MicheleLamberti/mtp-f26-teamc/hw/teamc-carrier/teamc-carrier_render_iso.png

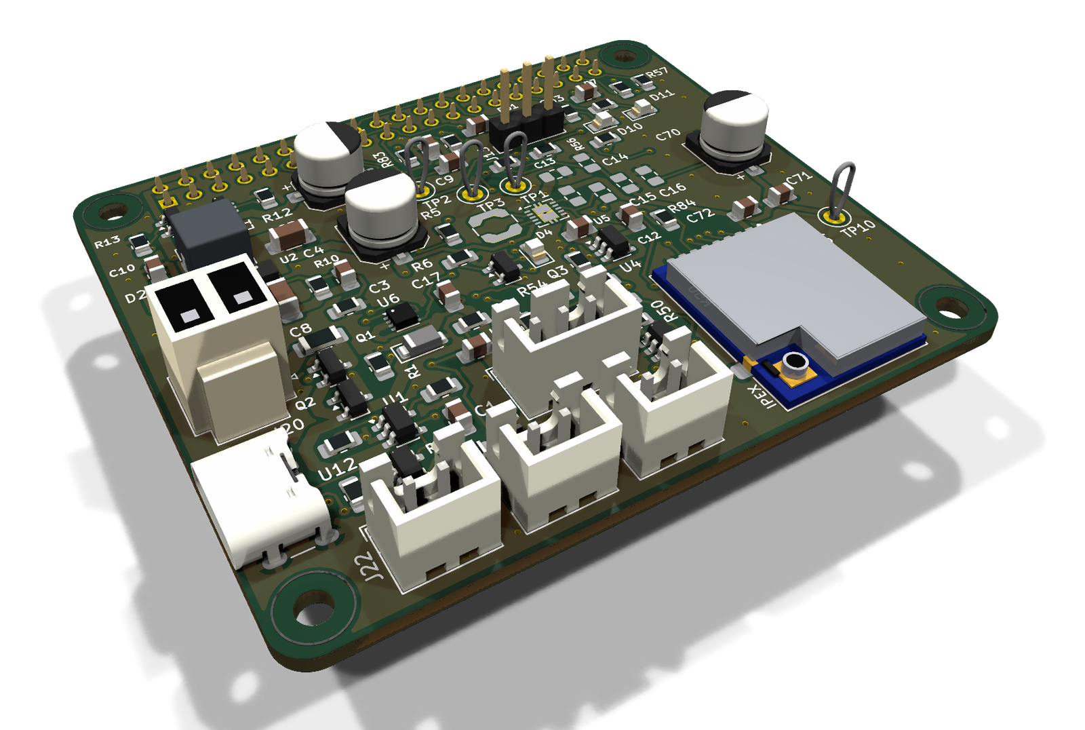
hw/teamc-carrier/teamc-carrier_render_iso.png
