MicheleLamberti/mtp-f26-teamc/hw/teamc-carrier/teamc-carrier_render_stack.png

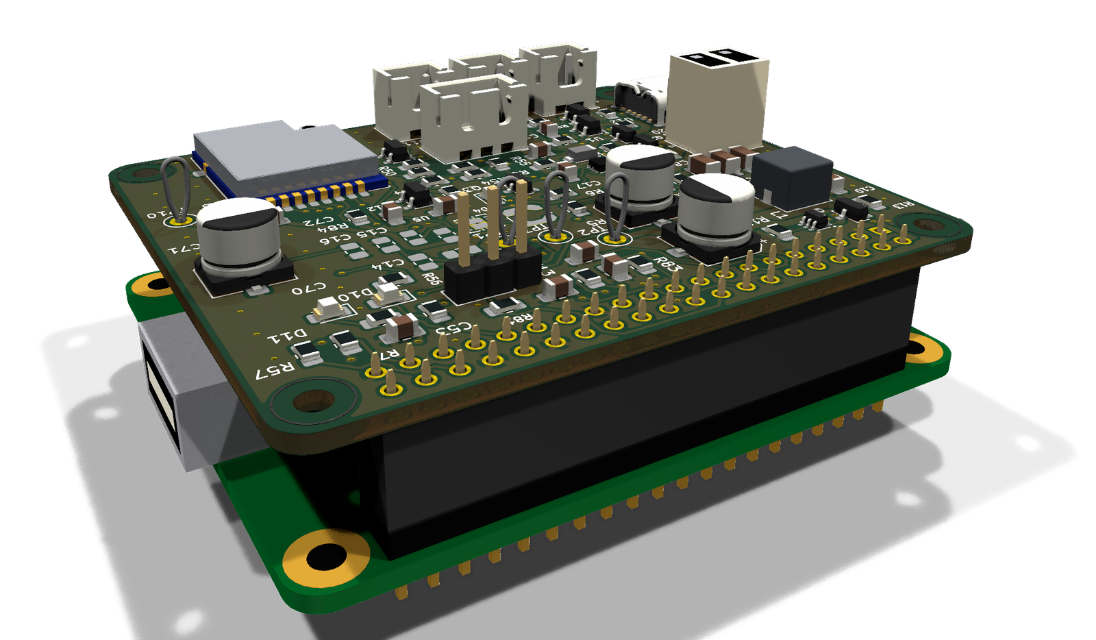
hw/teamc-carrier/teamc-carrier_render_stack.png
