MicheleLamberti/mtp-f26-teamc/docs/task_11_unicode/report/validacion.tex

% Generado por codigo/validar_task11.py. No editar a mano.
\newcommand{\TestsPassed}{172}
\newcommand{\TestsTotal}{172}
\newcommand{\SampleCount}{21}
\newcommand{\FragmentCases}{147}
\newcommand{\PythonVersion}{3.12.14}
