MicheleLamberti/mtp-f26-teamc/radio/HANDOFF_ET.md

# Radio → Electronics handoff — Ebyte E01-ML01SP4 (nRF24L01+ PA/LNA), 2.4 GHz, one omni

From: Radio Team (Santiago, Andrian, Marcos) · To: Electronics Team (Carlos, Michele, Bikash,
Guillem) · Version 0.5, 18-Oct-26 (v0.5: the micro is a Raspberry Pi 3, see `pi3_impact.html`; v0.4: D-R6, higher TX
power while hopping in SRI/MRM; v0.3 SP4 + omni;
v0.2 had two DP5 modules and patches; v0.1 the RFM69 at 868 MHz) ·
Status: **module and antenna decided 13-Oct (Santiago, with Marcos)**, see `DECISIONS.md` D-R2c / D-R5c.

Per the team's division of decisions, the RT picks the transceiver and ET adapts to it and picks
the micro. This sheet lists what the micro and board must provide.

## Part

- **Ebyte E01-ML01SP4**, one per box: genuine Nordic nRF24L01P + PA/LNA, SMD **14.5 × 18 mm** (19-Oct: the
  manual's drawing; the 14.85 in its spec table is a copy-paste error), **8 castellated pads at 1.27 mm on one short
  edge + 2 GND half-holes on the long edges**, **IPEX (U.FL) antenna socket on the module**. Not the E01C-* parts (Si24R1 clone).
- Antenna (19-Oct): **Ebyte TX2400-FPC-2509** flex (25 × 9 mm, 100 mm cable, IPEX) plugged straight into the module,
  stuck vertically on a box wall. No RF trace or RF connector on our PCB. Fallback if it fails TEST_PLAN T5b: the
  **Molex 146153-0100** (34.9 × 9 mm, same plug), so leave 35 mm on the wall.
- **Ordered 19-Oct (Santiago):** 2 × Raspberry Pi 3 A+; 4 × SP4 from Ebyte (2 with the FPC-2509, 2 with the
  TX2400-JKS-IPX20 rod + IPEX-to-SMA cable for the bench). The two rod-kit SP4s are the spares (same module; move the flex antenna over if a box module dies). Still needed:
  2 × microSD (8–16 GB, A1), a 5.1 V ≥ 2.5 A micro-USB supply for the bench, SMA pads 1–10 dB.

## Electrical interface (Ebyte E01-ML01SP4 user manual, section 3)

| Pad | Signal | Direction (micro) | Notes |
|---|---|---|---|
| 1 | VCC | supply | **2.0–3.6 V, abs. max 3.6 V.** Never the battery rail (Li-ion reaches 4.2 V). ~120 mA peak in TX, 26 mA in RX |
| 2 | CE | out | High = RX on / pulse ≥ 10 µs = send one frame |
| 3 | CSN | out | SPI chip select, active low |
| 4 | SCK | out | **SPI mode 0**, MSB first, ≤ 10 MHz (4 MHz default since 23-Oct for the rev B ribbon; plenty: 250 kbps = 31 kB/s) |
| 5 | MOSI | out | |
| 6 | MISO | in | |
| 7 | IRQ | in (optional) | Active low: TX done / RX ready. The driver polls today |
| 8–10 | GND | — | Solid ground under the module; no traces under it on the top layer (Ebyte §4.1) |

The module drives its own PA/LNA switch from the nRF24, so there is **no TXEN/RXEN** to wire.
Footprint (19-Oct, `hw/lib/teamc.pretty/E01-ML01SP4.kicad_mod`, from the manual rev 1.7 §3 drawing): pins 1–8 are
castellations on one 14.5 mm edge (0.80 mm wide, pin 1 on the right in the top view), pins 9/10 are Ø1.5 GND
half-holes on the long edges, 13.0 mm from the pad edge. Measure one module (14.5 mm) before the carrier goes to fab.
The breakout for the bench is ready: `hw/sp4-breakout/` (DRC-clean, gerbers + 1:1 copper PDF).

## Power

- A dedicated **3.3 V LDO for the radio** (e.g. AP2112K-3.3 or TLV75533, ≥ 300 mA) from the switched battery
  rail, with **100 µF + 10 µF + 100 nF** at the module. PA/LNA modules are sensitive to supply noise:
  short, wide VCC/GND, away from the 5 V boost.
- **D-R6 (baseline since 16-Oct):** SRI/MRM hop at up to 20 dBm e.i.r.p., so the same SP4 runs at RF_PWR −12
  or −6 and TX bursts move toward the datasheet's **120 mA**. Same parts; size the LDO,
  the bulk capacitor and the battery path for 120 mA peaks (they already are). No hardware change.
- **Low battery (16-Oct): the LDO is fine, plus four countermeasures.** The LDO regulates 3.3 V down to a cell
  of ~3.4 V (pick a part with **dropout ≤ 0.1 V at 150 mA**: AP2112K-3.3 and TLV75533 both qualify). Below that it
  passes the cell through, ≥ 2.95 V at the cell's 3.0 V protection cutoff, still inside the SP4's 2.0–3.6 V. A Li-ion
  cell spends ~90 % of its charge above 3.4 V at our load. An LDO after the 5 V boost (~60 % efficient overall, boost
  ripple at the PA) or a 5 V battery (2S pack or power bank) would be worse.
  1. **Battery sense (Pi 3, 18-Oct):** the Pi has no ADC, so a **MAX17048** fuel gauge on I2C1 (GPIO 2/3) reads the
     cell voltage and state of charge. The ideal diode into the Pico's VSYS is no longer needed.
  2. **Firmware thresholds** (cell voltage, radio idle): ≥ 3.5 V normal · 3.4–3.5 V status-LED warning "charge before
     the next round" · < 3.4 V at setup: loud warning (never block or stop a round) · < 3.2 V during a round: write the
     received data and progress to the SD card (fdatasync) after every burst, so a brown-out loses nothing. Re-measure
     the thresholds at T0 under the Pi's load: the cell sags more at 0.5–1 A.
  3. **T0** measures the SP4 output with its VCC at 3.6, 3.3 and 3.0 V (`TEST_PLAN.md`).
  4. **Alternative if T0 shows > 2 dB less output at 3.0 V:** a buck-boost (TPS63001 / TPS63020) holds 3.3 V down to
     ~2.5 V at 90–95 %, but needs a ferrite + 10 µF filter at the module and careful layout (switching ripple).
- **The Pi 3's own supply (18-Oct):** a **5.1 V boost rated ≥ 2.5 A** from the cell, always on, into the header 5 V
  pins (2, 4), with a TVS and reverse-polarity protection (that path bypasses the Pi's input protection) and ≥ 100 µF.
  The Pi draws ~0.3–0.6 A at 5 V, so up to ~2 A from the cell near 3.0 V. Below 4.63 V the Pi flags undervoltage.
  Keep the radio LDO on the cell, **never on the Pi's 3V3 pin**, and keep the boost away from the SP4.

## What the micro needs (radio side only)

- One SPI master plus CSN, CE and IRQ: **6 GPIOs** (5 without IRQ).
- A microsecond clock and a busy-wait delay: everything the driver's HAL needs (`fw/nrf24.h`).
- Proposed **Raspberry Pi 3** pins (BCM numbers, header pin): SPI0 SCK GPIO 11 (23), MOSI GPIO 10 (19), MISO GPIO 9
  (21), CSN = SPI0 CE0 GPIO 8 (24, driven by the kernel), CE GPIO 22 (15), IRQ GPIO 24 (18). Wire IRQ on the Pi: its
  edge timestamps make the hop sync accurate under Linux. Full map in `hw/KICAD_SESSION_PROMPT.md`.
- **No WiFi/BT chip on the board** (protocol ban). The Pi 3 carries one (CYW43455 / BCM43438): working assumption
  (18-Oct) is that it is disabled for good (`dtoverlay=disable-wifi`, `disable-bt`) or desoldered; Atenea Q22 asks.

## Breakout from day one

Modules shown at Quick Mode are final, and the SP4 is SMD. So the first bench test already needs the SP4
on a small breakout (lab-made, 1.27 mm pads → 2.54 mm header) or on the carrier PCB. There is no
breadboard-friendly variant of the same part.

## Firmware

`radio/fw/` is a portable C99 driver (no Arduino or vendor dependencies) with host tests
(`make -C radio/fw test`, 244 checks against a mock nRF24). The board only has to implement
`nrf24_hal_t`: select, transfer, ce, delay_us, micros. On the Pi 3 (Linux): spidev with one ioctl per command,
libgpiod for CE/IRQ, `delay_us` as a busy-wait on `CLOCK_MONOTONIC`, `core_freq=250` so the SPI clock is fixed. Register profiles come from
`radio/phy_config.py`. The driver refuses any power setting above RF_PWR −18 dBm (10 mW e.i.r.p. limit),
except for the hopping profile `TEAM_FHSS` (D-R6, the SRI/MRM baseline), which may use −12 (or −6 once T0 shows the PA gain allows it) but must pass a listen-before-talk
check (`nrf24_cca`) before every burst. It needs the 100 ms power-on wait and nothing else from the board.

## Placement and antenna

- Module near the wall that carries the antenna, so the 100 mm cable reaches without strain.
- **Drop test:** secure the U.FL plug on the SP4 (a dot of glue or Kapton tape over it) and tie the cable down
  near the module; a 100 mm cable with a loose box wall can pull the plug off on impact.
- Antenna vertical, **as high in the box as possible** (antenna height is our biggest link-budget lever),
  ≥ 1–2 cm from the battery, the PCB copper, the USB cable and the 5 V boost. With the Pi 3, keep the SP4 at the
  board edge away from the processor (clock harmonics: 6 × 400 MHz = 2400 MHz); T0 checks the noise per hop channel.

## Needed back from ET

1. OK on the SP4, the radio LDO and the pin map.
2. Who makes the SP4 breakout for the first bench test, and when.
3. Power budget check: battery + regulators deliver the TX peak and the Pi's 5 V load without brown-out.
5. Which Pi 3 model (A+ suggested) and how many boards we already have; a desoldering trial on one spare.
4. The box inside height and where the antenna can sit highest.
