MicheleLamberti/mtp-f26-teamc/hw/sp4-breakout/sp4-breakout_render_iso.png

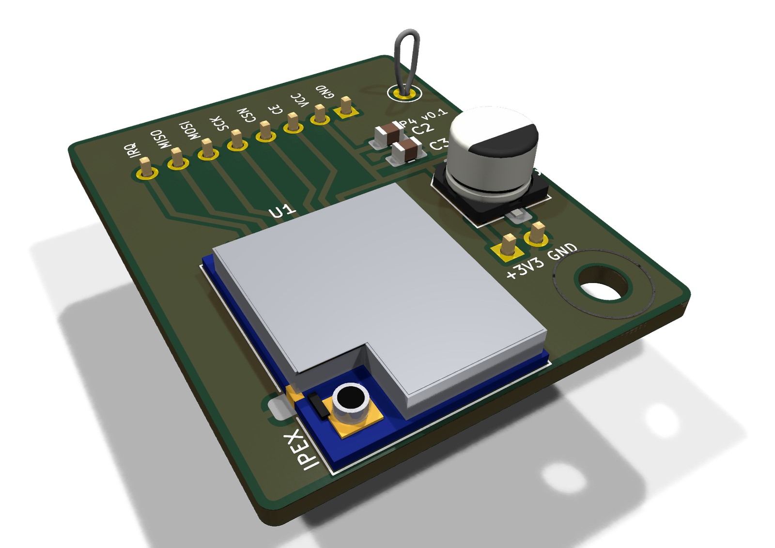
hw/sp4-breakout/sp4-breakout_render_iso.png
