MicheleLamberti/mtp-f26-teamc/hw/teamc-carrier-lab/teamc-carrier-lab_render_iso.png

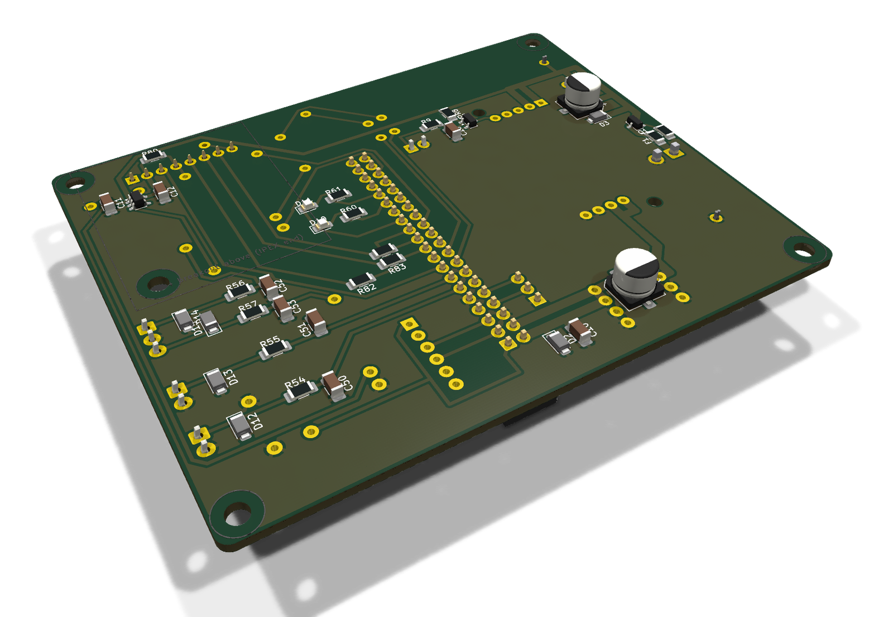
hw/teamc-carrier-lab/teamc-carrier-lab_render_iso.png
