MicheleLamberti/mtp-f26-teamc/hw/teamc-carrier-lab/teamc-carrier-lab_render_top.png

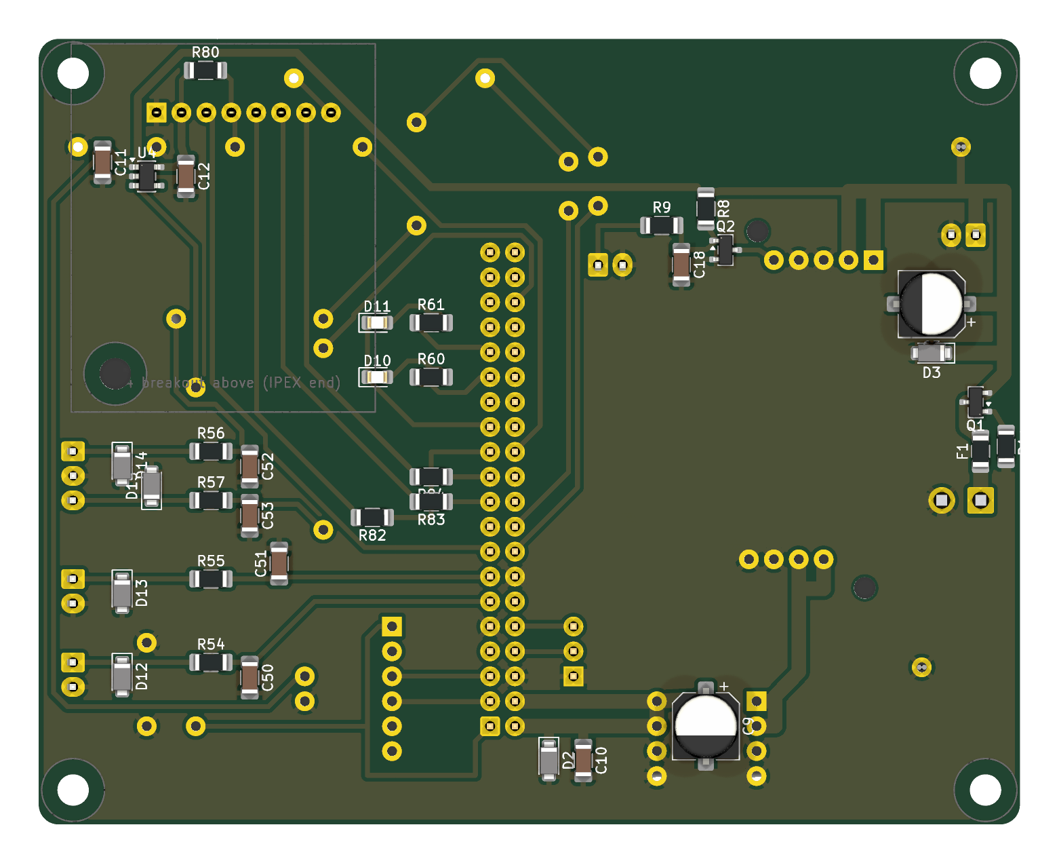
hw/teamc-carrier-lab/teamc-carrier-lab_render_top.png
