MicheleLamberti/mtp-f26-teamc/hw/teamc-carrier-simple/breakout_placement.png

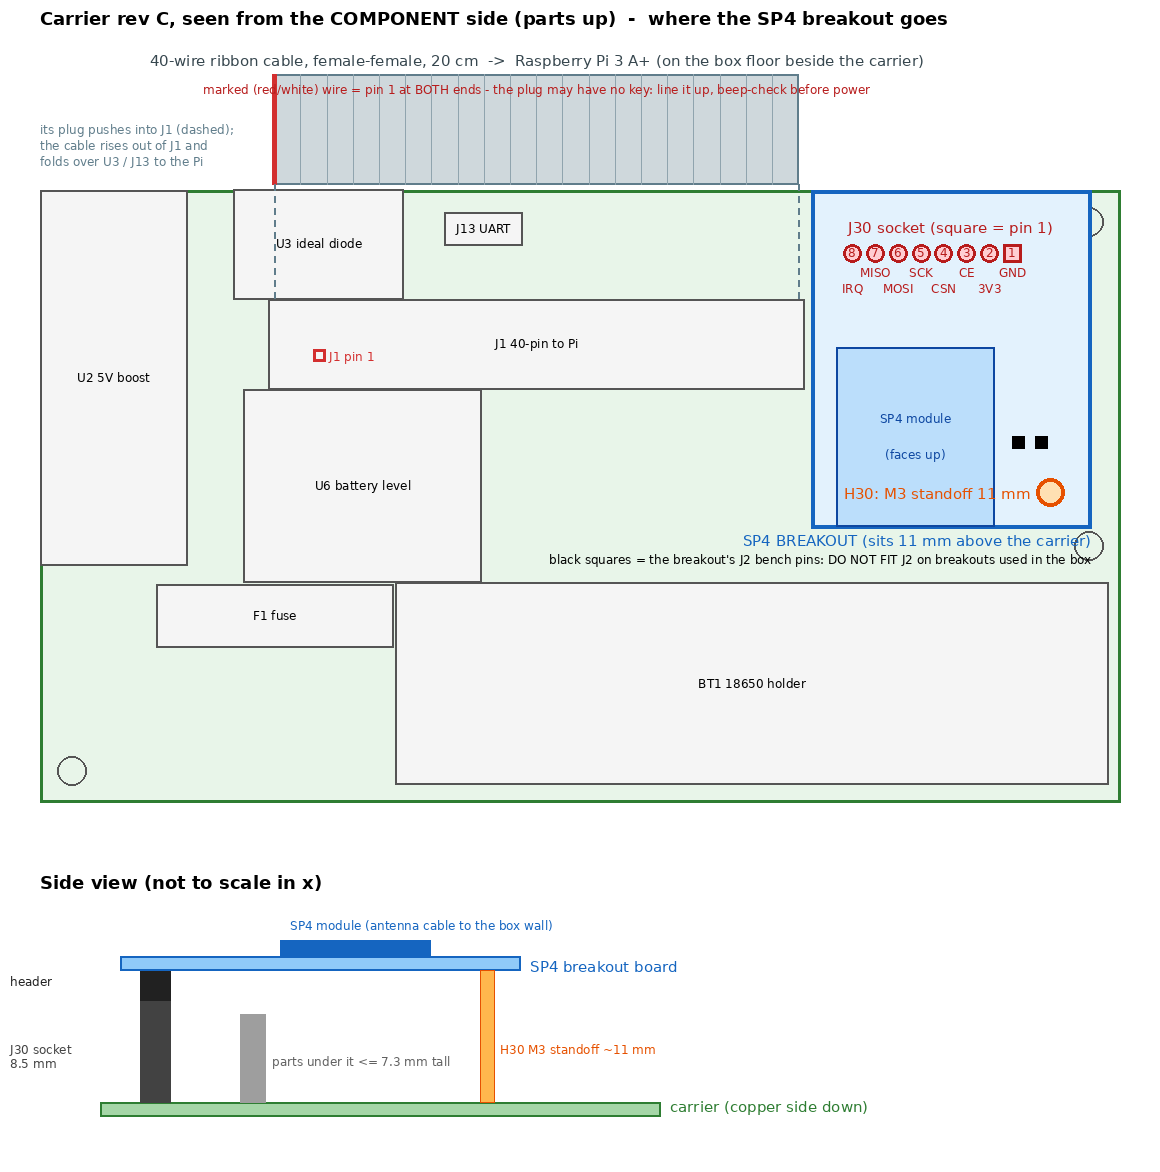
hw/teamc-carrier-simple/breakout_placement.png
