MicheleLamberti/mtp-f26-teamc/hw/teamc-carrier-simple/concept_block_diagram.png

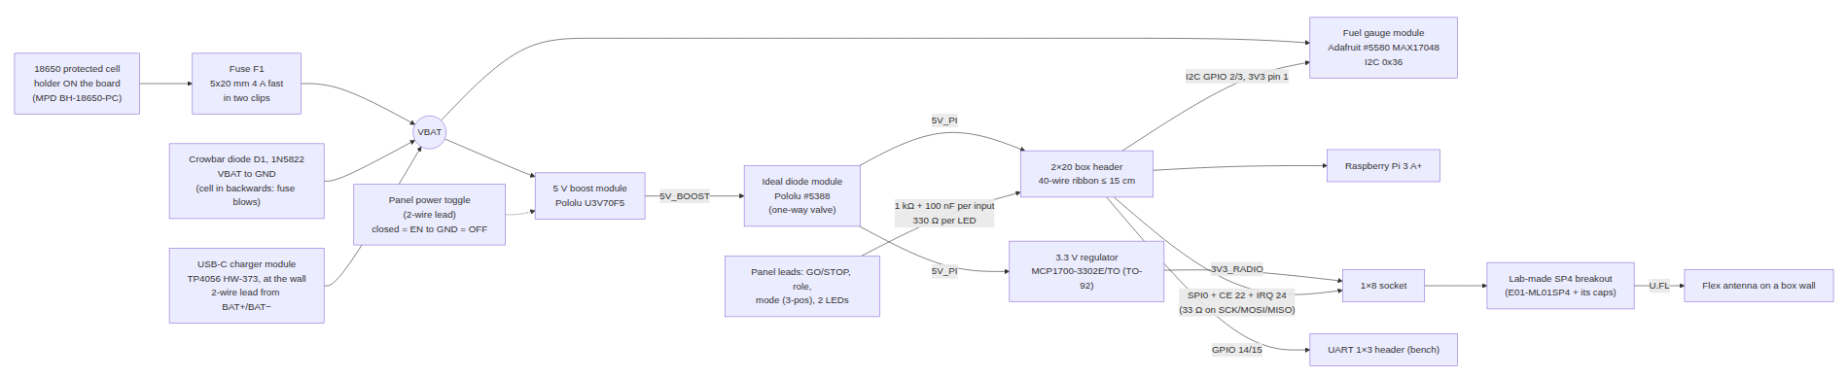
hw/teamc-carrier-simple/concept_block_diagram.png
