MicheleLamberti/mtp-f26-teamc/hw/teamc-carrier-simple/concept_floorplan.png

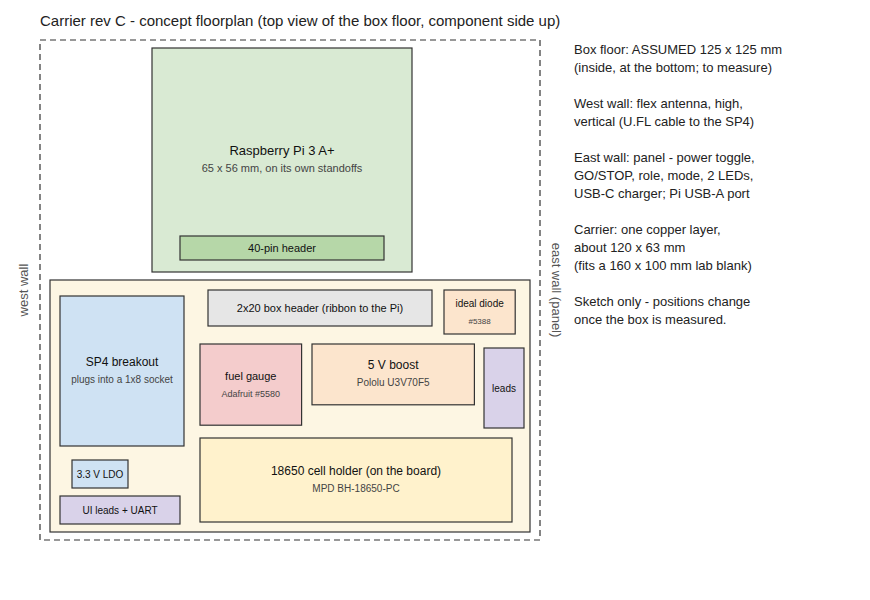
hw/teamc-carrier-simple/concept_floorplan.png
