MicheleLamberti/mtp-f26-teamc/hw/teamc-carrier-simple/teamc-carrier-simple_render_bottom.png

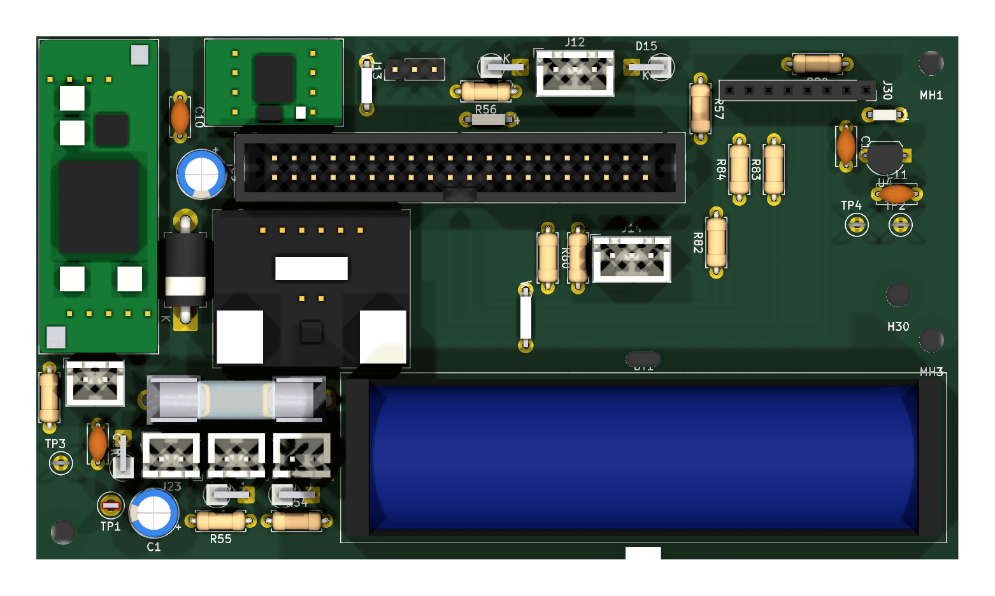
hw/teamc-carrier-simple/teamc-carrier-simple_render_bottom.png
