MicheleLamberti/mtp-f26-teamc/hw/teamc-carrier-simple/teamc-carrier-simple_render_iso.png

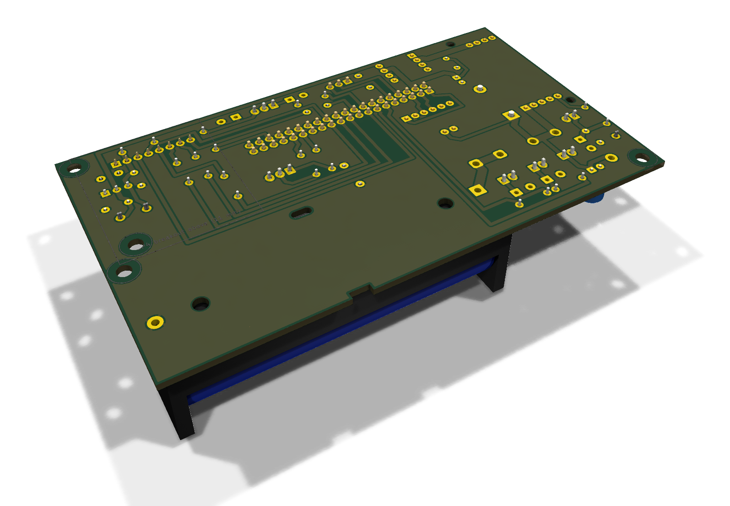
hw/teamc-carrier-simple/teamc-carrier-simple_render_iso.png
