MicheleLamberti/mtp-f26-teamc/hw/teamc-carrier-simple/teamc-carrier-simple_render_top.png

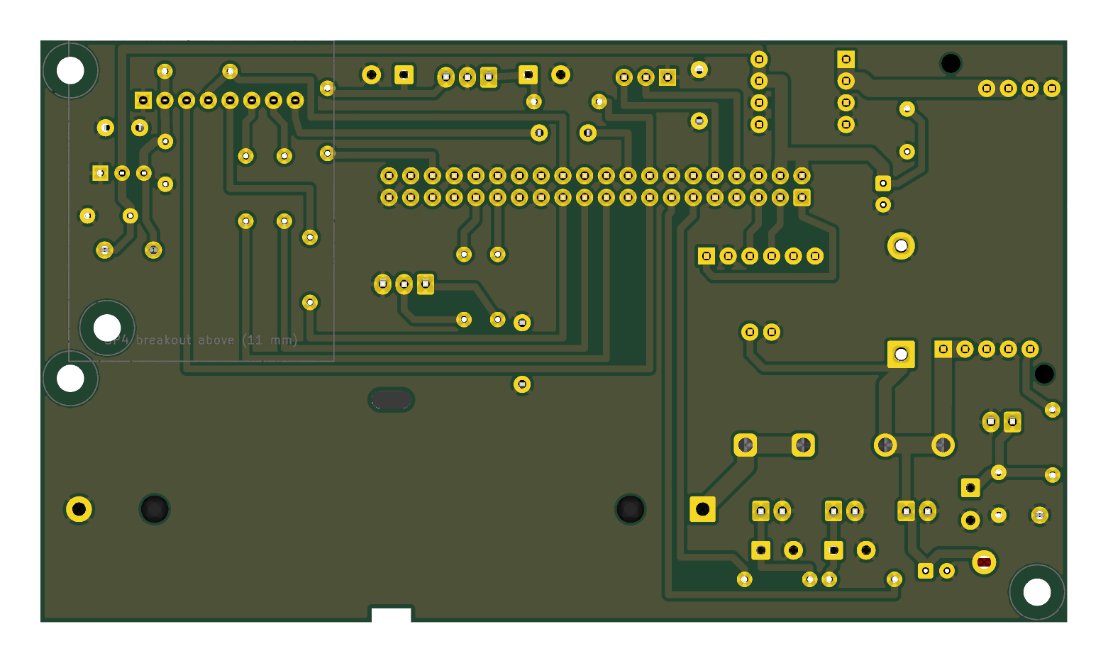
hw/teamc-carrier-simple/teamc-carrier-simple_render_top.png
