MicheleLamberti/mtp-f26-teamc/hw/teamc-carrier/teamc-carrier_render_bottom.png

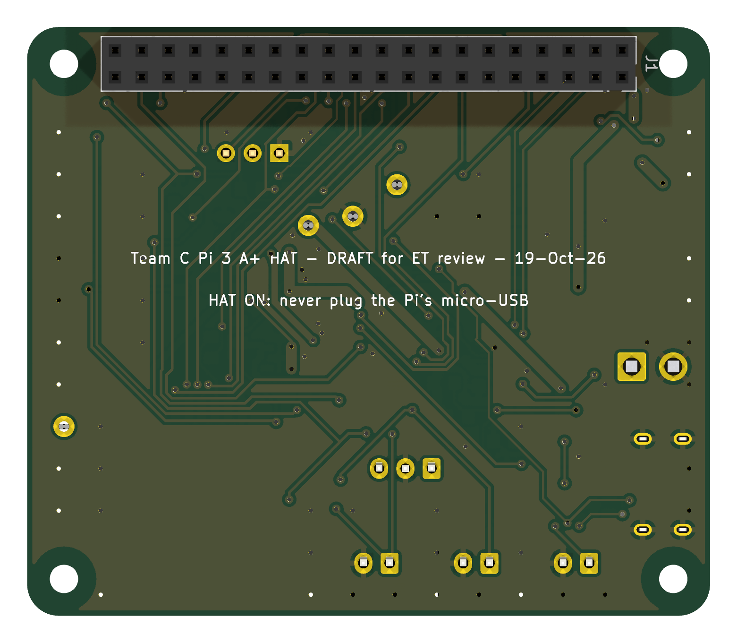
hw/teamc-carrier/teamc-carrier_render_bottom.png
