MicheleLamberti/mtp-f26-teamc/hw/teamc-carrier/teamc-carrier_render_top.png

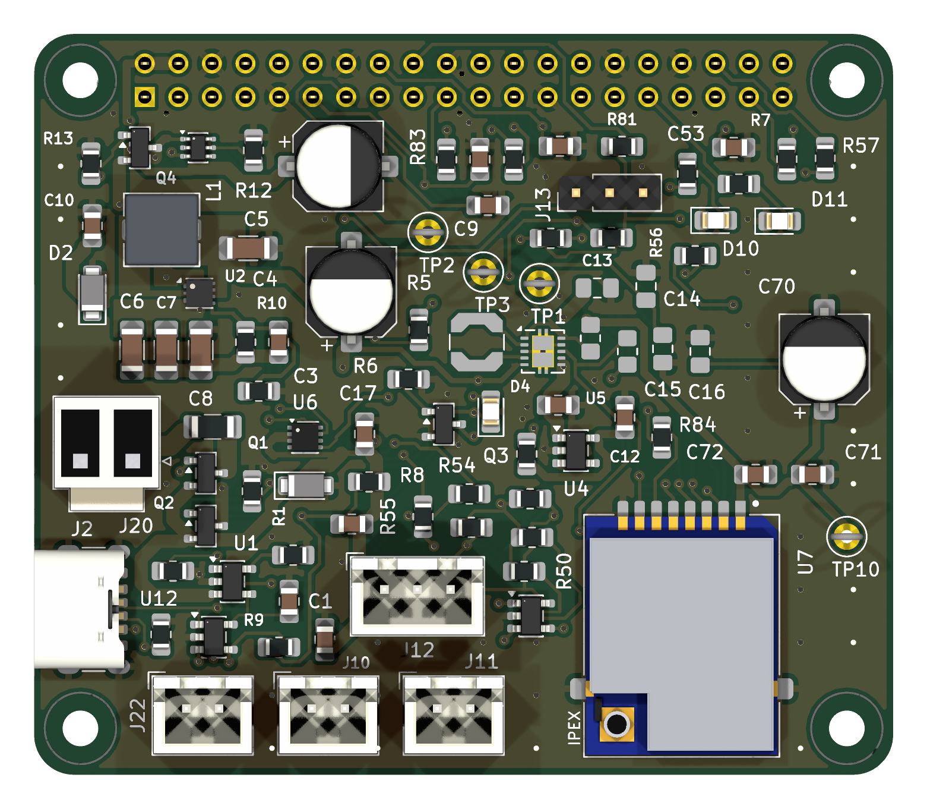
hw/teamc-carrier/teamc-carrier_render_top.png
