MicheleLamberti/mtp-f26-teamc/hw/teamc-carrier-simple/order/order_check.md

# Carrier rev C order check, 3 boards, 24-Oct-26

Prices EUR excl. VAT, read on DigiKey.es product pages today.

| Ref | MPN | Shop | PN | Qty (3 boards) | Unit | Line | Stock (24-Oct-26) | Status | Note |
|---|---|---|---|---|---|---|---|---|---|
| U2 | 2891 (Pololu U3V70F5) | DigiKey | 2183-2891-ND | 3 | 22.7800 | 68.34 | 152 | OK |  |
| U3 | 5388 (Pololu ideal diode) | DigiKey | 2183-5388-ND | 3 | 5.7000 | 17.10 | 500 (marketplace) | OK |  |
| U4 | MCP1700-3302E/TO | DigiKey | MCP1700-3302E/TO-ND | 4 | 0.4400 | 1.76 | 11,755 | OK | 1 spare; first break at 25 |
| BT1 | BH-18650-PC | DigiKey | BH-18650-PC-ND | 3 | 2.9400 | 8.82 | 9,726 | OK | Inside length not verified (datasheet URL 404) |
| D1 | 1N5822 (ST, DO-201AD) | DigiKey | 497-11370-1-ND | 4 | 0.5400 | 2.16 | 14,375 | OK (obsolete) | ST marks it end-of-life; stock fine. Drop-in alt: Taiwan Semi 1N5822 (detail /7366597) |
| D12-D16 | P4KE10A (DO-204AL/DO-41) | DigiKey | 18-P4KE10ACT-ND | 15 | 0.3710 | 5.56 | 1,543 | OK | price at qty-10 break |
| F1 | 3517 (Keystone fuse clip) | DigiKey | 36-3517-ND | 6 | 0.4200 | 2.52 | 50,892 | OK | 5 mm dia clip, 15 A, accepts 5x20 |
| F1 | 0217004.HXP (4 A 5x20 glass) | DigiKey | F2394-ND | 6 | 0.4400 | 2.64 | 4,721 | OK | 1 fitted + 1 spare per box; qty-5 break |
| C1 C9 | EEU-FR1C101 -> KEMET ESS107M016AE2EA | DigiKey | 399-18280-1-ND | 10 | 0.1140 | 1.14 | 14,855 | CHANGED | EEU-FR1C101 is 5.0 mm dia / 2.00 mm leads (wrong footprint). Exact-footprint EEU-FC1C101 (6.3/2.5, P11198-ND) is 0 stock (37 wk). KEMET: 6.3 mm, 2.50 mm, 8.5 mm tall, 105C; need 6, buy 10 at qty-10 break |
| C10 C18 | K104K10X7RF5UH5 | DigiKey | BC2665CT-ND | 10 | 0.1550 | 1.55 | 186,026 | OK | 5.00 mm leads confirmed |
| C11 C12 | FG28X7R1E105KRT06 | DigiKey | 445-173583-1-ND | 10 | 0.1830 | 1.83 | 85,335 | OK | 5.00 mm leads confirmed |
| R9 R54-R57 | MFR-25FBF52-1K | DigiKey | 1.00KXBK-ND | 20 | 0.0370 | 0.74 | 46,691 | OK | 15 needed |
| R60 R61 | MFR-25FBF52-330R | DigiKey | MFR-25FBF52-330R-ND | 10 | 0.0390 | 0.39 | 10,048 (search page) | OK | PN/stock from search listing, not detail page; 6 needed; price at qty 10 per search page |
| R80 | MFR-25FBF52-10K | DigiKey | 10.0KXBK-ND | 10 | 0.0370 | 0.37 | 48,789 | OK | 3 needed |
| R82-R84 | MFR-25FBF52-33R | DigiKey | 13-MFR-25FBF52-33R-ND | 10 | 0.0370 | 0.37 | 12,331 | OK | 9 needed |
| TP1 | 5010 (Keystone red) | DigiKey | 36-5010-ND | 3 | 0.3000 | 0.90 | 257,390 | OK |  |
| J1 | 61204021621 | DigiKey | 732-5401-ND | 3 | 1.0100 | 3.03 | 1,700 | OK |  |
| J30 | PPTC081LFBN-RC | DigiKey | S7006-ND | 3 | 0.5100 | 1.53 | 84,501 | OK | insulation height 8.51 mm |
| J13 + modules | PRPC040SAAN-RC | DigiKey | S1011EC-40-ND | 3 | 1.0800 | 3.24 | 45,098 | OK |  |
| J10 J11 J22 J23 | B2B-XH-A | DigiKey | 455-B2B-XH-A-ND | 12 | 0.0760 | 0.91 | 235,434 | OK | (LF)(SN) is the RoHS suffix of same part; qty-10 break |
| J12 J14 | B3B-XH-A | DigiKey | 455-2248-ND | 6 | 0.1100 | 0.66 | 65,453 | OK |  |
| XHP-2 | XHP-2 | DigiKey | 455-2266-ND | 12 | 0.0520 | 0.62 | 219,487 | OK | qty-10 break |
| XHP-3 | XHP-3 | DigiKey | 455-2219-ND | 6 | 0.0900 | 0.54 | 137,940 | OK |  |
| crimps | SXH-001T-P0.6 | DigiKey | 455-1135-100-ND | 100 | 0.0414 | 4.14 | 6,700 | CHANGED | loose-piece/cut tape not offered; smallest strip is 100 pcs (48 needed). 22-28 AWG |
| pushbutton | PS1024ABLK | DigiKey | EG2011-ND | 3 | 1.4600 | 4.38 | 5,531 | OK |  |
| toggles PWR+ROLE | 100SP1T1B1M1QEH | DigiKey | EG2350-ND | 6 | 2.7000 | 16.20 | 8,552 | OK | 6 = 2 per box (role toggle may stay unfitted) |
| toggle MODE | 100SP3T1B1M1QEH | DigiKey | EG2375-ND | 3 | 4.7500 | 14.25 | 2,223 | OK |  |
| LED green | WP7113GD | DigiKey | 754-1263-ND | 10 | 0.1350 | 1.35 | 91,488 | OK | 3 needed, buy 10 (qty-10 break) |
| LED red | WP7113ID -> WP7113SURDK | DigiKey | 754-WP7113SURDK-ND | 10 | 0.1680 | 1.68 | 11,546 | CHANGED | WP7113ID (754-1264-ND) is 0 stock until 10-Dec-26. SURDK = red diffused T-1 3/4, 630 nm; check R60/R61 value (330R) still OK for brightness |
| LED clips | RTC51 (Kingbright) | DigiKey | 754-RTC51-ND | 6 | 0.4500 | 2.70 | 1,047 | CHANGED | moved from TME (TME min order 10, extra shipment) to DigiKey |
| MH1-3 | 25510 (Keystone M3x10 nylon F/F) | DigiKey | 36-25510-ND | 12 | 0.5900 | 7.08 | 19,042 | CHANGED | now sourced; 4/box (3 holes + 1 spare) |
| H30 | MTS-11 (Essentra M3x11 nylon F/F) | DigiKey | RPC4425-ND | 3 | 0.6800 | 2.04 | 12,230 | CHANGED | now sourced |
| screws M3x6 | 50M030050P006 (Essentra nylon) | DigiKey | RPC7002-ND | 40 | 0.0768 | 3.07 | 61,147 | CHANGED | now sourced; 30 needed + 10 spare; qty-25 break |
| screws M2.5 Pi | 50M025045P006 (Essentra nylon M2.5x6) | DigiKey | 145-50M025045P006-ND | 20 | 0.0940 | 1.88 | 5,784 | CHANGED | 16 needed for 2 Pis + 4 spare; qty-10 break. M2.5 standoffs NOT found on DigiKey |
| U6 | Adafruit 5580 (MAX17048) | Kiwi | ADA-5580 | 3 | 5.6900 | 17.07 | 41 | OK | EUR 6.88 incl VAT |
| ribbon | 40-way F/F GPIO ribbon 20 cm | Kiwi | 1160 (40 pins Rainbow GPIO cable 20cm) | 3 | 2.7900 | 8.37 | 50 | NOT VERIFIED | page does not say F/F or keyed; 20 cm not 15 |
| cell | Keeppower P1835J 3500 mAh protected | nkon.nl | keeppower-18650-3500-li-ion | 3 | 8.2200 | 24.66 | in stock | NOT VERIFIED | EUR 9.95 incl NL VAT; 69.1 mm; 10 A; Spain shipping unconfirmed |
| TP4056 | TP4056 USB-C + DW01A module | Amazon.es | (pick live listing) | 4 | 1.6500 | 6.60 | not read | NOT VERIFIED | estimate: 5-pack ~EUR 8 incl VAT; Amazon.es blocked (503) |

## Totals

| Shop | excl. VAT | incl. 21 % |
|---|---|---|
| DigiKey | 185.50 | 224.46 |
| Kiwi | 25.44 | 30.78 |
| nkon.nl | 24.66 | 29.84 |
| Amazon.es | 6.60 | 7.99 |
| **Grand total** | **242.20** | **293.07** |

DigiKey free delivery to Spain: orders of EUR 50 or more; below that EUR 18 (text on DigiKey.es pages, not the official policy page; confirm at checkout). The DigiKey cart is far above the threshold. The Pololu items (2183- prefix) are DigiKey marketplace items and may ship separately.
No shipping was added for Kiwi, nkon or Amazon.es (not read). Totals above include estimated Amazon.es TP4056 and exclude shipping elsewhere.

## Changes versus the BoM
1. C1 C9: EEU-FR1C101 is 5.0 mm diameter, 2.00 mm lead spacing (DigiKey page), not the 6.3 / 2.50 mm footprint. EEU-FC1C101 (P11198-ND, correct footprint) has 0 stock, 200 expected 18-Dec. Replaced by KEMET ESS107M016AE2EA, 399-18280-1-ND (6.3 mm, 2.50 mm, 8.5 mm tall, 14,855 in stock). Check height against the box and the ripple/ESR needs of the 5 V/3.3 V rail (110 mA at 120 Hz, ESR not given).
2. WP7113ID (red LED): 0 stock until 10-Dec. Replaced by WP7113SURDK.
3. SXH-001T-P0.6: only strips of 100 or more (or reels), so 100 are bought.
4. RTC-51 clips moved from TME to DigiKey (754-RTC51-ND), nylon M3 standoffs and screws, M2.5 screws now sourced on DigiKey.
5. 1N5822 (ST) is marked obsolete but has 14,375 in stock.

## Still blocks ordering
- Protected 18650 fit: MPD BH-18650-PC datasheet (URL 404) not read, so the 69.1 mm Keeppower P1835J fit is unverified. MPD says the holder is designed for cells with protection boards. Check the datasheet or buy one cell first.
- nkon.nl Spain shipping cost and acceptance not confirmed.
- TP4056 USB-C module: Amazon.es blocked (503), so no ASIN/price. Electrokit (85 SEK, out of stock until 30-Oct, Spain not confirmed) and Grobotronics (out of stock) are the only EU pages found. In-stock alternative: Adafruit 4410 (DigiKey 1528-4410-ND, EUR 5.22, 966 pcs) but it is a different board (no DW01A, 0.5 A default); needs ET sign-off.
- 40-way F/F ribbon: Kiwi 1160 not confirmed F/F or keyed, 20 cm vs 15 cm. Kiwi 3016/3017 variants are out of stock or different.
- M2.5 standoffs (4 per Pi): not found on DigiKey; need a source (Amazon.es kit or similar).
- 22 AWG solid hook-up wire and 3.6 mm cable ties: lab stock per BoM; TME FIX-S-3.6X200/BK exists (100 pcs, about EUR 0.02 each) but not worth a TME order.
- 330R resistor PN and stock came from the search listing only (detail page URL for that MPN was not found).

## Update 24-Oct-26 (later) — charger, Pi standoffs, switches
- **Charger:** no TP4056 USB-C module with protection was orderable (TinyTronics 002151 out of stock 2-4 weeks,
  Grobotronics out of stock, Amazon.es AZDelivery 3-pack apparently out of stock, AZ-Delivery shop stock not readable).
  Santiago chose the **Adafruit #4410** (DigiKey 1528-4410-ND, EUR 5.22, 966 in stock) — added to the cart, 3 pcs.
- **M2.5 standoffs:** Kiwi KW-2754 380-piece nylon set (EUR 9.99 excl., 43 in stock) for all Pis; the DigiKey M2.5
  screws (145-50M025045P006-ND) are removed from the cart (the kit has them). Würth 970110155 (732-12996-ND, EUR 1.63)
  was in stock too but costs ~EUR 6.5 per box.
- **Switches to TME** (budget lever): EG2011-ND, EG2350-ND, EG2375-ND removed from the cart; TME PS1024ABLK 1.31,
  100SP1T1B1M1QEH 2.44 (5+), 100SP3T1B1M1QEH 3.26 (USD shown, counted as EUR).
- New totals for 3 boards (excl. VAT): DigiKey ≈ 164.45, Kiwi ≈ 35.43, TME ≈ 28.35, nkon ≈ 24.66 → **≈ 252.89 excl.
  / ≈ 306.0 incl. 21 % VAT** (shipping outside DigiKey not included). BoM per box: **EUR 148.29**.
