MicheleLamberti/mtp-f26-teamc/hw/BOM_revC.csv

ref | qty | value / item | footprint | MPN | manufacturer | supplier | supplier link | stock as read | 3D model source | unit EUR excl. VAT | total EUR | purchased
BT1 | 1 | 18650 protected | Battery:BatteryHolder_MPD_BH-18650-PC | BH-18650-PC (holder; the protected cell is in the BoM off-board) | MPD | DigiKey.es BH-18650-PC-ND | https://www.digikey.es/en/products/detail/mpd-memory-protection-devices/BH-18650-PC/3029216 | 9,726 (23-Oct) | stock kicad-packages3D (fetch_3d.py) | 2.94 | 2.94 | yes
C1 C9 | 2 | 100u 16V | teamc:CP_Radial_D6.3mm_P2.50mm_Pad1.8mm | ESS107M016AE2EA | KEMET | DigiKey.es 399-18280-1-ND (KEMET 6.3 mm, 2.50 mm leads, 8.5 mm tall; qty-10 price) | https://www.digikey.es/en/products/result?keywords=ESS107M016AE2EA | 14,855 (24-Oct) | stock kicad-packages3D model of the footprint it copies (fetch_3d.py) | 0.11 | 0.23 | yes
C10 C18 | 2 | 100n X7R | teamc:C_Disc_D5.0mm_W2.5mm_P5.00mm_Pad1.8mm | K104K10X7RF5UH5 | Vishay | DigiKey.es (Vishay, 5 mm leads; price at qty 10: 6 needed for 3 boxes, buy 10) | https://www.digikey.es/en/products/result?keywords=K104K10X7RF5UH5 | 186,026 (24-Oct) | stock kicad-packages3D model of the footprint it copies (fetch_3d.py) | 0.15 | 0.31 | yes
C11 C12 | 2 | 1u X7R | teamc:C_Disc_D5.0mm_W2.5mm_P5.00mm_Pad1.8mm | FG28X7R1E105KRT06 | TDK | DigiKey.es 445-173583-1-ND (TDK, 5 mm leads; price at qty 10: 6 needed, buy 10) | https://www.digikey.es/en/products/result?keywords=FG28X7R1E105KRT06 | 85,335 (24-Oct) | stock kicad-packages3D model of the footprint it copies (fetch_3d.py) | 0.18 | 0.37 | yes
D1 | 1 | 1N5822 | Diode_THT:D_DO-201AD_P12.70mm_Horizontal | 1N5822 | STMicroelectronics | DigiKey.es (STMicroelectronics) | https://www.digikey.es/en/products/result?keywords=1N5822 | price listed, stock not shown (TME: 221 on 23-Oct) | stock kicad-packages3D (fetch_3d.py) | 0.54 | 0.54 | yes
D12 D13 D14 D15 D16 | 5 | P4KE10A TVS | Diode_THT:D_DO-41_SOD81_P3.81mm_Vertical_CathodeUp | P4KE10A | Littelfuse | DigiKey.es (Littelfuse; price at qty 10, 15 needed for 3 boxes; TME P4KE10A-LF: 0 in stock) | https://www.digikey.es/en/products/detail/littelfuse-inc/P4KE10A/715501 | 1,543 (24-Oct) | stock kicad-packages3D (fetch_3d.py) | 0.37 | 1.85 | yes
F1 | 1 | 4 A fast 5x20 | Fuse:Fuseholder_Clip-5x20mm_Keystone_3517_Inline_P23.11x6.76mm_D1.70mm_Horizontal | 2 x Keystone 3517 clips + 5x20 mm 4 A fast fuse (Littelfuse 0217004.HXP) | Keystone / Littelfuse | DigiKey.es: 2 x Keystone 3517 (EUR 0.42) + Littelfuse 0217004.HXP glass F4A (EUR 0.53; ceramic 0216004.MXP EUR 1.85, 4,517 pcs) | https://www.digikey.es/en/products/result?keywords=0217004.HXP | fuse price listed; clips TME 2,170 (23-Oct) | stock kicad-packages3D (fetch_3d.py) | 1.37 | 1.37 | yes
H30 | 1 | M3 | MountingHole:MountingHole_3.2mm_M3 | M3 x 11 mm nylon standoff F/F + 2 x M3 x 6 nylon screws |  | counted in the off-board mechanics line |  | - | stock kicad-packages3D (fetch_3d.py) | 0.00 | 0.00 | yes
J1 | 1 | RPi GPIO ribbon | teamc:IDC-Header_2x20_P2.54mm_Vertical_Pad2.0mm | 61204021621 (Würth 2x20 shrouded box header, straight THT; any equivalent) | Würth Elektronik | DigiKey.es 732-5401-ND (Würth) | https://www.digikey.es/en/products/result?keywords=61204021621 | 1,700 (24-Oct) | stock kicad-packages3D model of the footprint it copies (fetch_3d.py) | 1.01 | 1.01 | yes
J10 | 1 | GO/STOP button | teamc:JST_XH_B2B-XH-A_1x02_P2.50mm_Vertical_Pad2.0x2.4mm | B2B-XH-A(LF)(SN) | JST | DigiKey.es (JST) | https://www.digikey.es/en/products/result?keywords=B2B-XH-A | price listed (TME B3B: 18,622) | stock kicad-packages3D model of the footprint it copies (fetch_3d.py) | 0.09 | 0.09 | yes
J11 | 1 | role toggle | teamc:JST_XH_B2B-XH-A_1x02_P2.50mm_Vertical_Pad2.0x2.4mm | B2B-XH-A(LF)(SN) | JST | DigiKey.es (JST) | https://www.digikey.es/en/products/result?keywords=B2B-XH-A | price listed (TME B3B: 18,622) | stock kicad-packages3D model of the footprint it copies (fetch_3d.py) | 0.09 | 0.09 | yes
J12 | 1 | mode toggle | teamc:JST_XH_B3B-XH-A_1x03_P2.50mm_Vertical_Pad2.0x2.4mm | B3B-XH-A(LF)(SN) | JST | DigiKey.es (JST) | https://www.digikey.es/en/products/result?keywords=B3B-XH-A | price listed; TME 18,622 (23-Oct) | stock kicad-packages3D model of the footprint it copies (fetch_3d.py) | 0.11 | 0.11 | yes
J13 | 1 | UART console | teamc:PinHeader_1x03_P2.54mm_Vertical_Pad2.0mm | 1x03 male pin header (cut from the 1x40 strip in the BoM) |  | cut from the 1x40 strip (off-board line) |  | - | stock kicad-packages3D model of the footprint it copies (fetch_3d.py) | 0.10 | 0.10 | yes
J14 | 1 | LED lead | teamc:JST_XH_B3B-XH-A_1x03_P2.50mm_Vertical_Pad2.0x2.4mm | B3B-XH-A(LF)(SN) | JST | DigiKey.es (JST) | https://www.digikey.es/en/products/result?keywords=B3B-XH-A | price listed; TME 18,622 (23-Oct) | stock kicad-packages3D model of the footprint it copies (fetch_3d.py) | 0.11 | 0.11 | yes
J22 | 1 | PWR toggle | teamc:JST_XH_B2B-XH-A_1x02_P2.50mm_Vertical_Pad2.0x2.4mm | B2B-XH-A(LF)(SN) | JST | DigiKey.es (JST) | https://www.digikey.es/en/products/result?keywords=B2B-XH-A | price listed (TME B3B: 18,622) | stock kicad-packages3D model of the footprint it copies (fetch_3d.py) | 0.09 | 0.09 | yes
J23 | 1 | charger BAT+/BAT- | teamc:JST_XH_B2B-XH-A_1x02_P2.50mm_Vertical_Pad2.0x2.4mm | B2B-XH-A(LF)(SN) | JST | DigiKey.es (JST) | https://www.digikey.es/en/products/result?keywords=B2B-XH-A | price listed (TME B3B: 18,622) | stock kicad-packages3D model of the footprint it copies (fetch_3d.py) | 0.09 | 0.09 | yes
J30 | 1 | SP4 breakout | teamc:PinSocket_1x08_P2.54mm_Vertical_Pad2.0mm | PPTC081LFBN-RC (Sullins 1x08 female socket, straight THT) | Sullins | DigiKey.es S7006-ND (Sullins) | https://www.digikey.es/en/products/result?keywords=PPTC081LFBN-RC | 84,501 (24-Oct) | stock kicad-packages3D model of the footprint it copies (fetch_3d.py) | 0.51 | 0.51 | yes
MH1 MH2 MH3 | 3 | M3 | MountingHole:MountingHole_3.2mm_M3 | M3 x 10 mm nylon standoff + M3 x 6 nylon screws (to the box floor) |  | counted in the off-board mechanics line |  | - | stock kicad-packages3D (fetch_3d.py) | 0.00 | 0.00 | yes
R9 R54 R55 R56 R57 | 5 | 1k | teamc:R_Axial_DIN0207_L6.3mm_D2.5mm_P7.62mm_Horizontal_Pad1.8mm | MFR-25FBF52-1K | Yageo | DigiKey.es (Yageo) | https://www.digikey.es/en/products/detail/yageo/MFR-25FBF52-1K/13011 | 46,691 (24-Oct) | stock kicad-packages3D model of the footprint it copies (fetch_3d.py) | 0.04 | 0.20 | yes
R60 R61 | 2 | 330 | teamc:R_Axial_DIN0207_L6.3mm_D2.5mm_P7.62mm_Horizontal_Pad1.8mm | MFR-25FBF52-330R | Yageo | DigiKey.es (Yageo) | https://www.digikey.es/en/products/result?keywords=MFR-25FBF52-330R | est. (same series as 1K) | stock kicad-packages3D model of the footprint it copies (fetch_3d.py) | 0.04 | 0.08 | yes
R80 | 1 | 10k | teamc:R_Axial_DIN0207_L6.3mm_D2.5mm_P7.62mm_Horizontal_Pad1.8mm | MFR-25FBF52-10K | Yageo | DigiKey.es (Yageo) | https://www.digikey.es/en/products/result?keywords=MFR-25FBF52-10K | est. (same series as 1K) | stock kicad-packages3D model of the footprint it copies (fetch_3d.py) | 0.04 | 0.04 | yes
R82 R83 R84 | 3 | 33 | teamc:R_Axial_DIN0207_L6.3mm_D2.5mm_P7.62mm_Horizontal_Pad1.8mm | MFR-25FBF52-33R | Yageo | DigiKey.es (Yageo; qty-10 price, buy 10 per value) | https://www.digikey.es/en/products/result?keywords=MFR-25FBF52-33R | price listed | stock kicad-packages3D model of the footprint it copies (fetch_3d.py) | 0.04 | 0.12 | yes
TP1 | 1 | VBAT | TestPoint:TestPoint_Keystone_5010-5014_Multipurpose | 5010 (red) | Keystone | DigiKey.es (Keystone) | https://www.digikey.es/en/products/result?keywords=keystone%205010 | price listed | stock kicad-packages3D (fetch_3d.py) | 0.30 | 0.30 | yes
TP2 | 1 | 5V_PI | TestPoint:TestPoint_Loop_D2.50mm_Drill1.0mm | wire loop (bare tinned wire, ~3 mm high) |  | lab stock (bare tinned copper wire 0.8 mm, ~1.5 cm per loop) |  | - | stock kicad-packages3D (fetch_3d.py) | 0.02 | 0.02 | yes
TP3 | 1 | GND | TestPoint:TestPoint_Loop_D2.50mm_Drill1.0mm | wire loop (bare tinned wire, ~3 mm high) |  | lab stock (bare tinned copper wire 0.8 mm, ~1.5 cm per loop) |  | - | stock kicad-packages3D (fetch_3d.py) | 0.02 | 0.02 | yes
TP4 | 1 | 3V3_RADIO | TestPoint:TestPoint_Loop_D2.50mm_Drill1.0mm | wire loop (bare tinned wire, ~3 mm high) |  | lab stock (bare tinned copper wire 0.8 mm, ~1.5 cm per loop) |  | - | stock kicad-packages3D (fetch_3d.py) | 0.02 | 0.02 | yes
U2 | 1 | Pololu U3V70F5 5V boost | teamc:RevC_Pololu_U3V70F5_Headers | 2891 (U3V70F5) | Pololu | DigiKey.es 2183-2891-ND | https://www.digikey.es/en/products/result?keywords=pololu%202891 | 152 (24-Oct) | hw/lib/teamc.3dshapes/RevC_Pololu_U3V70F5.wrl (gen_3d_revc.py, from Pololu's drawing); Pololu STEP www.pololu.com/file/0J1561 | 22.78 | 22.78 | yes
U3 | 1 | Pololu ideal diode 20A | teamc:RevC_Pololu_IdealDiode_5388_Headers | 5388 (rvp01b) | Pololu | DigiKey.es 2183-5388-ND | https://www.digikey.es/en/products/result?keywords=pololu%205388 | 500 (24-Oct) | hw/lib/teamc.3dshapes/RevC_Pololu_IdealDiode_5388.wrl (gen_3d_revc.py); Pololu STEP www.pololu.com/file/0J2101 | 5.70 | 5.70 | yes
U4 | 1 | MCP1700-3302E/TO | teamc:TO-92_Inline_Wide_Pad1.8mm | MCP1700-3302E/TO | Microchip | DigiKey.es MCP1700-3302E/TO-ND | https://www.digikey.es/en/products/result?keywords=MCP1700-3302E%2FTO | 11,755 (24-Oct) | stock kicad-packages3D model of the footprint it copies (fetch_3d.py) | 0.44 | 0.44 | yes
U6 | 1 | Adafruit MAX17048 fuel gauge | teamc:RevC_Adafruit_MAX17048_5580_Headers | 5580 (Rev B) | Adafruit | Kiwi Electronics ADA-5580 | https://www.kiwi-electronics.com/en/adafruit-max17048-lipoly-liion-fuel-gauge-battery-monitor-11061 | 41 (23-Oct) | hw/lib/teamc.3dshapes/RevC_Adafruit_MAX17048_5580.wrl (gen_3d_revc.py, from Adafruit's board file) | 5.69 | 5.69 | yes
W1 | 1 | wire link 4.0 mm | teamc:RevC_WireLink_L4.0mm | 22 AWG solid tinned copper hook-up wire, PVC insulated (ends stripped) |  | lab stock (insulated solid hook-up wire, ~2 cm per link) |  | - | hw/lib/teamc.3dshapes/RevC_WireLink_unit.wrl, scaled to the link (gen_3d_revc.py) | 0.03 | 0.03 | yes
W2 | 1 | wire link 7.2 mm | teamc:RevC_WireLink_L7.2mm | 22 AWG solid tinned copper hook-up wire, PVC insulated (ends stripped) |  | lab stock (insulated solid hook-up wire, ~2 cm per link) |  | - | hw/lib/teamc.3dshapes/RevC_WireLink_unit.wrl, scaled to the link (gen_3d_revc.py) | 0.03 | 0.03 | yes
W3 | 1 | wire link 6.0 mm | teamc:RevC_WireLink_L6.0mm | 22 AWG solid tinned copper hook-up wire, PVC insulated (ends stripped) |  | lab stock (insulated solid hook-up wire, ~2 cm per link) |  | - | hw/lib/teamc.3dshapes/RevC_WireLink_unit.wrl, scaled to the link (gen_3d_revc.py) | 0.03 | 0.03 | yes
W4 | 1 | wire link 5.7 mm | teamc:RevC_WireLink_L5.7mm | 22 AWG solid tinned copper hook-up wire, PVC insulated (ends stripped) |  | lab stock (insulated solid hook-up wire, ~2 cm per link) |  | - | hw/lib/teamc.3dshapes/RevC_WireLink_unit.wrl, scaled to the link (gen_3d_revc.py) | 0.03 | 0.03 | yes
(off-board) | 1 | Raspberry Pi 3 Model A+ (WiFi/BT disabled or removed, Atenea Q22) |  |  |  | bought 19-Oct; market price Kiwi EUR 27.53 incl. VAT = 22.75 excl. | https://www.kiwi-electronics.com/en/raspberry-pi-3-model-aplus-3913 | out of stock at Kiwi (24-Oct) |  | 22.75 | 22.75 | yes
(off-board) | 1 | microSD SanDisk Ultra 32 GB A1 (half a twin pack) |  |  |  | bought 19-Oct (est.) |  | - |  | 6.00 | 6.00 | yes
(off-board) | 1 | Ebyte E01-ML01SP4 + TX2400-FPC-2509 flex antenna (bundle) |  |  |  | ebyteiot.com, bought 19-Oct |  | - |  | 3.60 | 3.60 | yes
(off-board) | 1 | SP4 breakout: lab PCB (rules EUR 15) + 100 uF, 10 uF, 100 nF, 1x08 + 1x02 headers (hw/sp4-breakout) |  |  |  | UPC lab + generic |  | - |  | 16.00 | 16.00 | no
(off-board) | 1 | Protected 18650 Li-ion cell >= 3000 mAh, button top, ~69 mm (e.g. Keeppower P1835J, Nitecore NL1835) |  |  |  | nkon.nl Keeppower P1835J 3500 mAh (EUR 8.22 excl.; alt. tinytronics.nl EUR 9.50) | https://www.nkon.nl/en/keeppower-18650-3500-li-ion.html | in stock (24-Oct); fit in BH-18650-PC not verified |  | 8.22 | 8.22 | yes
(off-board) | 1 | Spare 5x20 mm 4 A fast glass fuse Littelfuse 0217004.HXP (keep it in the box) |  |  |  | DigiKey.es F2394-ND | https://www.digikey.es/en/products/result?keywords=0217004.HXP | 4,721 (24-Oct) |  | 0.44 | 0.44 | yes
(off-board) | 1 | USB-C charger Adafruit Micro-Lipo #4410 at the box wall (500 mA jumper closed; TP4056 boards out of stock 24-Oct) |  |  |  | DigiKey.es 1528-4410-ND (also Kiwi) | https://www.digikey.es/en/products/result?keywords=1528-4410-ND | 966 (24-Oct) |  | 5.22 | 5.22 | yes
(off-board) | 1 | 40-way female-female GPIO ribbon, 15-20 cm (fallback: 2 x 3M 89140-0101 IDC sockets + 40-wire flat cable) |  |  |  | Kiwi Electronics 1160 (40-pin rainbow GPIO cable 20 cm) | https://www.kiwi-electronics.com/en/40-pins-rainbow-gpio-cable-20cm-1160 | 50 (24-Oct); F/F + keyed not stated |  | 2.79 | 2.79 | yes
(off-board) | 1 | 2.54 mm male header strip 1x40, Sullins PRPC040SAAN-RC (module pins + UART header) |  |  |  | DigiKey.es | https://www.digikey.es/en/products/result?keywords=PRPC040SAAN-RC | price listed |  | 1.08 | 1.08 | yes
(off-board) | 1 | Panel pushbutton E-Switch PS1024ABLK (GO/STOP) |  |  |  | TME (USD price counted as EUR) | https://www.tme.eu/en/details/ps1024ablk/push-button-switches/e-switch/ | 1,379 (24-Oct) |  | 1.31 | 1.31 | yes
(off-board) | 1 | Panel toggle E-Switch 100SP1T1B1M1QEH (power: closed = OFF) |  |  |  | TME (qty-5 price, USD as EUR) | https://www.tme.eu/en/details/100sp1t1b1m1qeh/toggle-switches/e-switch/ | 654 (24-Oct) |  | 2.44 | 2.44 | yes
(off-board) | 1 | Panel toggle E-Switch 100SP1T1B1M1QEH (role TX/RX; may stay unfitted, Atenea Q8) |  |  |  | TME (qty-5 price, USD as EUR) | https://www.tme.eu/en/details/100sp1t1b1m1qeh/toggle-switches/e-switch/ | 654 (24-Oct) |  | 2.44 | 2.44 | yes
(off-board) | 1 | Panel toggle E-Switch 100SP3T1B1M1QEH ON-OFF-ON (mode SRI/MRM/NM) |  |  |  | TME (USD price counted as EUR) | https://www.tme.eu/en/details/100sp3t1b1m1qeh/toggle-switches/e-switch/ | 906 (24-Oct) |  | 3.26 | 3.26 | yes
(off-board) | 1 | 5 mm LED green diffused Kingbright WP7113GD (activity) |  |  |  | DigiKey.es 754-1263-ND | https://www.digikey.es/en/products/result?keywords=WP7113GD | 91,488 (24-Oct) |  | 0.20 | 0.20 | yes
(off-board) | 1 | 5 mm LED red diffused Kingbright WP7113SURDK (status; WP7113ID out of stock until Dec) |  |  |  | DigiKey.es 754-WP7113SURDK-ND | https://www.digikey.es/en/products/result?keywords=WP7113SURDK | 11,546 (24-Oct) |  | 0.17 | 0.17 | yes
(off-board) | 2 | 5 mm LED panel clips (2) |  |  |  | DigiKey.es 754-RTC51-ND (Kingbright RTC51) | https://www.digikey.es/en/products/result?keywords=RTC51 | 1,047 (24-Oct) |  | 0.45 | 0.90 | yes
(off-board) | 4 | JST XHP-2 housings (button, role, power, charger) |  |  |  | DigiKey.es | https://www.digikey.es/en/products/result?keywords=XHP-2 | price listed |  | 0.09 | 0.36 | yes
(off-board) | 2 | JST XHP-3 housings (mode, LEDs) |  |  |  | DigiKey.es | https://www.digikey.es/en/products/result?keywords=XHP-3 | price listed |  | 0.09 | 0.18 | yes
(off-board) | 16 | JST SXH-001T-P0.6 crimps (14 + spares) |  |  |  | DigiKey.es | https://www.digikey.es/en/products/result?keywords=SXH-001T-P0.6 | price listed |  | 0.04 | 0.64 | yes
(off-board) | 1 | Hook-up wire 24 AWG for the panel leads, ~1 m |  |  |  | lab stock (market price est.) |  | - |  | 0.50 | 0.50 | no
(off-board) | 1 | M3 x 10 mm nylon standoffs F/F x4 (carrier to the floor) + M3 x 11 mm x1 (breakout) + M3 x 6 nylon screws x10 |  |  |  | DigiKey.es Keystone 25510 (M3x10) + Essentra MTS-11 (M3x11) + 50M030050P006 (M3x6 screws) | https://www.digikey.es/en/products/result?keywords=25510 | 19,042 / 12,230 / 61,147 (24-Oct) |  | 4.40 | 4.40 | yes
(off-board) | 1 | M2.5 nylon standoffs x4 + screws x8 (the Pi on the box floor), from one 380-piece kit for all boxes (share of EUR 9.99) |  |  |  | Kiwi KW-2754 M2.5 black nylon screw + standoff set (380 pcs) | https://www.kiwi-electronics.com/en/m2-5-screw-and-stand-off-set-black-nylon-380-pieces-10252 | 43 (24-Oct) |  | 0.50 | 0.50 | yes
(off-board) | 1 | Cable tie 3.6 mm through the board slots over the cell (drop test) |  |  |  | lab stock (est.) |  | - |  | 0.05 | 0.05 | no
(off-board) | 1 | IKEA 365+ food container 15 x 15 x 7 cm (plastic, 750 ml) with lid |  |  |  | IKEA (est.) |  | - |  | 3.00 | 3.00 | yes
(off-board) | 1 | Hot glue, Kapton tape (U.FL plug, microSD, XH housings), foam |  |  |  | lab stock (est.) |  | - |  | 1.00 | 1.00 | no
(off-board) | 1 | Solder, flux |  |  |  | lab stock (est.) |  | - |  | 0.50 | 0.50 | no
(off-board) | 1 | PCB: carrier rev C milled at the UPC lab (rules: counts EUR 15) |  |  |  | UPC lab |  | - |  | 15.00 | 15.00 | no
TOTAL per box (all items at market price excl. VAT, lab PCB EUR 15) |  |  |  |  |  |  |  |  |  |  | 148.29
of which purchased by the team |  |  |  |  |  |  |  |  |  |  | 115.24
of which owned / lab stock / lab PCB (non-purchased) |  |  |  |  |  |  |  |  |  |  | 33.05
Cap per box (rules): EUR 150. DRAFT rev C; stock and prices read 24-Oct-26 or as noted - re-check before ordering. Shopping list for 2 boxes + 1 spare: hw/REVC_SHOPPING.md (checkpoint 4).
