MicheleLamberti/mtp-f26-teamc/radio/MTP-F26_TeamC_Radio_LinkBudget.xlsx

Sheet: README
MTP-F26 Team C - Radio Team workbook
Owner: Radio Team (Santiago, Andrian, Marcos). Version 0.1, 2026-10-03.
Sheets
Link Budget - AN5142 rows (course-corrected), one column per scenario S1-S28. This is the ANNEX 'Link Budget Analysis' artefact.
Baseline (16-Oct): S24-S26 = SRI/MRM on the E01-ML01SP4 + one omni as adaptive FHSS + LBT at <= 20 dBm e.i.r.p. (UN-85 a, D-R6; S26 = RF_PWR -12 until T0). S23 = NM at 10 mW on one channel. S21-S22 = the 10 mW fixed-channel fallback (and Quick Mode). S27-S28 = option B: the same 20 dBm on one fixed channel without hopping (EN 300 328 PSD exceeded: only with the course's explicit OK).
Height Sweep - same budgets recomputed for antenna heights 0.5-1.5 m.
Throughput - lines delivered in 120 s per radio/data rate; occupied bandwidth check for the 250 kHz 868 sub-band.
Candidates - radio module shortlist with datasheet figures, gotchas and compliance notes.
Regulatory - CNAF 2017 bands usable for a 2-minute continuous round.
Legend
Blue text = input you may change. Black = formula. Green = link to another sheet.
Yellow fill = key assumption that must be replaced by a measurement (antenna gain in box, container loss, multipath, heights).
Green fill = results.
Model
P_R = EIRP + L_FS + L_GB + L0 + LMP + LObs + G_R + LConR. L_GB = 10log10(1 + a² - 2a|cos(2πΔd/λ)|): the course correction removes AN5142's 1/2 factor.
Beyond the breakpoint (x < π/2) loss grows 40 dB/decade and is almost frequency-independent: antenna HEIGHT, TX power and RX sensitivity decide the link.
In the interference zone the |cos| envelope produces artificial nulls; real links fade between -∞ and +6 dB there. Measure.
How to use
1. Change blue cells in 'Link Budget' (e.g. antenna gain after measuring), read the margin rows.
2. The same model is in radio/linkbudget.py for quick what-ifs; radio/build_workbook.py regenerates this file.
3. Replace every yellow assumption with a measured value (tests T2 bench PER, T4/T5 range, T13 spectrum).

Sheet: Link Budget
MTP-F26 Team C - Radio link budget (course-corrected Maxim AN5142 method)
Blue = input, black = formula, yellow = key assumption to confirm by measurement. Losses are entered as NEGATIVE dB (AN5142 convention). Flat-earth uses the course correction (no 1/2 factor) and the course sheet's |cos| worst-case envelope.
Block | Variable | Units | Equation / source | S1 | S2 | S3 | S4 | S5 | S6 | S7 | S8 | S9 | S10 | S11 | S12 | S13 | S14 | S15 | S16 | S17 | S18 | S19 | S20 | S21 | S22 | S23 | S24 | S25 | S26 | S27 | S28
Scenario
Round |  |  | Rules PDF: SRI 70 m, MRM ~260 m, NM hop (distance unknown) | SRI 70 m | SRI 70 m | SRI 70 m | SRI 70 m | SRI 70 m | SRI 70 m | MRM 260 m | MRM 260 m | MRM 260 m | MRM 260 m | NM hop 100 m | NM hop 100 m | MRM 260 m | NM hop 100 m | Bench 70 m | SRI 70 m | SRI 70 m | MRM 260 m | NM hop 100 m | MRM 260 m | SRI 70 m | MRM 260 m | NM hop 100 m | SRI 70 m | MRM 260 m | MRM 260 m | SRI 70 m | MRM 260 m
Radio / configuration |  |  |  | RFM69HCW 868 | 38.4 kbps | RFM69HCW 868 | 100 kbps | Si4463 868 | 100 kbps | CC1101 868 | 38.4 kbps | nRF24 2.4G | 1 Mbps | nRF24 2.4G | 2 Mbps | RFM69HCW 868 | 38.4 kbps | Si4463 868 | 100 kbps | nRF24 2.4G | 250 kbps | nRF24 2.4G | 250 kbps, 8 dBi patches | RFM69HCW 868 | 38.4 kbps, -10 dB obstr. | nRF24 2.4G | 250 kbps, -10 dB obstr. | RFM69HCW 868 | 100 kbps (baseline) | RFM69HCW 868 | 100 kbps, -10 dB obstr. (baseline) | RFM69HCW 869.85 | 100 kbps, +9 dBm (BENCH_5MW) | E01-ML01DP5 2.4G | 250 kbps, patches (not chosen) | E01-ML01DP5 2.4G | 1 Mbps, patches | E01-ML01DP5 2.4G | 250 kbps, patches (not chosen) | E01-ML01DP5 2.4G | 250 kbps, -10 dB obstr. (patches, not chosen) | E01-ML01DP5 2.4G | 250 kbps, 100 mW FHSS (DP5, superseded by S25) | E01-ML01SP4 2.4G | 250 kbps, omni, 10 mW fixed (QM/fallback) | E01-ML01SP4 2.4G | 250 kbps, omni, 10 mW fixed (fallback) | E01-ML01SP4 2.4G | 250 kbps, -10 dB obstr., omni, 10 mW (baseline) | E01-ML01SP4 2.4G | 250 kbps, omni, FHSS 20 dBm (baseline) | E01-ML01SP4 2.4G | 250 kbps, omni, FHSS 20 dBm (baseline) | E01-ML01SP4 2.4G | 250 kbps, omni, FHSS at RF_PWR -12 (until T0) | E01-ML01SP4 2.4G | 250 kbps, omni, 20 dBm fixed ch (option B) | E01-ML01SP4 2.4G | 250 kbps, omni, 20 dBm fixed ch (option B)
Air data rate | R | kbps | Rate the sensitivity refers to | 38.4 | 100.0 | 100.0 | 38.4 | 1000.0 | 2000.0 | 38.4 | 100.0 | 250.0 | 250.0 | 38.4 | 250.0 | 100.0 | 100.0 | 100.0 | 250.0 | 1000.0 | 250.0 | 250.0 | 250.0 | 250.0 | 250.0 | 250.0 | 250.0 | 250.0 | 250.0 | 250.0 | 250.0
Regulatory limit type |  |  | 868: e.r.p. (UN-39); 2.4 GHz: e.i.r.p. (UN-85 b; FHSS UN-85 a) | ERP | ERP | ERP | ERP | EIRP | EIRP | ERP | ERP | EIRP | EIRP | ERP | EIRP | ERP | ERP | ERP | EIRP | EIRP | EIRP | EIRP | EIRP | EIRP | EIRP | EIRP | EIRP | EIRP | EIRP | EIRP | EIRP
Regulatory power limit | Plim | dBm | 500 mW e.r.p. = 27 dBm; 10 mW e.i.r.p. = 10 dBm; FHSS 100 mW = 20 dBm | 27.0 | 27.0 | 27.0 | 27.0 | 10.0 | 10.0 | 27.0 | 27.0 | 10.0 | 10.0 | 27.0 | 10.0 | 27.0 | 27.0 | 7.0 | 10.0 | 10.0 | 10.0 | 10.0 | 20.0 | 10.0 | 10.0 | 10.0 | 20.0 | 20.0 | 20.0 | 10.0 | 10.0
System variables
Frequency | f0 | MHz | 869.525 = centre of 869.40-869.65 MHz | 869.525 | 869.525 | 869.525 | 869.525 | 2440.000 | 2440.000 | 869.525 | 869.525 | 2440.000 | 2440.000 | 869.525 | 2440.000 | 869.525 | 869.525 | 869.850 | 2440.000 | 2440.000 | 2440.000 | 2440.000 | 2441.000 | 2440.000 | 2440.000 | 2440.000 | 2441.000 | 2441.000 | 2441.000 | 2474.000 | 2474.000
Speed of light | c | m/s | constant | 299792458 | 299792458 | 299792458 | 299792458 | 299792458 | 299792458 | 299792458 | 299792458 | 299792458 | 299792458 | 299792458 | 299792458 | 299792458 | 299792458 | 299792458 | 299792458 | 299792458 | 299792458 | 299792458 | 299792458 | 299792458 | 299792458 | 299792458 | 299792458 | 299792458 | 299792458 | 299792458 | 299792458
Wavelength | λ | m | λ = c / f0
Transmitter
PA power | PPA | dBm | Module setting (see Candidates sheet for limits) | 17.0 | 17.0 | 20.0 | 12.0 | 0.0 | 0.0 | 17.0 | 20.0 | 0.0 | 0.0 | 17.0 | 0.0 | 17.0 | 17.0 | 9.0 | 7.0 | 7.0 | 7.0 | 7.0 | 17.0 | 7.0 | 7.0 | 7.0 | 17.5 | 17.5 | 12.0 | 17.5 | 17.5
TX match loss | LMatchT | dB | ASSUMPTION | -0.5 | -0.5 | -0.5 | -0.5 | 0.0 | 0.0 | -0.5 | -0.5 | 0.0 | 0.0 | -0.5 | 0.0 | -0.5 | -0.5 | -0.5 | 0.0 | 0.0 | 0.0 | 0.0 | 0.0 | 0.0 | 0.0 | 0.0 | 0.0 | 0.0 | 0.0 | 0.0 | 0.0
TX connector/cable loss | LConT | dB | 0 if antenna soldered on PCB | 0.0 | 0.0 | 0.0 | 0.0 | 0.0 | 0.0 | 0.0 | 0.0 | 0.0 | 0.0 | 0.0 | 0.0 | 0.0 | 0.0 | 0.0 | -1.5 | -1.5 | -1.5 | -1.5 | -1.5 | -0.5 | -0.5 | -0.5 | -0.5 | -0.5 | -0.5 | -0.5 | -0.5
TX power at antenna | PT | dBm | PT = PPA + LMatchT + LConT
TX antenna gain (in box) | GT | dBi | ASSUMPTION: incl. efficiency/detuning inside container | 0.0 | 0.0 | 0.0 | 0.0 | 2.0 | 2.0 | 0.0 | 0.0 | 2.0 | 8.0 | 0.0 | 2.0 | 0.0 | 0.0 | 0.0 | 4.5 | 4.5 | 4.5 | 4.5 | 4.5 | 2.0 | 2.0 | 2.0 | 2.0 | 2.0 | 2.0 | 2.0 | 2.0
EIRP | EIRP | dBm | EIRP = PT + GT
ERP | ERP | dBm | ERP = EIRP - 2.15
Regulatory check |  |  | Compare ERP or EIRP with limit
Path
Distance | d | m |  | 70 | 70 | 70 | 70 | 70 | 70 | 260 | 260 | 260 | 260 | 100 | 100 | 260 | 100 | 70 | 70 | 70 | 260 | 100 | 260 | 70 | 260 | 100 | 70 | 260 | 260 | 70 | 260
TX antenna height | hTX | m | 70 cm support [RULE 'about 70 cm'] + position in box | 0.75 | 0.75 | 0.75 | 0.75 | 0.75 | 0.75 | 0.75 | 0.75 | 0.75 | 0.75 | 0.75 | 0.75 | 0.75 | 0.75 | 0.75 | 0.75 | 0.75 | 0.75 | 0.75 | 0.75 | 0.75 | 0.75 | 0.75 | 0.75 | 0.75 | 0.75 | 0.75 | 0.75
RX antenna height | hRX | m |  | 0.75 | 0.75 | 0.75 | 0.75 | 0.75 | 0.75 | 0.75 | 0.75 | 0.75 | 0.75 | 0.75 | 0.75 | 0.75 | 0.75 | 0.75 | 0.75 | 0.75 | 0.75 | 0.75 | 0.75 | 0.75 | 0.75 | 0.75 | 0.75 | 0.75 | 0.75 | 0.75 | 0.75
Ground bounce amplitude | a | - | 1 = worst case (course sheet default) | 1.00 | 1.00 | 1.00 | 1.00 | 1.00 | 1.00 | 1.00 | 1.00 | 1.00 | 1.00 | 1.00 | 1.00 | 1.00 | 1.00 | 1.00 | 1.00 | 1.00 | 1.00 | 1.00 | 1.00 | 1.00 | 1.00 | 1.00 | 1.00 | 1.00 | 1.00 | 1.00 | 1.00
Reflection path Δ | Δd | m | Δd = √(d²+(hTX+hRX)²) - √(d²+(hTX-hRX)²)
Ground-bounce phase | x | rad | x = 2π·Δd/λ
Propagation regime |  |  | x < π/2: smooth d^-4 region; else interference zone (|cos| creates artificial nulls)
Free space loss | LFS | dB | LFS = 20·log10(λ / 4πd)
Ground bounce loss | LGB | dB | LGB = 10·log10(1 + a² - 2a·|cos x|) [course-corrected, no 1/2]
Flat earth loss | LFE | dB | LFE = LFS + LGB
Medium / container loss | L0 | dB | ASSUMPTION: IKEA 365+ PP lid/walls; measure open vs closed (T5) | -1.0 | -1.0 | -1.0 | -1.0 | -1.0 | -1.0 | -1.0 | -1.0 | -1.0 | -1.0 | -1.0 | -1.0 | -1.0 | -1.0 | -1.0 | -1.0 | -1.0 | -1.0 | -1.0 | -1.0 | -1.0 | -1.0 | -1.0 | -1.0 | -1.0 | -1.0 | -1.0 | -1.0
Multipath loss | LMP | dB | ASSUMPTION: 0 on open campus paths; AN5142 suggests ≥20 dB in cluttered areas | 0.0 | 0.0 | 0.0 | 0.0 | 0.0 | 0.0 | 0.0 | 0.0 | 0.0 | 0.0 | 0.0 | 0.0 | 0.0 | 0.0 | 0.0 | 0.0 | 0.0 | 0.0 | 0.0 | 0.0 | 0.0 | 0.0 | 0.0 | 0.0 | 0.0 | 0.0 | 0.0 | 0.0
Obstruction loss | LObs | dB | NM: building corner ASSUMED -10 dB | 0.0 | 0.0 | 0.0 | 0.0 | 0.0 | 0.0 | 0.0 | 0.0 | 0.0 | 0.0 | -10.0 | -10.0 | 0.0 | -10.0 | 0.0 | 0.0 | 0.0 | 0.0 | -10.0 | 0.0 | 0.0 | 0.0 | -10.0 | 0.0 | 0.0 | 0.0 | 0.0 | 0.0
Power at RX antenna, free space | PChanFS | dBm | PChanFS = EIRP + LFS + L0
Power at RX antenna, flat earth | PChanFE | dBm | PChanFE = EIRP + LFE + L0 + LMP + LObs
Receiver
RX antenna gain (in box) | GR | dBi | ASSUMPTION | 0.0 | 0.0 | 0.0 | 0.0 | 2.0 | 2.0 | 0.0 | 0.0 | 2.0 | 8.0 | 0.0 | 2.0 | 0.0 | 0.0 | 0.0 | 4.5 | 4.5 | 4.5 | 4.5 | 4.5 | 2.0 | 2.0 | 2.0 | 2.0 | 2.0 | 2.0 | 2.0 | 2.0
RX connector/cable loss | LConR | dB |  | 0.0 | 0.0 | 0.0 | 0.0 | 0.0 | 0.0 | 0.0 | 0.0 | 0.0 | 0.0 | 0.0 | 0.0 | 0.0 | 0.0 | 0.0 | -1.5 | -1.5 | -1.5 | -1.5 | -1.5 | -0.5 | -0.5 | -0.5 | -0.5 | -0.5 | -0.5 | -0.5 | -0.5
RX power, free space | PRFS | dBm | PRFS = PChanFS + GR + LConR
RX power, flat earth | PRFE | dBm | PRFE = PChanFE + GR + LConR
RX sensitivity | Sens | dBm | Datasheet (see source row) | -105.0 | -100.0 | -104.0 | -104.0 | -85.0 | -82.0 | -105.0 | -104.0 | -94.0 | -94.0 | -105.0 | -94.0 | -100.0 | -100.0 | -100.0 | -94.0 | -85.0 | -94.0 | -94.0 | -94.0 | -96.0 | -96.0 | -96.0 | -96.0 | -96.0 | -96.0 | -96.0 | -96.0
Sensitivity source |  |  |  | RFM69HCW datasheet: -105 dBm @38.4 kbps, FDA 40 kHz | ESTIMATE: datasheet stops at 38.4 kbps (-105 dBm); ~-5 dB for 2x bandwidth. Measure on the bench. | Si4463 datasheet: -104 dBm typ @100 kbps GFSK (BER 0.1 %) | CC1101 datasheet: -104 dBm @38.4 kBaud GFSK, 100 kHz filter (PER 1 %) | nRF24L01+ datasheet: -85 dBm @1000 kbps (BER 0.1 %) | nRF24L01+ datasheet: -82 dBm @2000 kbps (BER 0.1 %) | RFM69HCW datasheet: -105 dBm @38.4 kbps, FDA 40 kHz | Si4463 datasheet: -104 dBm typ @100 kbps GFSK (BER 0.1 %) | nRF24L01+ datasheet: -94 dBm @250 kbps (BER 0.1 %) | nRF24L01+ datasheet: -94 dBm @250 kbps (BER 0.1 %) | RFM69HCW datasheet: -105 dBm @38.4 kbps, FDA 40 kHz | nRF24L01+ datasheet: -94 dBm @250 kbps (BER 0.1 %) | ESTIMATE: datasheet stops at 38.4 kbps (-105 dBm); ~-5 dB for 2x bandwidth. Measure on the bench. | ESTIMATE: datasheet stops at 38.4 kbps (-105 dBm); ~-5 dB for 2x bandwidth. Measure on the bench. | ESTIMATE: datasheet stops at 38.4 kbps (-105 dBm); ~-5 dB for 2x bandwidth. Measure on the bench. | nRF24L01+ chip datasheet: -94 dBm @250 kbps; module LNA ignored (Ebyte quotes ~-96 @250k for the sister E01-ML01SP4). Measure in T2. | nRF24L01+ chip datasheet: -85 dBm @1000 kbps; module LNA ignored (Ebyte quotes ~-96 @250k for the sister E01-ML01SP4). Measure in T2. | nRF24L01+ chip datasheet: -94 dBm @250 kbps; module LNA ignored (Ebyte quotes ~-96 @250k for the sister E01-ML01SP4). Measure in T2. | nRF24L01+ chip datasheet: -94 dBm @250 kbps; module LNA ignored (Ebyte quotes ~-96 @250k for the sister E01-ML01SP4). Measure in T2. | nRF24L01+ chip datasheet: -94 dBm @250 kbps; module LNA ignored (Ebyte quotes ~-96 @250k for the sister E01-ML01SP4). Measure in T2. | E01-ML01SP4 datasheet: -96 dBm typ @250 kbps (module with LNA). Measure in T2. | E01-ML01SP4 datasheet: -96 dBm typ @250 kbps (module with LNA). Measure in T2. | E01-ML01SP4 datasheet: -96 dBm typ @250 kbps (module with LNA). Measure in T2. | E01-ML01SP4 datasheet: -96 dBm typ @250 kbps (module with LNA). Measure in T2. | E01-ML01SP4 datasheet: -96 dBm typ @250 kbps (module with LNA). Measure in T2. | E01-ML01SP4 datasheet: -96 dBm typ @250 kbps (module with LNA). Measure in T2. | E01-ML01SP4 datasheet: -96 dBm typ @250 kbps (module with LNA). Measure in T2. | E01-ML01SP4 datasheet: -96 dBm typ @250 kbps (module with LNA). Measure in T2.
Results
Link margin, free space | MFS | dB | MFS = PRFS - Sens
LINK MARGIN, FLAT EARTH | MFE | dB | MFE = PRFE - Sens (design value)
Margin with what-if multipath |  | dB | -20
Receiver noise sanity check (AN5142 sensitivity block)
RX noise figure | NF | dB | ASSUMPTION | 7.0 | 7.0 | 7.0 | 7.0 | 10.0 | 10.0 | 7.0 | 7.0 | 10.0 | 10.0 | 7.0 | 10.0 | 7.0 | 7.0 | 7.0 | 10.0 | 10.0 | 10.0 | 10.0 | 10.0 | 10.0 | 10.0 | 10.0 | 10.0 | 10.0 | 10.0 | 10.0 | 10.0
Operating temperature | T0 | K |  | 290 | 290 | 290 | 290 | 290 | 290 | 290 | 290 | 290 | 290 | 290 | 290 | 290 | 290 | 290 | 290 | 290 | 290 | 290 | 290 | 290 | 290 | 290 | 290 | 290 | 290 | 290 | 290
Effective noise temperature | Te | K | Te = T0·(10^(NF/10) - 1)
Receive bandwidth | BWRX | kHz | ASSUMPTION: channel filter for the chosen rate | 125 | 200 | 200 | 100 | 1000 | 2000 | 125 | 200 | 500 | 500 | 125 | 500 | 200 | 200 | 200 | 500 | 1000 | 500 | 500 | 500 | 500 | 500 | 500 | 500 | 500 | 500 | 500 | 500
Antenna temperature | TAnt | K |  | 300 | 300 | 300 | 300 | 300 | 300 | 300 | 300 | 300 | 300 | 300 | 300 | 300 | 300 | 300 | 300 | 300 | 300 | 300 | 300 | 300 | 300 | 300 | 300 | 300 | 300 | 300 | 300
Boltzmann constant (mantissa) | k | 1e-23 J/K | k = 1.38e-23 J/K (as course sheet); exponent applied in Pn | 1.38 | 1.38 | 1.38 | 1.38 | 1.38 | 1.38 | 1.38 | 1.38 | 1.38 | 1.38 | 1.38 | 1.38 | 1.38 | 1.38 | 1.38 | 1.38 | 1.38 | 1.38 | 1.38 | 1.38 | 1.38 | 1.38 | 1.38 | 1.38 | 1.38 | 1.38 | 1.38 | 1.38
Noise power at RX | Pn | dBm | Pn = 10·log10(k·(TAnt+Te)·BW) + 30
SNR at sensitivity |  | dB | SNR at sensitivity = Sens - Pn (should be ~8-15 dB for FSK)
SNR at PRFE | SNR | dB | SNR = PRFE - Pn
Scenario notes
S1: SRI 70 m | RFM69HCW 868 | 38.4 kbps |  |  | RFM69HCW +17 dBm (+20 dBm only at <=1 % duty cycle per datasheet)
S2: SRI 70 m | RFM69HCW 868 | 100 kbps |  |  | sensitivity at 100 kbps is an ESTIMATE (datasheet gives 38.4 kbps max)
S3: SRI 70 m | Si4463 868 | 100 kbps |  |  | Si4463 typ -104 dBm @100 kbps GFSK (BER 0.1 %)
S4: SRI 70 m | CC1101 868 | 38.4 kbps |  |  | CC1101 +12 dBm max at 868
S5: SRI 70 m | nRF24 2.4G | 1 Mbps |  |  | nRF24L01+ 0 dBm, 2 dBi whips
S6: SRI 70 m | nRF24 2.4G | 2 Mbps |  |  | nRF24L01+ 0 dBm, 2 dBi whips
S7: MRM 260 m | RFM69HCW 868 | 38.4 kbps |  |  | RFM69HCW +17 dBm (+20 dBm only at <=1 % duty cycle per datasheet)
S8: MRM 260 m | Si4463 868 | 100 kbps |  |  | Si4463 typ -104 dBm @100 kbps GFSK (BER 0.1 %)
S9: MRM 260 m | nRF24 2.4G | 250 kbps |  |  | nRF24L01+ 0 dBm, 2 dBi whips
S10: MRM 260 m | nRF24 2.4G | 250 kbps, 8 dBi patches |  |  | nRF24L01+ 0 dBm, 2 dBi whips
S11: NM hop 100 m | RFM69HCW 868 | 38.4 kbps, -10 dB obstr. |  |  | RFM69HCW +17 dBm (+20 dBm only at <=1 % duty cycle per datasheet)
S12: NM hop 100 m | nRF24 2.4G | 250 kbps, -10 dB obstr. |  |  | nRF24L01+ 0 dBm, 2 dBi whips
S13: MRM 260 m | RFM69HCW 868 | 100 kbps (baseline) |  |  | sensitivity at 100 kbps is an ESTIMATE (datasheet gives 38.4 kbps max)
S14: NM hop 100 m | RFM69HCW 868 | 100 kbps, -10 dB obstr. (baseline) |  |  | sensitivity at 100 kbps is an ESTIMATE (datasheet gives 38.4 kbps max)
S15: Bench 70 m | RFM69HCW 869.85 | 100 kbps, +9 dBm (BENCH_5MW) |  |  | 869.70-870.00 MHz: 5 mW e.r.p., no duty-cycle limit; for repeated tests
S16: SRI 70 m | E01-ML01DP5 2.4G | 250 kbps, patches (not chosen) |  |  | E01-ML01DP5 @RF_PWR -18 (~+7 dBm, est.), 1 dB pigtail + 0.5 dB pad, 4.5 dBi FR4 patch
S17: SRI 70 m | E01-ML01DP5 2.4G | 1 Mbps, patches |  |  | E01-ML01DP5 @RF_PWR -18 (~+7 dBm, est.), 1 dB pigtail + 0.5 dB pad, 4.5 dBi FR4 patch
S18: MRM 260 m | E01-ML01DP5 2.4G | 250 kbps, patches (not chosen) |  |  | E01-ML01DP5 @RF_PWR -18 (~+7 dBm, est.), 1 dB pigtail + 0.5 dB pad, 4.5 dBi FR4 patch
S19: NM hop 100 m | E01-ML01DP5 2.4G | 250 kbps, -10 dB obstr. (patches, not chosen) |  |  | E01-ML01DP5 @RF_PWR -18 (~+7 dBm, est.), 1 dB pigtail + 0.5 dB pad, 4.5 dBi FR4 patch
S20: MRM 260 m | E01-ML01DP5 2.4G | 250 kbps, 100 mW FHSS (DP5, superseded by S25) |  |  | UN-85 a) FHSS: 100 mW e.i.r.p.; needs >=15 hop channels + EN 300 328 adaptivity
S21: SRI 70 m | E01-ML01SP4 2.4G | 250 kbps, omni, 10 mW fixed (QM/fallback) |  |  | E01-ML01SP4 @RF_PWR -18 (~+7 dBm, est.), Molex 146153 flex omni 2 dBi in box, 0.5 dB cable
S22: MRM 260 m | E01-ML01SP4 2.4G | 250 kbps, omni, 10 mW fixed (fallback) |  |  | E01-ML01SP4 @RF_PWR -18 (~+7 dBm, est.), Molex 146153 flex omni 2 dBi in box, 0.5 dB cable
S23: NM hop 100 m | E01-ML01SP4 2.4G | 250 kbps, -10 dB obstr., omni, 10 mW (baseline) |  |  | E01-ML01SP4 @RF_PWR -18 (~+7 dBm, est.), Molex 146153 flex omni 2 dBi in box, 0.5 dB cable
S24: SRI 70 m | E01-ML01SP4 2.4G | 250 kbps, omni, FHSS 20 dBm (baseline) |  |  | D-R6 baseline: adaptive FHSS + LBT, UN-85 a) 20 dBm e.i.r.p.; SP4 at RF_PWR -6/-12 (T0 picks), +17.5 dBm max at the IPEX, omni 3 dBi peak -> <= 20.0 dBm e.i.r.p.
S25: MRM 260 m | E01-ML01SP4 2.4G | 250 kbps, omni, FHSS 20 dBm (baseline) |  |  | D-R6 baseline: adaptive FHSS + LBT, UN-85 a) 20 dBm e.i.r.p.; SP4 at RF_PWR -6/-12 (T0 picks), +17.5 dBm max at the IPEX, omni 3 dBi peak -> <= 20.0 dBm e.i.r.p.
S26: MRM 260 m | E01-ML01SP4 2.4G | 250 kbps, omni, FHSS at RF_PWR -12 (until T0) |  |  | D-R6, worst RF_PWR step: -6 would overshoot 20 dBm e.i.r.p., so -12 (~+12 dBm at the IPEX) -> ~14.5 dBm e.i.r.p.
S27: SRI 70 m | E01-ML01SP4 2.4G | 250 kbps, omni, 20 dBm fixed ch (option B) |  |  | Option B (D-R6b): one fixed channel at <= 20 dBm e.i.r.p. with frame-based LBT; PSD exceeds EN 300 328's 10 dBm/MHz, so only with the course's explicit OK
S28: MRM 260 m | E01-ML01SP4 2.4G | 250 kbps, omni, 20 dBm fixed ch (option B) |  |  | Option B (D-R6b): one fixed channel at <= 20 dBm e.i.r.p. with frame-based LBT; PSD exceeds EN 300 328's 10 dBm/MHz, so only with the course's explicit OK

Sheet: Height Sweep
Flat-earth margin (dB) vs common antenna height (both ends) - beyond the breakpoint, margin grows 20·log10(h1·h2)
Each cell recomputes the Link Budget column with hTX = hRX = height in row 4. Values in the 'interference zone' (see Link Budget regime row) can show artificial |cos| nulls.
Scenario \ height (m) | 0.50 | 0.75 | 1.00 | 1.25 | 1.50

Sheet: Throughput
How many lines arrive in one round? (selective-repeat ARQ, block ACK)
File size | 1000000 | B | RULE: about 1 MB
Lines in file | 10000 | lines | RULE: about 10 000 equal-length lines
Round duration | 120 | s | RULE: 2 minutes (SRI, MRM)
Compression ratio (planning) | 2 | x | ASSUMPTION: measure on sample text; 1.0 = none
Usable bandwidth at 869.40-869.65 MHz | 250 | kHz | RULE (CNAF UN-39): whole 250 kHz may be one high-speed channel
Bytes per line
Goodput needed for the whole file, no compression |  | kbps
Goodput needed for the whole file, with planning compression |  | kbps
Configuration | Air rate (kbps) | Payload (B) | Frame overhead (B) | Frames per ACK | ACK frame (B) | Turnaround (ms) | System efficiency | Mod. index h | Frame time (ms) | Cycle time (ms) | Goodput (kbps) | Lines, no compression | Lines, planning compression | Occupied BW est. (kHz) | Fits 250 kHz sub-band? | Frame gap (ms)
868 FSK radio @38.4 kbps | 38.4 | 60 | 13 | 16 | 20 | 1 | 0.85 | 1 |  |  |  |  |  |  |  | 0
868 FSK radio @100 kbps | 100 | 60 | 13 | 16 | 20 | 1 | 0.85 | 1 |  |  |  |  |  |  |  | 0
868 GFSK radio @150 kbps, h=0.5 | 150 | 60 | 13 | 16 | 20 | 1 | 0.85 | 0.5 |  |  |  |  |  |  |  | 0
868 MRM shared: 5 ch x 50 kHz @19.2 kbps | 19.2 | 60 | 13 | 16 | 20 | 1 | 0.85 | 1 |  |  |  |  |  |  |  | 0
nRF24 2.4 GHz @250 kbps | 250 | 28 | 13.125 | 16 | 16.125 | 1 | 0.85 |  |  |  |  |  |  | ~1000-2000 (2.4 GHz, n/a) | n/a | 0.3
nRF24 2.4 GHz @1 Mbps | 1000 | 28 | 13.125 | 16 | 16.125 | 1 | 0.85 |  |  |  |  |  |  | ~1000-2000 (2.4 GHz, n/a) | n/a | 0.3
nRF24 2.4 GHz @2 Mbps | 2000 | 28 | 13.125 | 16 | 16.125 | 1 | 0.85 |  |  |  |  |  |  | ~1000-2000 (2.4 GHz, n/a) | n/a | 0.3
Notes: overhead = preamble + sync + length + 4 B header + CRC-16 (sub-GHz) or nRF24 Enhanced ShockBurst fields (1 B preamble, 5 B address, 9-bit PCF, 2 B CRC). Turnaround = radio TX/RX switch + MCU handling [ASSUMPTION]. System efficiency covers SPI/FIFO service and USB writes [ASSUMPTION]. Occupied bandwidth uses Carson's rule 2Δf + Rb with Δf = h·Rb/2 (an estimate; verify on the spectrum analyser, test T13). The MRM-shared row shows what 868 MHz gives if all teams split 869.4-869.65 MHz.
SRI/MRM baseline (D-R6): adaptive FHSS + LBT at <= 20 dBm e.i.r.p. - nRF24 @250 kbps (row 18)
Hop slot (dwell) | 30 | ms | One 16-frame SR-ARQ window (~22 ms) + guard; COT must stay < 60 ms (EN 300 328 4.3.1.7.2)
Hop + CCA overhead per slot | 0.3 | ms | PLL settle 130 us + RPD needs >= 170 us in RX (the CCA, >= 18 us required)
Slots skipped busy (LBT) | 0.1 | share | ASSUMPTION: campus WiFi + other teams; measure in T14/T17
Goodput with hopping |  | kbps
Lines, no compression
Non-adaptive FHSS at 20 dBm instead (MU <= 10 % -> 10 % duty) |  | kbps | EN 300 328 4.3.1.6: MU = P/100 mW x DC <= 10 %. Too slow for a 2-min round: hence adaptive (LBT).

Sheet: Candidates
Radio module shortlist - datasheet values (verified 2026-10-03) and compliance notes
Module / chip | Band(s) | Max TX power | TX current @max | RX current | Sensitivity (datasheet) | Max data rate | Limits / gotchas | Rule compliance (standard-protocol ban) | Fits our use | Unit price | Source
HopeRF RFM69HCW (Semtech SX1231H), 868 MHz variant | 433 / 868 / 915 MHz variants | +20 dBm (PA_BOOST); +17 dBm without high-power mode | 130 mA @+20; 95 mA @+17 | 16 mA | -118 dBm @1.2 kbps; -114 @4.8 kbps; -105 @38.4 kbps (FDA 40 kHz). No figure above 38.4 kbps. | 300 kbps FSK | +20 dBm limited to 1 % duty cycle (datasheet §3.3.7) -> use +17 dBm for 2-min rounds. 66 B FIFO. No SAW filter. | Proprietary FSK packet radio - LOW risk; confirm on Atenea | SRI/NM/MRM at 868; huge libraries (RadioHead, LowPowerLab) | TO VERIFY (ET to quote Mouser/DigiKey/LCSC) | HopeRF RFM69HCW datasheet v1.1, Tables 2/4/6 and §3.3.7 - https://cdn-shop.adafruit.com/product-files/3076/RFM69HCW-V1.1.pdf
Si4463 modules (e.g. HopeRF RFM26W, NiceRF/Ebyte boards) | 142-1050 MHz | +20 dBm | 85 mA @+20 dBm, 868 MHz | ~10-14 mA (datasheet) | 868/915: -109 dBm @40 kbps; -104 @100 kbps; -97 @500 kbps (GFSK, BER 0.1 %); -88 @1 Mbps 4GFSK | 500 kbps (G)FSK; 1 Mbps 4GFSK | Best sensitivity + power of the group; no duty-cycle note found. Config via WDS-generated register sets (steeper learning curve). | Proprietary radio, but the datasheet advertises IEEE 802.15.4g PHY support -> LOW-MEDIUM risk; ask Atenea | Strongest 868 option for MRM margin | TO VERIFY | Silicon Labs Si4463/61/60-C datasheet Rev 1.0, Table 3 (RX 915/868 MHz) - https://datasheet.octopart.com/SI4463-C2A-GM-Silicon-Labs-datasheet-78834891.pdf
TI CC1101 modules (e.g. Ebyte E07-M1101D) | 300-348 / 387-464 / 779-928 MHz | +12 dBm @868 | 34 mA @+12 dBm | ~15-17 mA | 868: -112 dBm @1.2 kBaud; -104 @38.4; -95 @250 (540 kHz filter); -90 @500 kBaud MSK | 500 kBaud (600 kbps 4-FSK) | Lowest power of the 868 options. 250 kBaud setting needs 540 kHz filter -> does NOT fit the 250 kHz sub-band; practical ceiling ~100 kbps there. | Proprietary - LOW risk | Fine for SRI; thinner MRM margin | TO VERIFY | TI CC1101 datasheet SWRS061I, Tables 4/7 (868/915 MHz) - https://www.ti.com/lit/ds/symlink/cc1101.pdf
Nordic nRF24L01+ (and PA/LNA variants) | 2.400-2.525 GHz | 0 dBm (PA/LNA modules: more, but must be backed off to <=10 dBm e.i.r.p.) | 11.3 mA @0 dBm | ~12-14 mA | -82 dBm @2 Mbps; -85 @1 Mbps; -94 @250 kbps (BER 0.1 %) | 2 Mbps | 32 B max payload; auto-ACK/retransmit in hardware (Enhanced ShockBurst). Many clones on the market - buy from a distributor. | Enhanced ShockBurst is Nordic-proprietary - LOW-MEDIUM risk; confirm on Atenea | Speed for SRI; weak margin at 260 m | TO VERIFY | Nordic nRF24L01+ Product Specification v1.0, Tables 7 and 17 - https://www.sparkfun.com/datasheets/Components/SMD/nRF24L01Pluss_Preliminary_Product_Specification_v1_0.pdf
Not chosen 13-Oct-26 (was the 9-Oct pick): Ebyte E01-ML01DP5 (genuine nRF24L01P + PA/LNA, SMA-K, DIP 2.54 mm) | 2.400-2.525 GHz (use <=2483.5) | +20 dBm; ~+7 dBm at RF_PWR -18 (ESTIMATE, PA ~25 dB gain, no bypass) | ~120 mA (sister SP4) | ~26 mA (sister SP4) | chip -94 dBm @250k / -85 @1M; Ebyte ~-96 @250k for the SP4 (LNA 12 dB, NF 2.5 dB) | 2 Mbps | Lowest setting ~+7 dBm: with a 4.5 dBi patch needs ~0.5-3 dB pad for 10 dBm e.i.r.p.; measure (T0). PA/LNA switched inside the module: MCU needs SPI + CE + CSN + IRQ only. 32 B payload. | Proprietary (Enhanced ShockBurst) - LOW-MEDIUM risk; confirm on Atenea | 2.4 GHz baseline, all modes | ~US$3.9 (Tindie, EBYTE store) - VERIFY lead time to Spain | https://www.cdebyte.com/products/E01-ML01DP5 ; https://voltiq.ru/datasheets/ebyte/E01-ML01SP4.pdf
DECIDED 13-Oct-26: Ebyte E01-ML01SP4 (genuine nRF24L01P + PA/LNA, SMD 14.85 x 18 mm, IPEX) | 2.4 GHz | +20 dBm max; ~+2..+7 dBm at RF_PWR -18 (ESTIMATE, T0) | 120 mA | 26 mA | -96 dBm typ @250k (datasheet) | 2 Mbps | 10 pads, 1.27 mm pitch: VCC, CE, CSN, SCK, MOSI, MISO, IRQ, 3x GND. 2.0-3.6 V. IPEX: the Molex flex omni plugs in directly. Needs a breakout from the first bench test (QM module = final). | Proprietary (Enhanced ShockBurst) - LOW-MEDIUM risk; confirm on Atenea | 2.4 GHz baseline with one omni | VERIFY | https://voltiq.ru/datasheets/ebyte/E01-ML01SP4.pdf
EXCLUDE: Ebyte E01C-* and no-name 'nRF24L01+PA+LNA' boards | 2.4 GHz |  |  |  |  |  | Ebyte's own E01C manual states the chip is a Si24R1 clone (worse receiver, selectivity unknown) |  | Do not buy (bench only) |  | https://atta.szlcsc.com/upload/public/pdf/source/20220121/F2AB78B6B3F0E91D6E5268DDE53AA4EA.pdf
TI CC2500 | 2.400-2.4835 GHz | +1 dBm | 21.5 mA @+1 dBm | ~13-17 mA | -104 dBm @2.4 kBaud; -99 @10 kBaud; -89 @250 kBaud; -83 @500 kBaud | 500 kBaud | Similar class to nRF24 with more modulation control. | Proprietary - LOW risk | Alternative 2.4 GHz option | TO VERIFY | TI CC2500 datasheet, RF receive section - https://www.ti.com/lit/ds/symlink/cc2500.pdf
EXCLUDE: LoRa chips (SX127x/RFM95, SX126x, SX1280, LLCC68) | 433/868/2.4 GHz |  |  |  |  |  |  | LoRa is named as banned on the Session 1 spec slide; even FSK-only use of a LoRa chip is a compliance risk | Do not buy |  | Session #1 slide 'Transceiver Specs (I)'
EXCLUDE: radio SoCs (CC1310/CC1312, nRF52, ESP32, STM32WL...) |  |  |  |  |  |  |  | Contain a microprocessor (second micro module) and/or BLE/ZigBee/LoRa stacks | Do not buy |  | Rules PDF: 'one but only one module including a microprocessor'; standard-protocol ban
EXCLUDE: 915 MHz (US) module variants | 902-928 MHz |  |  |  |  |  |  | 915-921 MHz is mobile/GSM-R spectrum in Spain (CNAF UN-40), not SRD | Buy 868 variants only |  | CNAF 2017 (Orden ETU/1033/2017), notas UN - https://www.boe.es/buscar/doc.php?id=BOE-A-2017-12318

Sheet: Regulatory
Usable unlicensed bands for a 2-minute continuous round (CNAF 2017 notas UN, as the rules require)
Text checked on 2026-10-03 against the BOE publication of CNAF 2017 and the current CNAF 2021; the limits below are identical in both. Duty cycle is assessed over a 1-hour window (ERC/REC 70-03).
Band | CNAF note | Max power | Access condition | 2-min continuous TX OK? | Width | Comment
433.050-434.790 MHz | UN-30 | 1 mW e.r.p. (-13 dBm/10 kHz) | none | Yes, but 1 mW | 1.74 MHz | Too weak.
433.050-434.040 MHz | UN-30 | 10 mW e.r.p. | duty cycle <= 10 % | Yes (120 s < 360 s/h) | 0.99 MHz | λ/4 = 17 cm: does not fit the 15x15x7 cm box without heavy shortening.
868.000-868.600 MHz | UN-39 | 25 mW e.r.p. | LBT+AFA (EN 300 220) or duty cycle <= 1 % | No (1 % = 36 s/h) | 600 kHz
868.700-869.200 MHz | UN-39 | 25 mW e.r.p. | LBT+AFA or duty cycle <= 0.1 % | No | 500 kHz
869.400-869.650 MHz | UN-39 | 500 mW e.r.p. | LBT+AFA or duty cycle <= 10 % | YES (120 s < 360 s/h) | 250 kHz | THE 868 option. 25 kHz channelisation, but the whole band may be one high-speed data channel. One 120 s SRI + one 120 s MRM = 240 s/h for the TX device: compliant.
869.700-870.000 MHz | UN-39 | 5 mW e.r.p. (no DC) / 25 mW (DC <= 1 %) |  | 5 mW only | 300 kHz | Low power.
2400-2483.5 MHz | UN-85 b) | 10 mW e.i.r.p. | none (generic SRD, EN 300 440) | YES | 83.5 MHz | Room for every team on its own channel (MRM). Campus WiFi/BT share the band.
2400-2483.5 MHz | UN-85 a) | 100 mW e.i.r.p.; 100 mW/100 kHz FHSS, 10 mW/MHz other | mitigation techniques (EN 300 328) mandatory | Yes, if mitigation implemented | 83.5 MHz | SRI/MRM baseline since 16-Oct (D-R6, a professor approved 20 dBm): adaptive FHSS + LBT (EN 300 328 4.3.1.7.2: >= 15 hop channels over >= 70 % of the band, CCA at -70 dBm/MHz, COT < 60 ms) = option A. Option B (S27-S28): 20 dBm on one fixed channel with frame-based LBT (COT <= 10 ms); EN 300 328 4.3.2.3 caps non-hopping equipment at 10 dBm/MHz, so our < 1 MHz signal is 5-10 dB over: only with the course's explicit OK. Non-adaptive FHSS: MU <= 10 % (10 % duty at 20 dBm). A professor approved 20 dBm and Atenea Q3 answered yes (16-Oct).
5725-5875 MHz | UN-130 | 25 mW e.i.r.p. | none (generic SRD, EN 300 440) | Yes | 150 MHz | Few cheap non-WiFi modules; higher path loss and container loss. Not shortlisted.
Sources
CNAF 2017 (Orden ETU/1033/2017), notas UN - https://www.boe.es/buscar/doc.php?id=BOE-A-2017-12318
CNAF 2021 (Orden ETD/1449/2021), notas UN - https://www.boe.es/diario_boe/txt.php?id=BOE-A-2021-21346
Rules PDF: 'The system will need to be compliant with limitations according to CNAF 2017 rules (Notas UN CNAF 2017)'
