MicheleLamberti/mtp-f26-teamc/hw/teamc-carrier-simple/teamc-carrier-simple_render_iso_parts.png

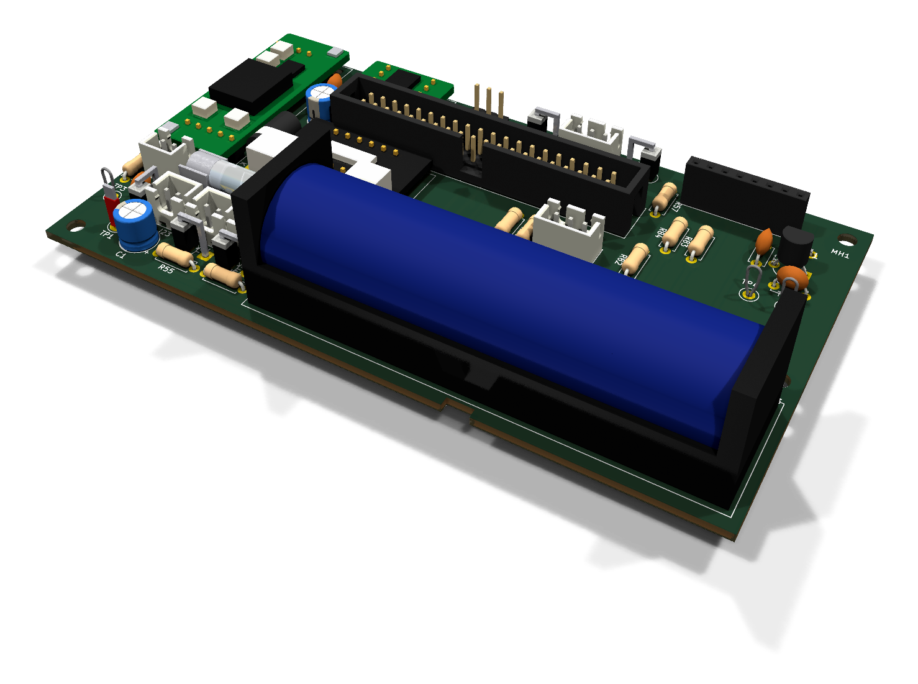
hw/teamc-carrier-simple/teamc-carrier-simple_render_iso_parts.png
