MicheleLamberti/mtp-f26-teamc/hw/teamc-carrier-simple/fab/teamc-carrier-simple_assembly_copper_side.pdf

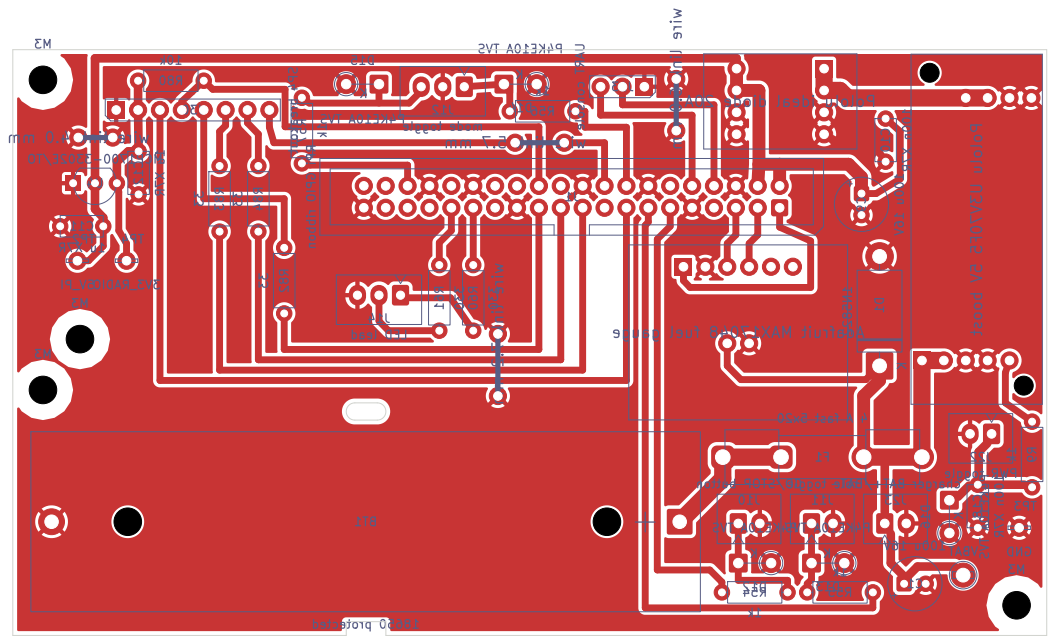
[picture p73: page 1]

D14 100u 16V C9 P4KE10A TVS D16K Pololu U3V70F5 5V boost wire link 7.2 mm

TP1 R60 330 mm 4.0 link wire RPi GPIO ribbon
