MicheleLamberti/mtp-f26-teamc/hw/sp4-breakout/fab/sp4-breakout_schematic.pdf

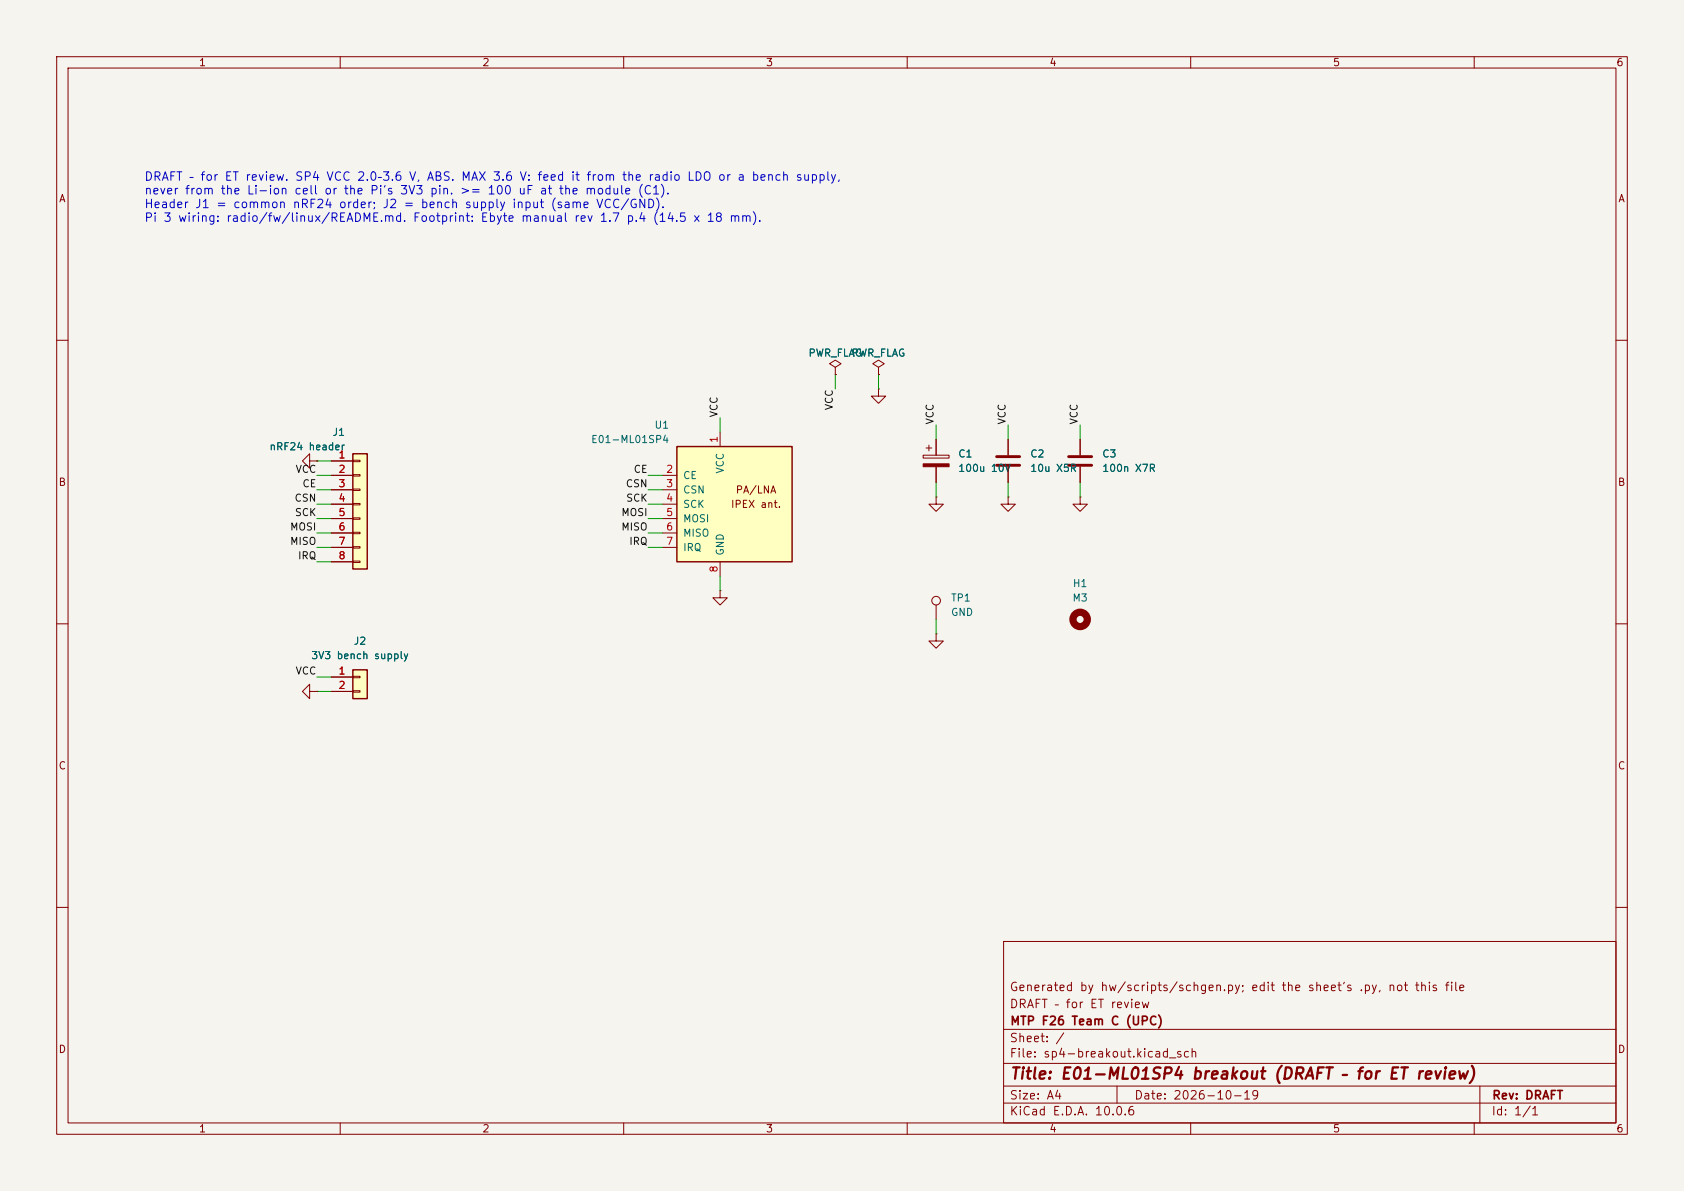
[picture p74: page 1]

DRAFT – for ET review. SP4 VCC 2.0–3.6 V, ABS. MAX 3.6 V: feed it from the radio LDO or a bench supply, never from the Li-ion cell or the Pi's 3V3 pin. >= 100 uF at the module (C1).

Header J1 = common nRF24 order; J2 = bench supply input (same VCC/GND).
Pi 3 wiring: radio/fw/linux/README.md. Footprint: Ebyte manual rev 1.7 p.4 (14.5 x 18 mm). J1

Generated by hw/scripts/schgen.py; edit the sheet's .py, not this file
DRAFT – for ET review
MTP F26 Team C (UPC)
Sheet: /
File: sp4-breakout.kicad_sch
Title: E01-ML01SP4 breakout (DRAFT – for ET review)

Size: A4 | Rev: DRAFT
KiCad E.D.A. 10.0.6 | Id: 1/1
