MicheleLamberti/mtp-f26-teamc/hw/teamc-carrier/fab/teamc-carrier_assembly.pdf

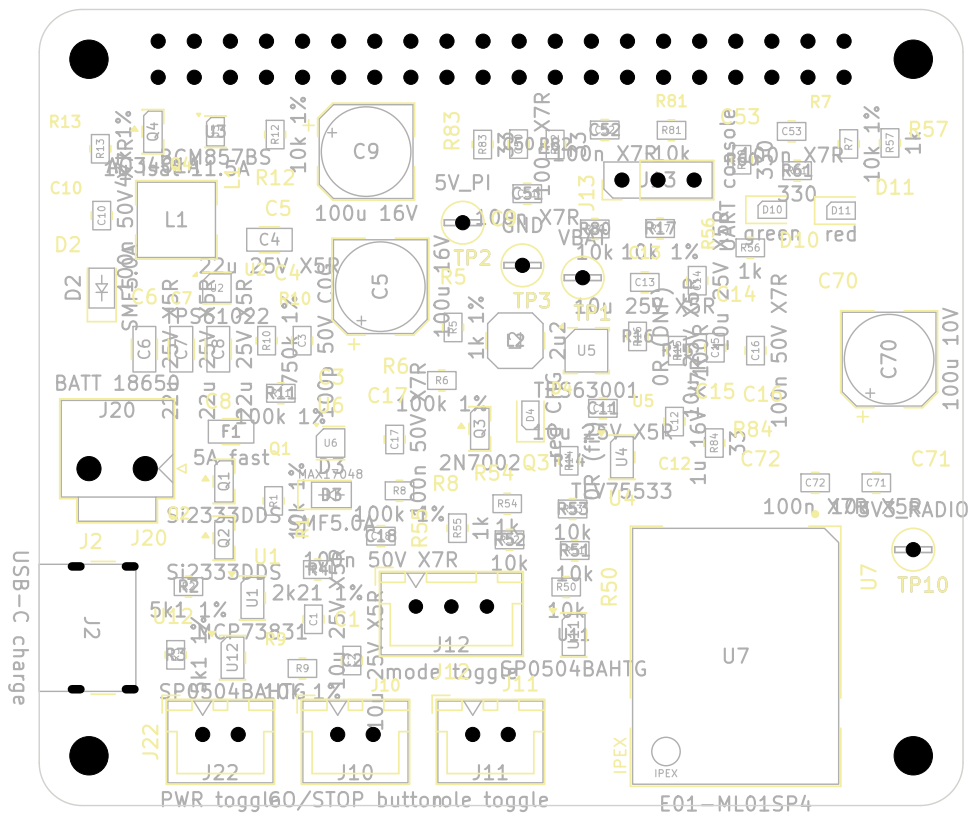
[picture p75: page 1]

Size: A3 | Rev: | F Date: 15 nov 2012
KiCad E.D.A. 10.0.6 | Id: 1/1
