MicheleLamberti/mtp-f26-teamc/hw/teamc-carrier-simple/fab/teamc-carrier-simple_copper_1to1.pdf

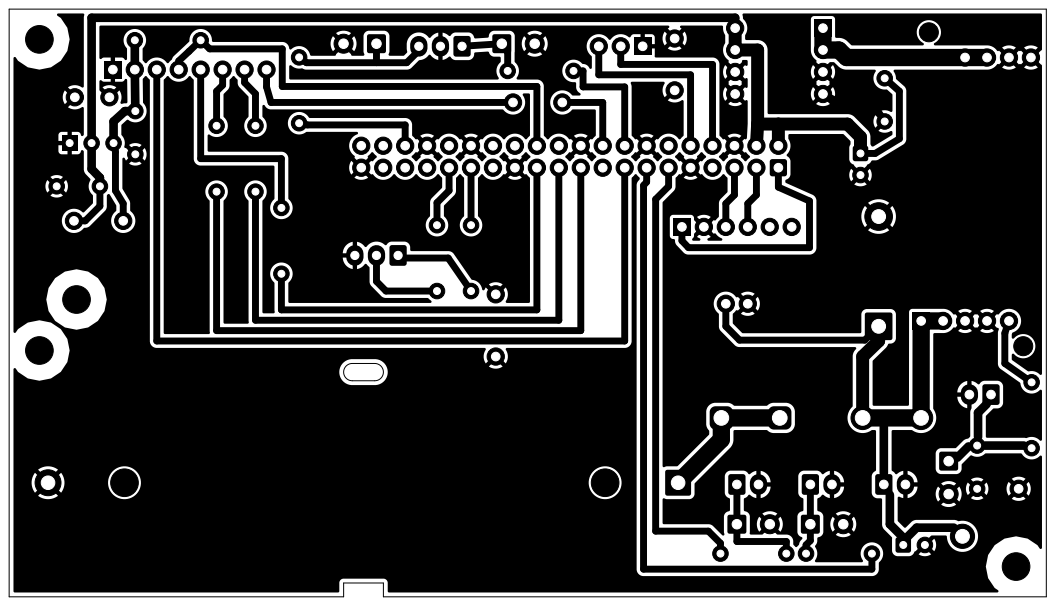
[picture p76: page 1]

Sheet:
File: teamc-carrier-simple.kicad_pcb
Title:

Size: A4 | Rev:
KiCad E.D.A. 10.0.6 | Id: 1/1
