MicheleLamberti/mtp-f26-teamc/hw/teamc-carrier-lab/fab/teamc-carrier-lab_copper_1to1.pdf

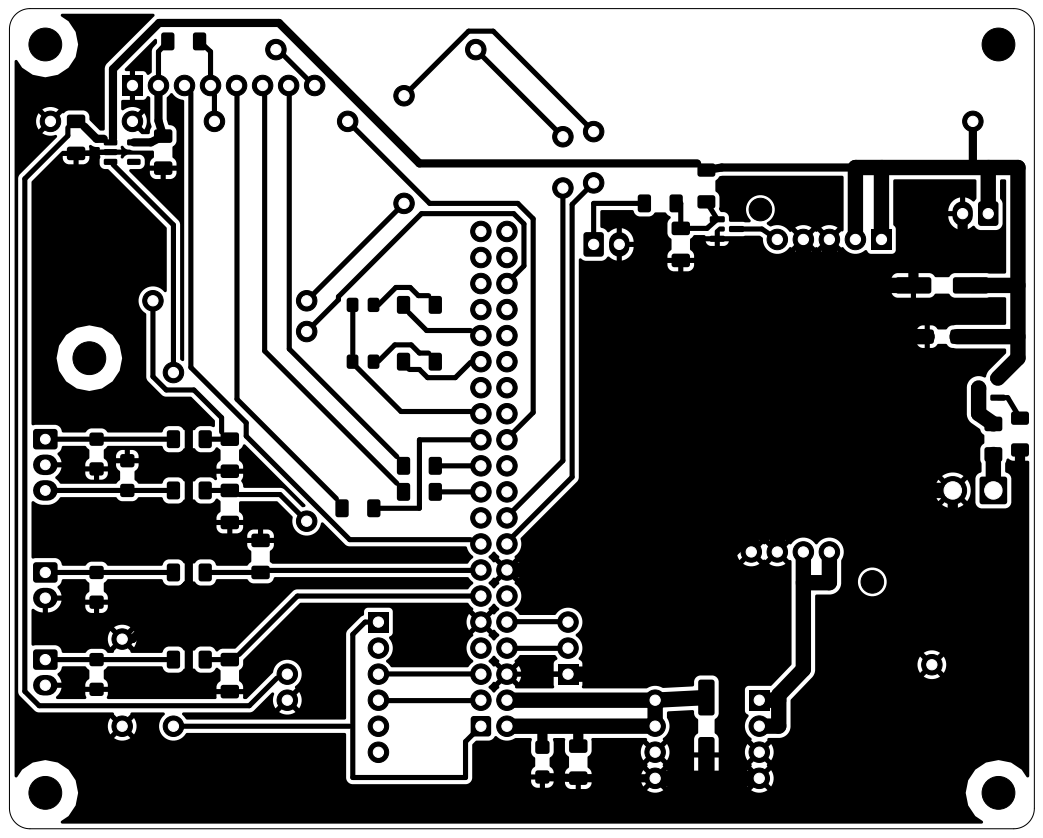
[picture p77: page 1]

Sheet:
File: teamc-carrier-lab.kicad_pcb
Title:

Size: A4 | Rev:
KiCad E.D.A. 10.0.6 | Id: 1/1
