MicheleLamberti/mtp-f26-teamc/hw/sp4-breakout/fab/sp4-breakout_copper_1to1.pdf

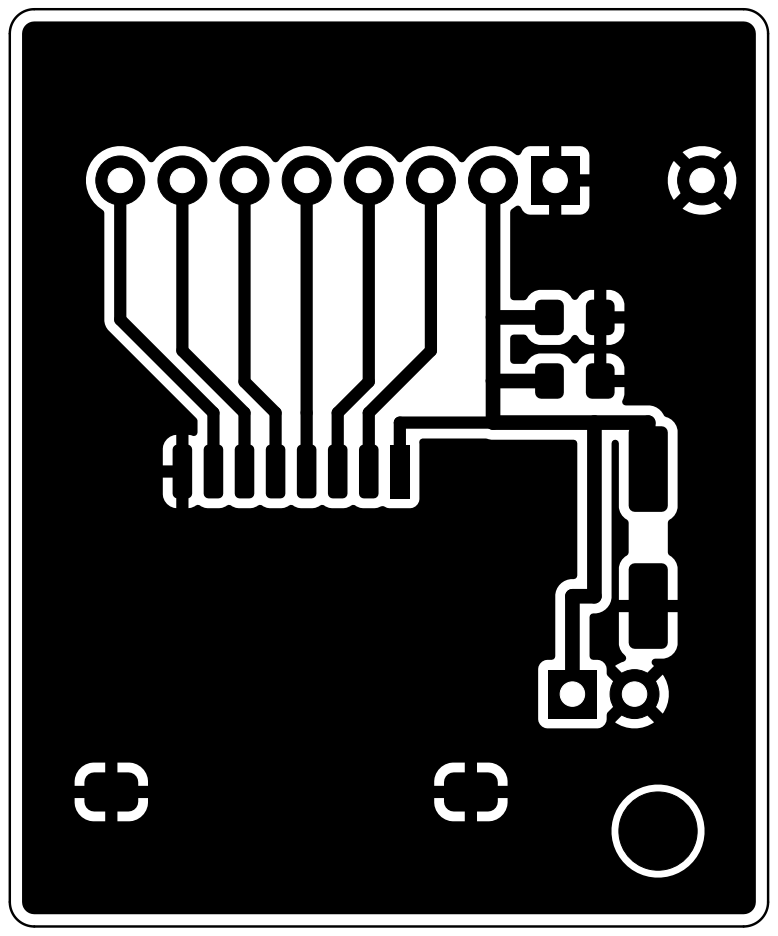
[picture p78: page 1]

MTP F26 Team C (UPC)
Sheet:
File: sp4-breakout.kicad_pcb
Title: E01-ML01SP4 breakout (DRAFT - for ET review)

Size: A4 | Rev:
KiCad E.D.A. 10.0.6 | Id: 1/1
