MicheleLamberti/mtp-f26-teamc/hw/teamc-carrier-simple/fab/teamc-carrier-simple_assembly_component_side.pdf

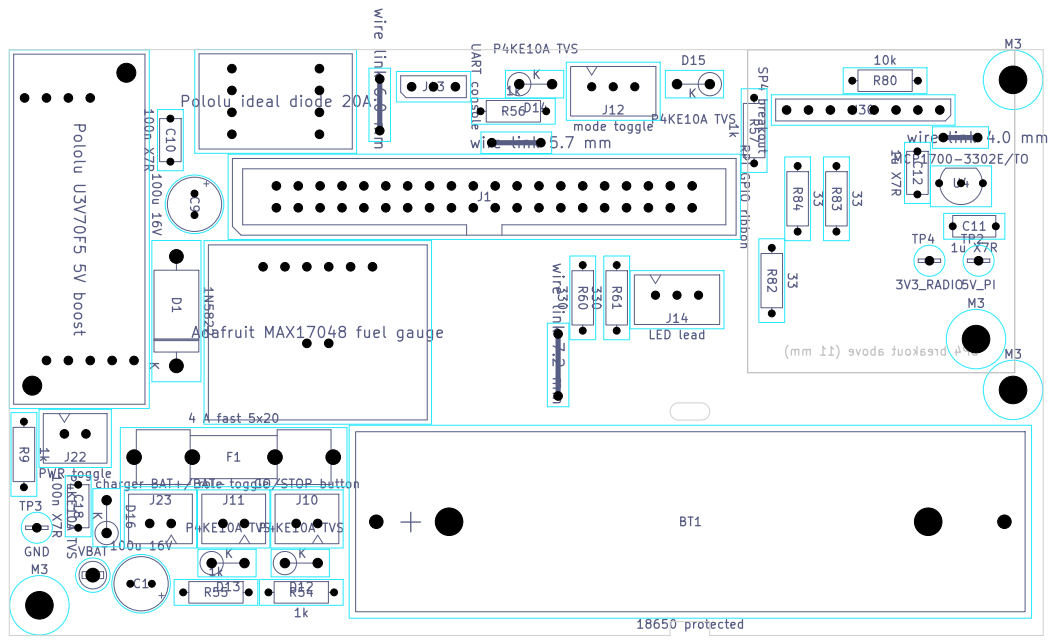
[picture p79: page 1]
