MicheleLamberti/mtp-f26-teamc/hw/teamc-carrier-lab/fab/teamc-carrier-lab_assembly_component_side.pdf

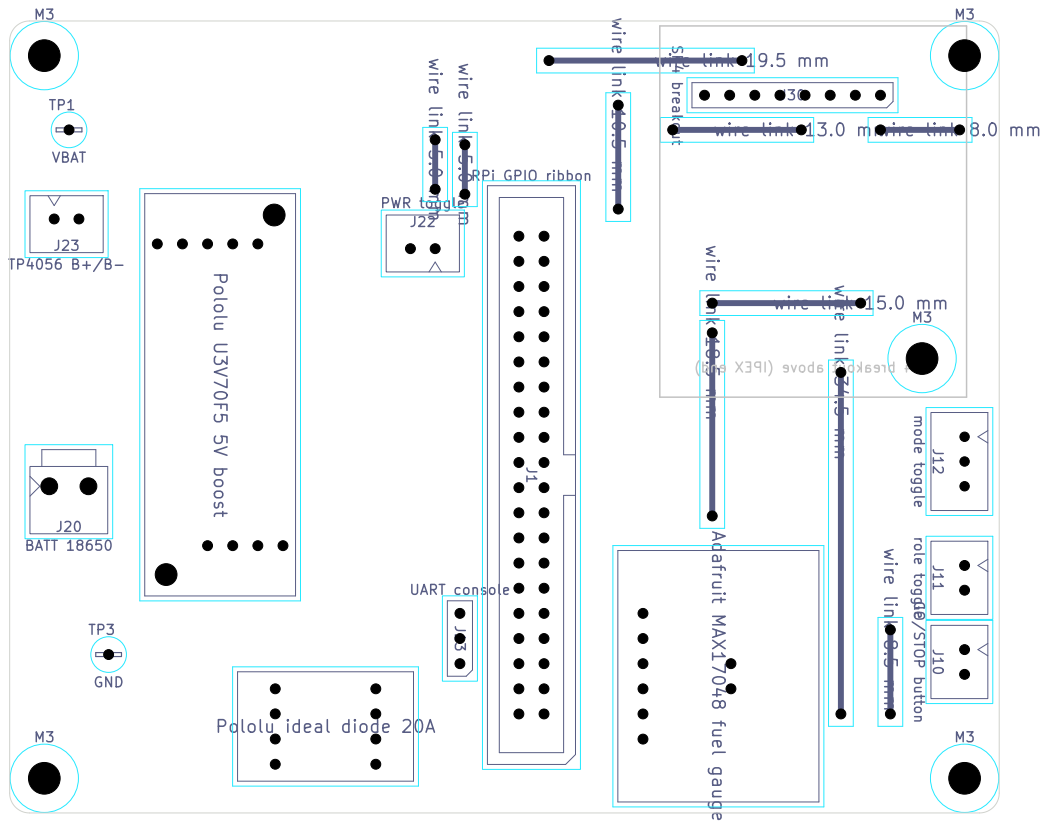
[picture p80: page 1]
