MicheleLamberti/mtp-f26-teamc/hw/teamc-carrier-lab/fab/teamc-carrier-lab_assembly_copper_side.pdf

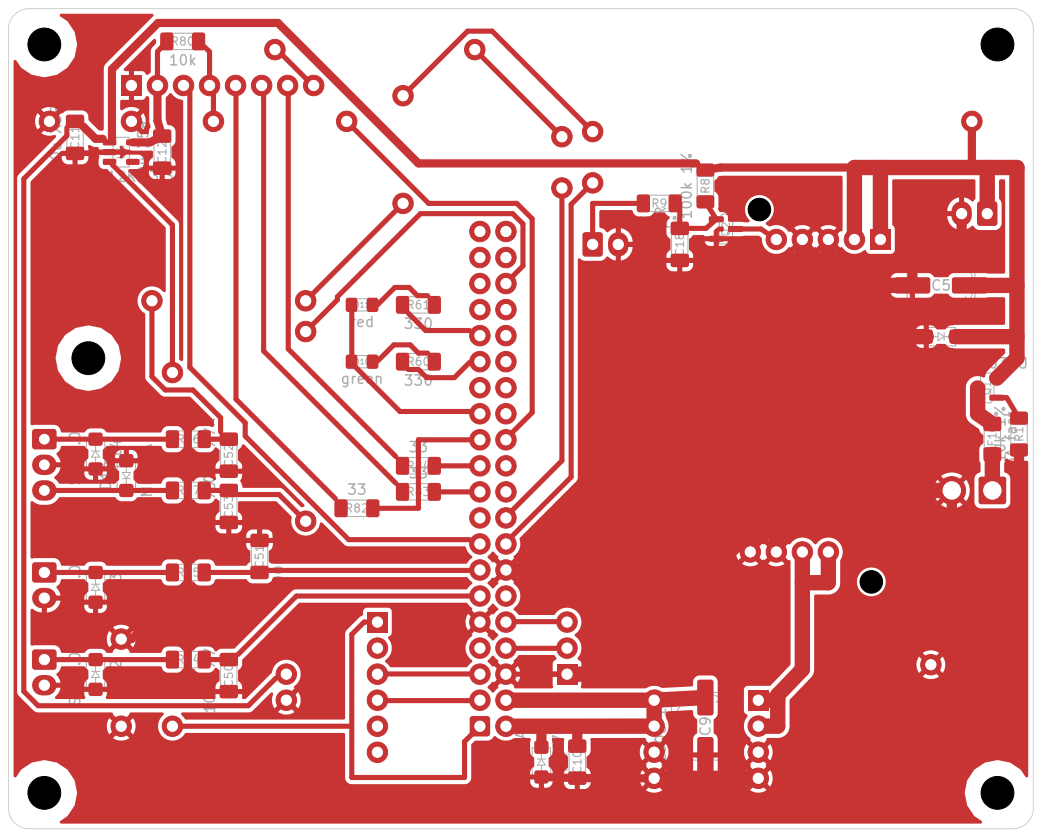
[picture p81: page 1]
