MicheleLamberti/mtp-f26-teamc/hw/sp4-breakout/fab/sp4-breakout_assembly.pdf

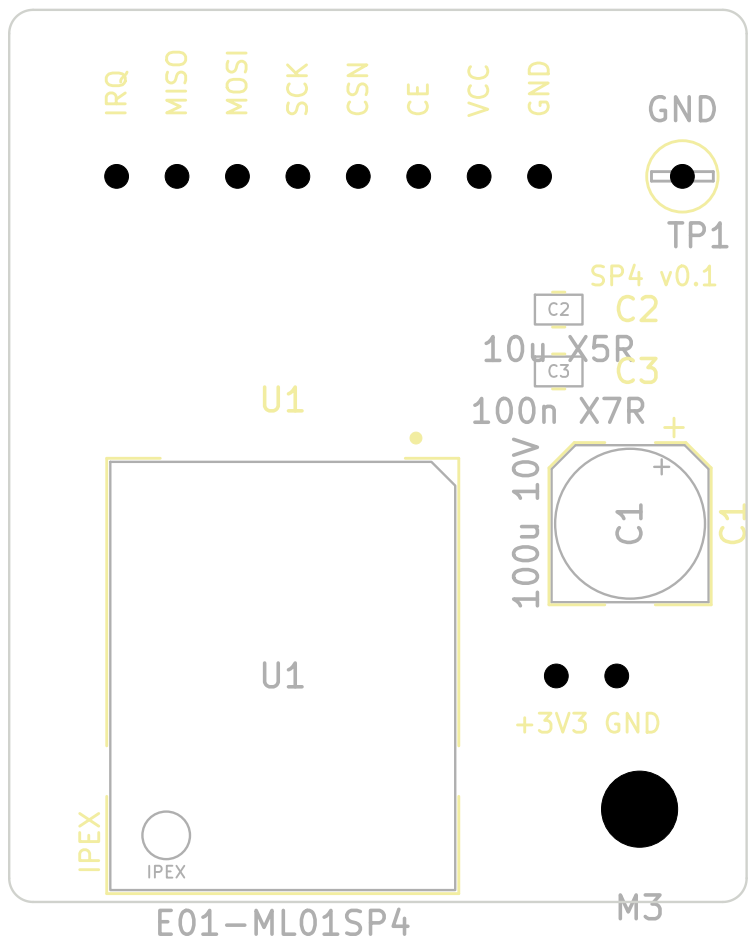
[picture p82: page 1]
