MicheleLamberti/mtp-f26-teamc/hw/teamc-carrier/fab/teamc-carrier_B_Cu.pdf

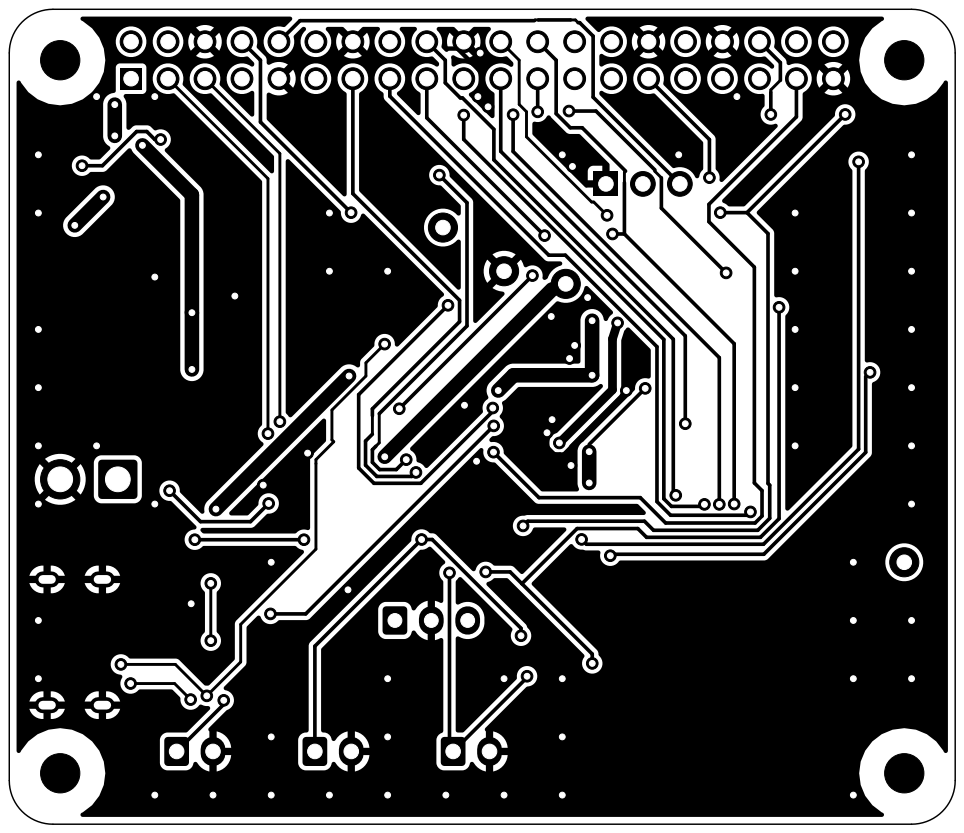
[picture p83: page 1]
