MicheleLamberti/mtp-f26-teamc/hw/teamc-carrier/fab/teamc-carrier_F_Cu.pdf

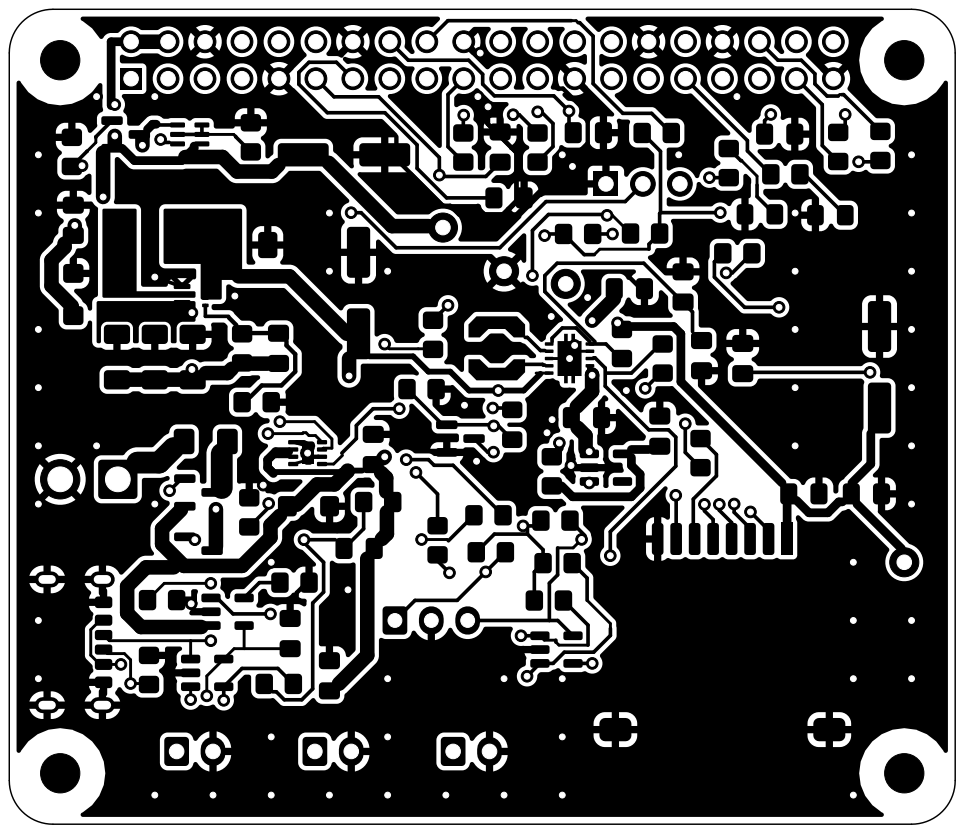
[picture p84: page 1]
