MicheleLamberti/mtp-f26-teamc/hw/teamc-carrier-simple/teamc-carrier-simple.kicad_pcb

## KiCad design hw/teamc-carrier-simple/teamc-carrier-simple.kicad_pcb (2026-10-24)

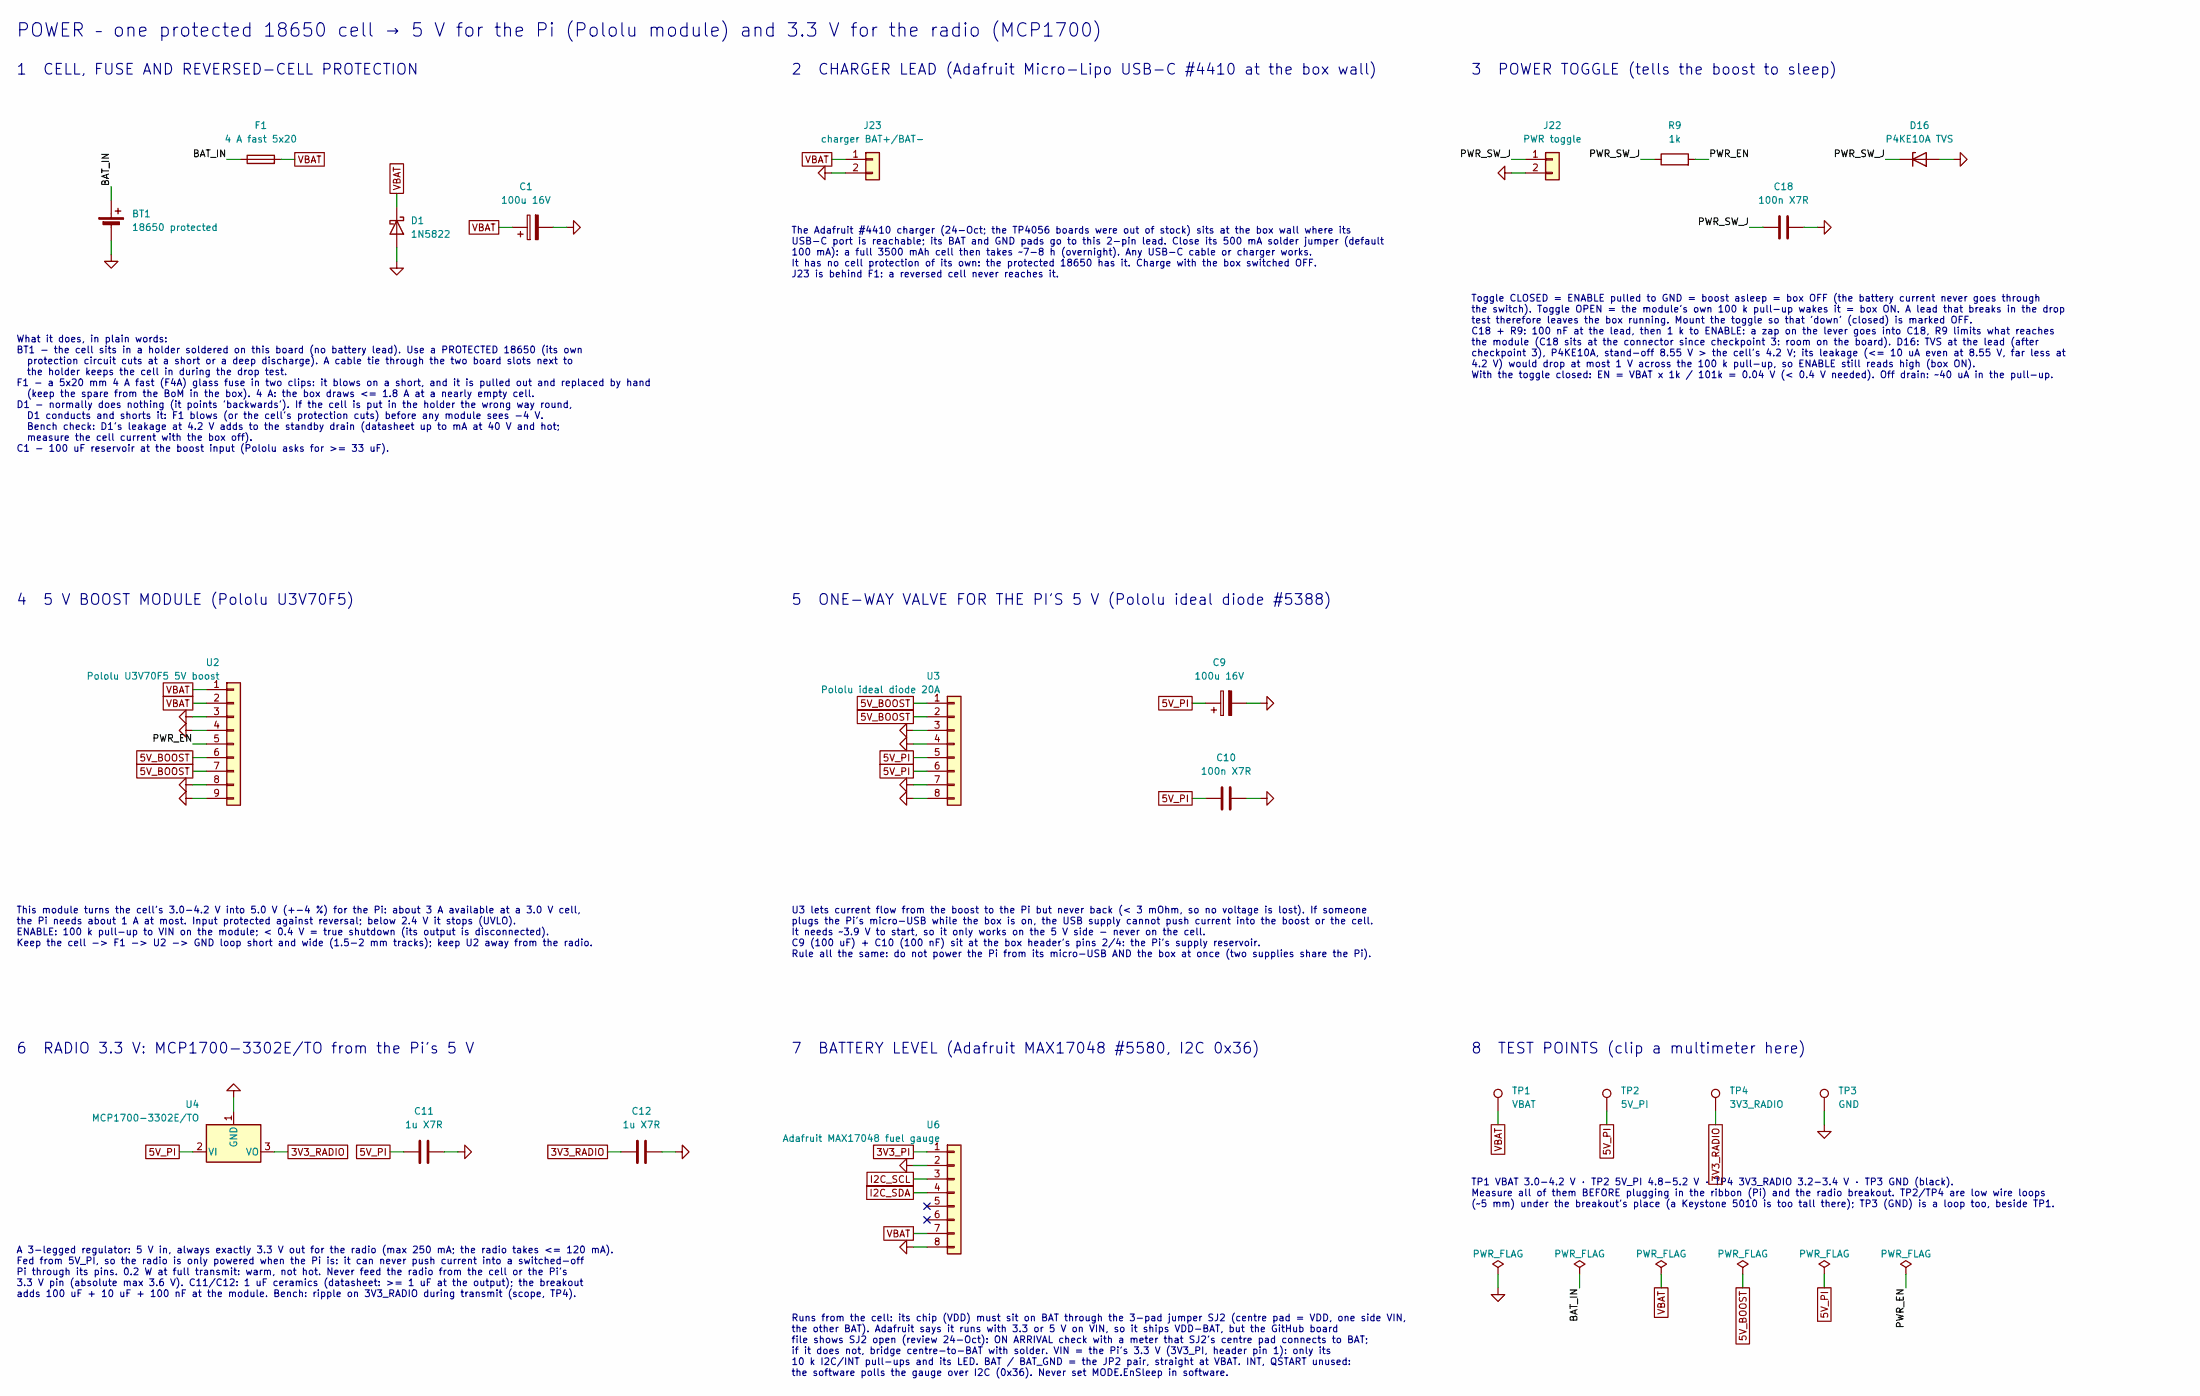
[picture p85: schematic power.kicad_sch, Power: cell, fuse, 5 V boost, ideal diode, radio 3.3 V, fue…]

Parts:
BT1: 18650 protected; BatteryHolder_MPD_BH-18650-PC; MPN BH-18650-PC (holder; the protected cell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
C1, C9: 100u 16V; CP_Radial_D6.3mm_P2.50mm_Pad1.8mm; MPN ESS107M016AE2EA
C10, C18: 100n X7R; C_Disc_D5.0mm_W2.5mm_P5.00mm_Pad1.8mm; MPN K104K10X7RF5UH5
C11, C12: 1u X7R; C_Disc_D5.0mm_W2.5mm_P5.00mm_Pad1.8mm; MPN FG28X7R1E105KRT06
D1: 1N5822; D_DO-201AD_P12.70mm_Horizontal; MPN 1N5822
D16: P4KE10A TVS; D_DO-41_SOD81_P3.81mm_Vertical_CathodeUp; MPN P4KE10A
F1: 4 A fast 5x20; Fuseholder_Clip-5x20mm_Keystone_3517_Inline_P23.11x6.76mm_D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; MPN 2 x Keystone 3517 clips + 5x20 mm 4 A f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
J22: PWR toggle; JST_XH_B2B-XH-A_1x02_P2.50mm_Vertical_Pad2.0x2.4mm; MPN B2B-XH-A(LF)(SN)
J23: charger BAT+/BAT-; JST_XH_B2B-XH-A_1x02_P2.50mm_Vertical_Pad2.0x2.4mm; MPN B2B-XH-A(LF)(SN)
R9: 1k; R_Axial_DIN0207_L6.3mm_D2.5mm_P7.62mm_Horizontal_Pad1.8mm; MPN MFR-25FBF52-1K
TP1: VBAT; TestPoint_Keystone_5010-5014_Multipurpose; MPN 5010 (red)
TP2: 5V_PI; TestPoint_Loop_D2.50mm_Drill1.0mm; MPN wire loop (bare tinned wire, ~3 mm high)
TP3: GND; TestPoint_Loop_D2.50mm_Drill1.0mm; MPN wire loop (bare tinned wire, ~3 mm high)
TP4: 3V3_RADIO; TestPoint_Loop_D2.50mm_Drill1.0mm; MPN wire loop (bare tinned wire, ~3 mm high)
U2: Pololu U3V70F5 5V boost; RevC_Pololu_U3V70F5_Headers; MPN 2891 (U3V70F5)
U3: Pololu ideal diode 20A; RevC_Pololu_IdealDiode_5388_Headers; MPN 5388 (rvp01b)
U4: MCP1700-3302E/TO; TO-92_Inline_Wide_Pad1.8mm; MPN MCP1700-3302E/TO
U6: Adafruit MAX17048 fuel gauge; RevC_Adafruit_MAX17048_5580_Headers; MPN 5580 (Rev B)

Connections:
3V3_PI: U6.1; also elsewhere on the board
3V3_RADIO: C12.1, TP4.1, U4.3 (VO); also elsewhere on the board
5V_BOOST: U2.6, U2.7, U3.1, U3.2
5V_PI: C9.1, C10.1, C11.1, TP2.1, U3.5, U3.6, U4.2 (VI); also elsewhere on the board
/power/BAT_IN: BT1.1 (+), F1.1
/power/PWR_EN: R9.2, U2.5
/power/PWR_SW_J: C18.1, D16.1 (K), J22.1, R9.1
GND: BT1.2 (-), C1.2, C9.2, C10.2, C11.2, C12.2, C18.2, D1.2 (A), D16.2 (A), J22.2, J23.2, TP3.1, U2.3, U2.4, U2.8, U2.9, U3.3, U3.4, U3.7, U3.8, U4.1 (GND), U6.2, U6.8; also elsewhere on the board
I2C_SCL: U6.3; also elsewhere on the board
I2C_SDA: U6.4; also elsewhere on the board
VBAT: C1.1, D1.1 (K), F1.2, J23.1, TP1.1, U2.1, U2.2, U6.7

Notes on the sheet:
POWER – one protected 18650 cell → 5 V for the Pi (Pololu module) and 3.3 V for the radio (MCP1700)
1 CELL, FUSE AND REVERSED-CELL PROTECTION
What it does, in plain words: BT1 - the cell sits in a holder soldered on this board (no battery lead). Use a PROTECTED 18650 (its own protection circuit cuts at a short or a deep discharge). A cable tie through the two board slots next to the holder keeps the cell in during the drop test. F1 - a 5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
2 CHARGER LEAD (Adafruit Micro-Lipo USB-C #4410 at the box wall)
The Adafruit #4410 charger (24-Oct; the TP4056 boards were out of stock) sits at the box wall where its USB-C port is reachable; its BAT and GND pads go to this 2-pin lead. Close its 500 mA solder jumper (default 100 mA): a full 3500 mAh cell then takes ~7-8 h (overnight). Any USB-C cable or charge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
3 POWER TOGGLE (tells the boost to sleep)
Toggle CLOSED = ENABLE pulled to GND = boost asleep = box OFF (the battery current never goes through the switch). Toggle OPEN = the module's own 100 k pull-up wakes it = box ON. A lead that breaks in the drop test therefore leaves the box running. Mount the toggle so that 'down' (closed) is marked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
4 5 V BOOST MODULE (Pololu U3V70F5)
This module turns the cell's 3.0-4.2 V into 5.0 V (+-4 %) for the Pi: about 3 A available at a 3.0 V cell, the Pi needs about 1 A at most. Input protected against reversal; below 2.4 V it stops (UVLO). ENABLE: 100 k pull-up to VIN on the module; < 0.4 V = true shutdown (its output is disconnected).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
5 ONE-WAY VALVE FOR THE PI'S 5 V (Pololu ideal diode #5388)
U3 lets current flow from the boost to the Pi but never back (< 3 mOhm, so no voltage is lost). If someone plugs the Pi's micro-USB while the box is on, the USB supply cannot push current into the boost or the cell. It needs ~3.9 V to start, so it only works on the 5 V side - never on the cell. C9 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
6 RADIO 3.3 V: MCP1700-3302E/TO from the Pi's 5 V
A 3-legged regulator: 5 V in, always exactly 3.3 V out for the radio (max 250 mA; the radio takes <= 120 mA). Fed from 5V_PI, so the radio is only powered when the Pi is: it can never push current into a switched-off Pi through its pins. 0.2 W at full transmit: warm, not hot. Never feed the radio f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
7 BATTERY LEVEL (Adafruit MAX17048 #5580, I2C 0x36)
Runs from the cell: its chip (VDD) must sit on BAT through the 3-pad jumper SJ2 (centre pad = VDD, one side VIN, the other BAT). Adafruit says it runs with 3.3 or 5 V on VIN, so it ships VDD-BAT, but the GitHub board file shows SJ2 open (review 24-Oct): ON ARRIVAL check with a meter that SJ2's cent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
8 TEST POINTS (clip a multimeter here)
TP1 VBAT 3.0-4.2 V · TP2 5V_PI 4.8-5.2 V · TP4 3V3_RADIO 3.2-3.4 V · TP3 GND (black). Measure all of them BEFORE plugging in the ribbon (Pi) and the radio breakout. TP2/TP4 are low wire loops (~5 mm) under the breakout's place (a Keystone 5010 is too tall there); TP3 (GND) is a loop too, beside TP1.

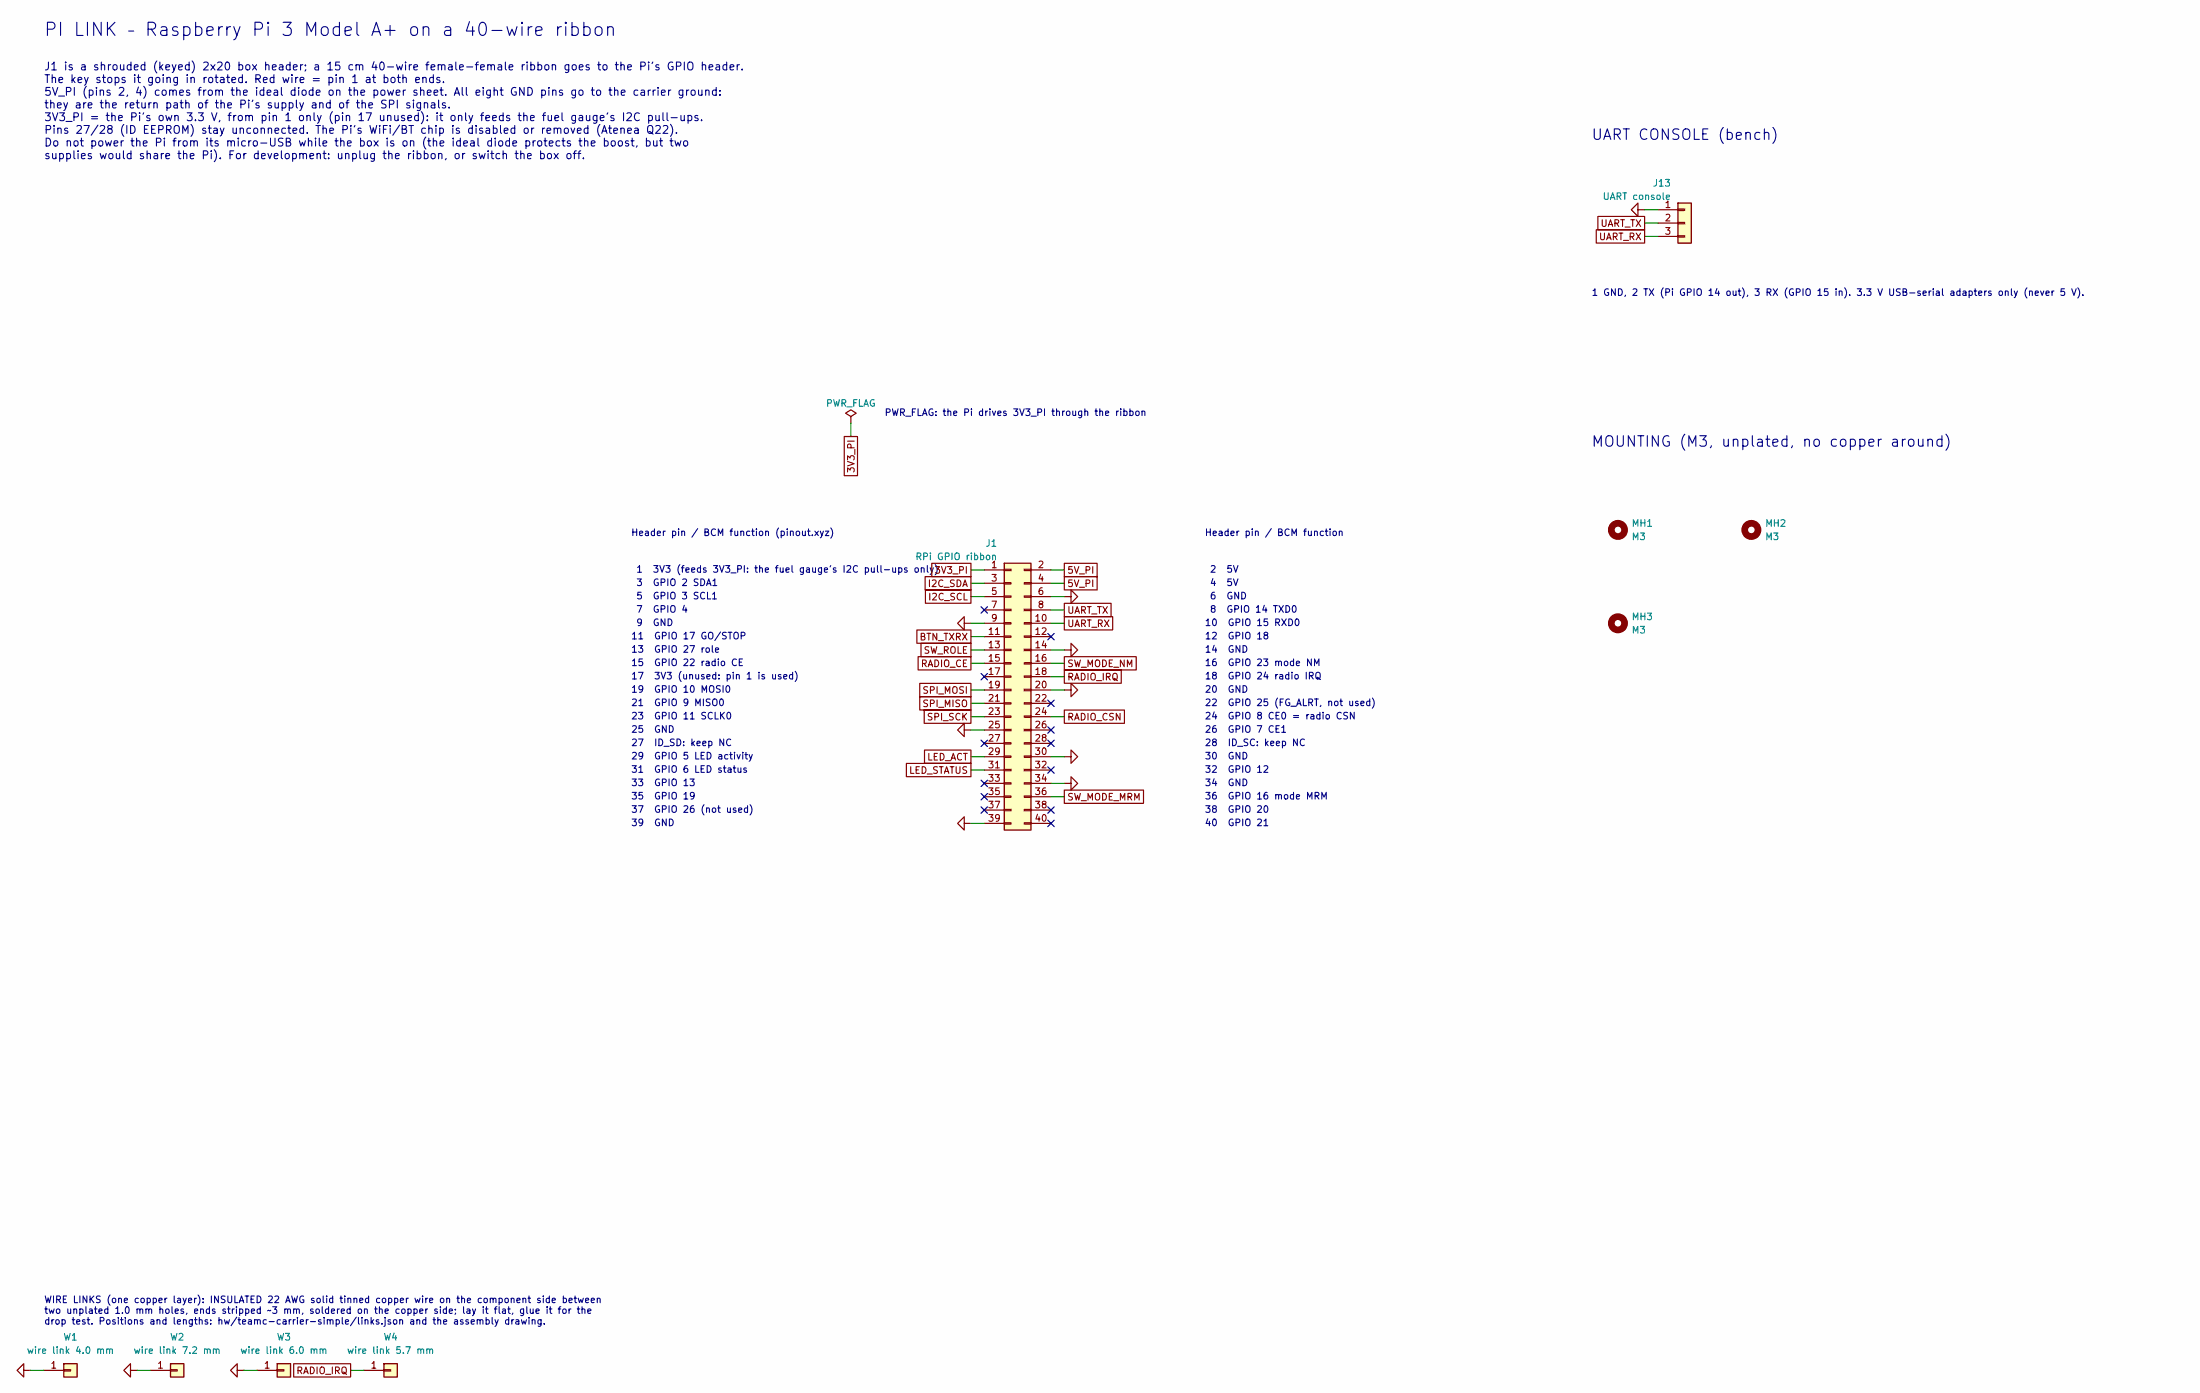
[picture p86: schematic pi_link.kicad_sch, Pi link: 2x20 box header + ribbon, UART, holes (rev C, DRAF…]

Parts:
J1: RPi GPIO ribbon; IDC-Header_2x20_P2.54mm_Vertical_Pad2.0mm; MPN 61204021621 (Würth 2x20 shrouded box he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
J13: UART console; PinHeader_1x03_P2.54mm_Vertical_Pad2.0mm; MPN 1x03 male pin header (cut from the 1x40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
MH1, MH2, MH3: M3; MountingHole_3.2mm_M3; MPN M3 x 10 mm nylon standoff + M3 x 6 nylo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
W1: wire link 4.0 mm; RevC_WireLink_L4.0mm; MPN 22 AWG solid tinned copper hook-up wire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
W2: wire link 7.2 mm; RevC_WireLink_L7.2mm; MPN 22 AWG solid tinned copper hook-up wire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
W3: wire link 6.0 mm; RevC_WireLink_L6.0mm; MPN 22 AWG solid tinned copper hook-up wire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
W4: wire link 5.7 mm; RevC_WireLink_L5.7mm; MPN 22 AWG solid tinned copper hook-up wire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

Connections:
3V3_PI: J1.1; also elsewhere on the board
5V_PI: J1.2, J1.4; also elsewhere on the board
BTN_TXRX: J1.11; also elsewhere on the board
GND: J1.6, J1.9, J1.14, J1.20, J1.25, J1.30, J1.34, J1.39, J13.1, W1.1, W2.1, W3.1; also elsewhere on the board
I2C_SCL: J1.5; also elsewhere on the board
I2C_SDA: J1.3; also elsewhere on the board
LED_ACT: J1.29; also elsewhere on the board
LED_STATUS: J1.31; also elsewhere on the board
RADIO_CE: J1.15; also elsewhere on the board
RADIO_CSN: J1.24; also elsewhere on the board
RADIO_IRQ: J1.18, W4.1; also elsewhere on the board
SPI_MISO: J1.21; also elsewhere on the board
SPI_MOSI: J1.19; also elsewhere on the board
SPI_SCK: J1.23; also elsewhere on the board
SW_MODE_MRM: J1.36; also elsewhere on the board
SW_MODE_NM: J1.16; also elsewhere on the board
SW_ROLE: J1.13; also elsewhere on the board
UART_RX: J1.10, J13.3
UART_TX: J1.8, J13.2

Notes on the sheet:
PI LINK – Raspberry Pi 3 Model A+ on a 40-wire ribbon
J1 is a shrouded (keyed) 2x20 box header; a 15 cm 40-wire female-female ribbon goes to the Pi's GPIO header. The key stops it going in rotated. Red wire = pin 1 at both ends. 5V_PI (pins 2, 4) comes from the ideal diode on the power sheet. All eight GND pins go to the carrier ground: they are the r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
1 3V3 (feeds 3V3_PI: the fuel gauge's I2C pull-ups only)
2 5V
3 GPIO 2 SDA1
4 5V
5 GPIO 3 SCL1
6 GND
7 GPIO 4
8 GPIO 14 TXD0
9 GND
10 GPIO 15 RXD0
11 GPIO 17 GO/STOP
12 GPIO 18
13 GPIO 27 role
14 GND
15 GPIO 22 radio CE
16 GPIO 23 mode NM
17 3V3 (unused: pin 1 is used)
18 GPIO 24 radio IRQ
19 GPIO 10 MOSI0
20 GND
21 GPIO 9 MISO0
22 GPIO 25 (FG_ALRT, not used)
23 GPIO 11 SCLK0
24 GPIO 8 CE0 = radio CSN
25 GND
26 GPIO 7 CE1
27 ID_SD: keep NC
28 ID_SC: keep NC
29 GPIO 5 LED activity
30 GND
31 GPIO 6 LED status
32 GPIO 12
33 GPIO 13
34 GND
35 GPIO 19
36 GPIO 16 mode MRM
37 GPIO 26 (not used)
38 GPIO 20
39 GND
40 GPIO 21
Header pin / BCM function (pinout.xyz)
Header pin / BCM function
PWR_FLAG: the Pi drives 3V3_PI through the ribbon
UART CONSOLE (bench)
1 GND, 2 TX (Pi GPIO 14 out), 3 RX (GPIO 15 in). 3.3 V USB-serial adapters only (never 5 V).
MOUNTING (M3, unplated, no copper around)
WIRE LINKS (one copper layer): INSULATED 22 AWG solid tinned copper wire on the component side between two unplated 1.0 mm holes, ends stripped ~3 mm, soldered on the copper side; lay it flat, glue it for the drop test. Positions and lengths: hw/teamc-carrier-simple/links.json and the assembly draw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

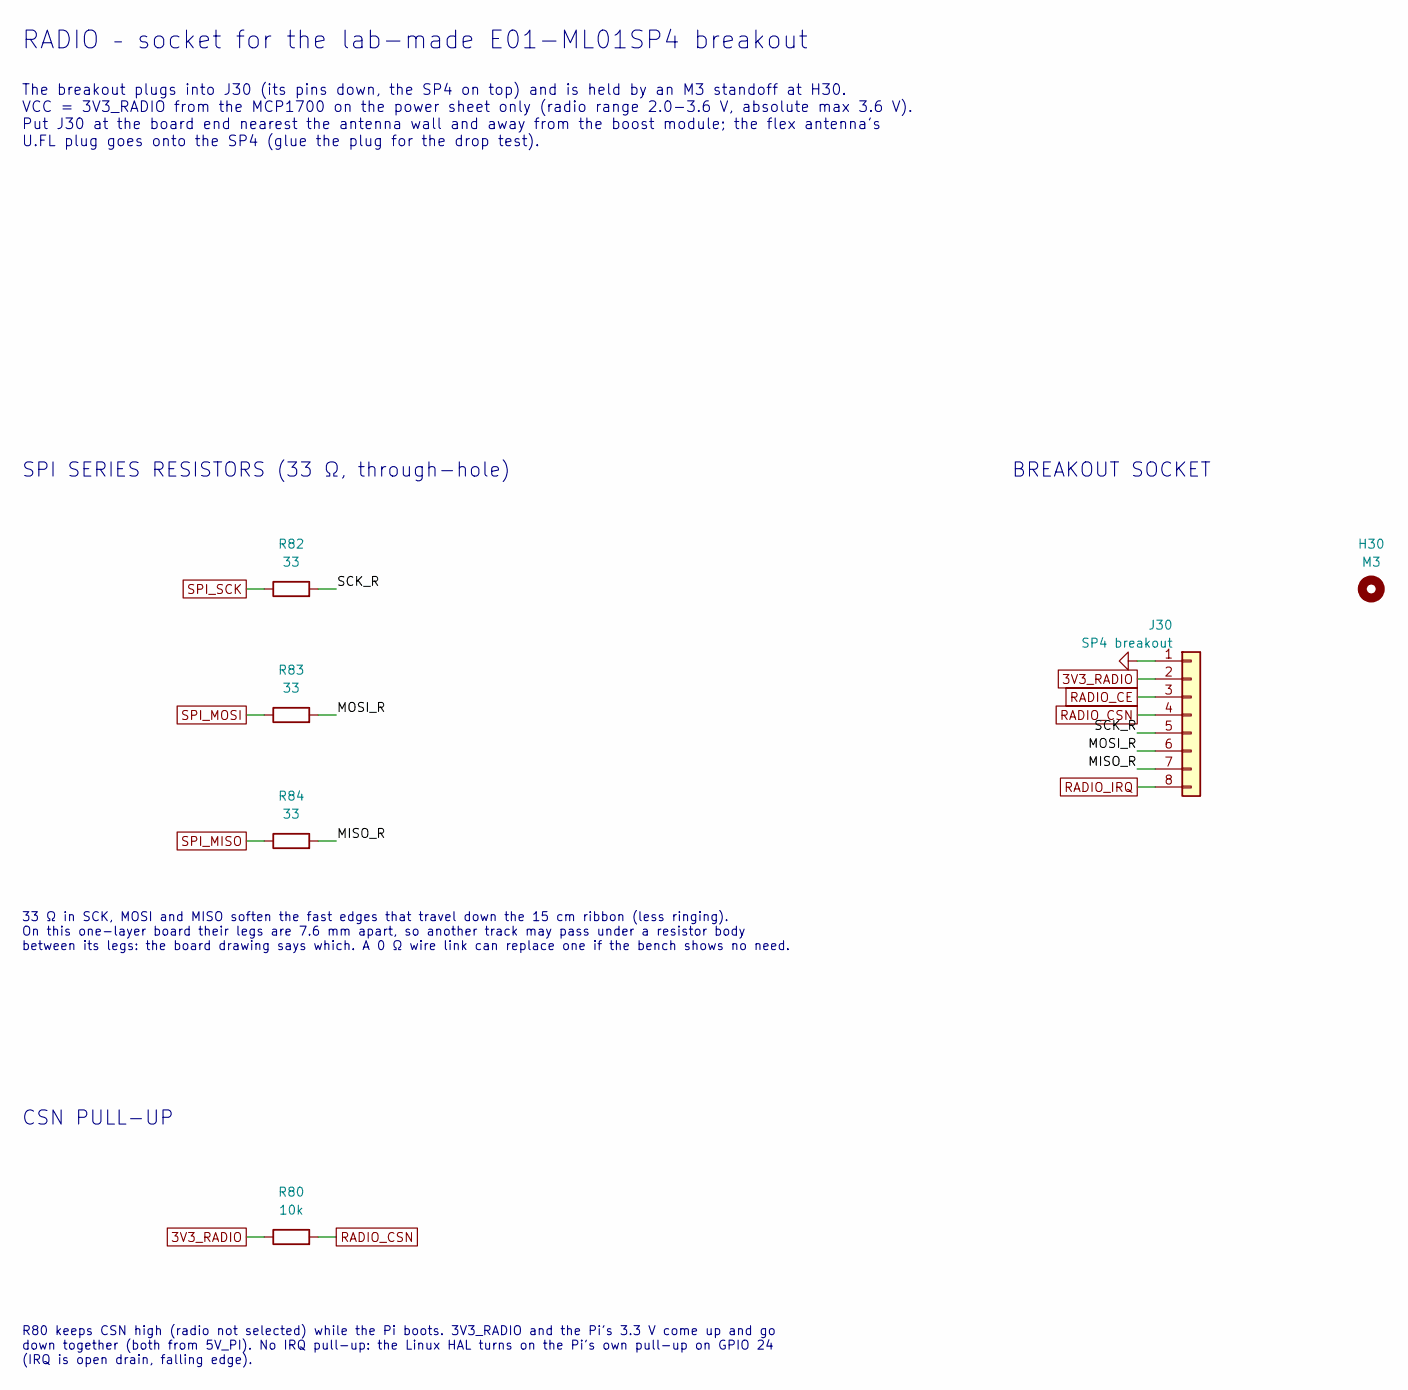
[picture p87: schematic radio.kicad_sch, Radio: SP4 breakout socket (rev C, DRAFT)]

Parts:
H30: M3; MountingHole_3.2mm_M3; MPN M3 x 11 mm nylon standoff F/F + 2 x M3 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
J30: SP4 breakout; PinSocket_1x08_P2.54mm_Vertical_Pad2.0mm; MPN PPTC081LFBN-RC (Sullins 1x08 female soc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
R80: 10k; R_Axial_DIN0207_L6.3mm_D2.5mm_P7.62mm_Horizontal_Pad1.8mm; MPN MFR-25FBF52-10K
R82, R83, R84: 33; R_Axial_DIN0207_L6.3mm_D2.5mm_P7.62mm_Horizontal_Pad1.8mm; MPN MFR-25FBF52-33R

Connections:
3V3_RADIO: J30.2, R80.1; also elsewhere on the board
/radio/MISO_R: J30.7, R84.2
/radio/MOSI_R: J30.6, R83.2
/radio/SCK_R: J30.5, R82.2
GND: J30.1; also elsewhere on the board
RADIO_CE: J30.3; also elsewhere on the board
RADIO_CSN: J30.4, R80.2; also elsewhere on the board
RADIO_IRQ: J30.8; also elsewhere on the board
SPI_MISO: R84.1; also elsewhere on the board
SPI_MOSI: R83.1; also elsewhere on the board
SPI_SCK: R82.1; also elsewhere on the board

Notes on the sheet:
RADIO – socket for the lab-made E01-ML01SP4 breakout
The breakout plugs into J30 (its pins down, the SP4 on top) and is held by an M3 standoff at H30. VCC = 3V3_RADIO from the MCP1700 on the power sheet only (radio range 2.0-3.6 V, absolute max 3.6 V). Put J30 at the board end nearest the antenna wall and away from the boost module; the flex antenna'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
BREAKOUT SOCKET
SPI SERIES RESISTORS (33 Ω, through-hole)
33 Ω in SCK, MOSI and MISO soften the fast edges that travel down the 15 cm ribbon (less ringing). On this one-layer board their legs are 7.6 mm apart, so another track may pass under a resistor body between its legs: the board drawing says which. A 0 Ω wire link can replace one if the bench shows 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
CSN PULL-UP
R80 keeps CSN high (radio not selected) while the Pi boots. 3V3_RADIO and the Pi's 3.3 V come up and go down together (both from 5V_PI). No IRQ pull-up: the Linux HAL turns on the Pi's own pull-up on GPIO 24 (IRQ is open drain, falling edge).

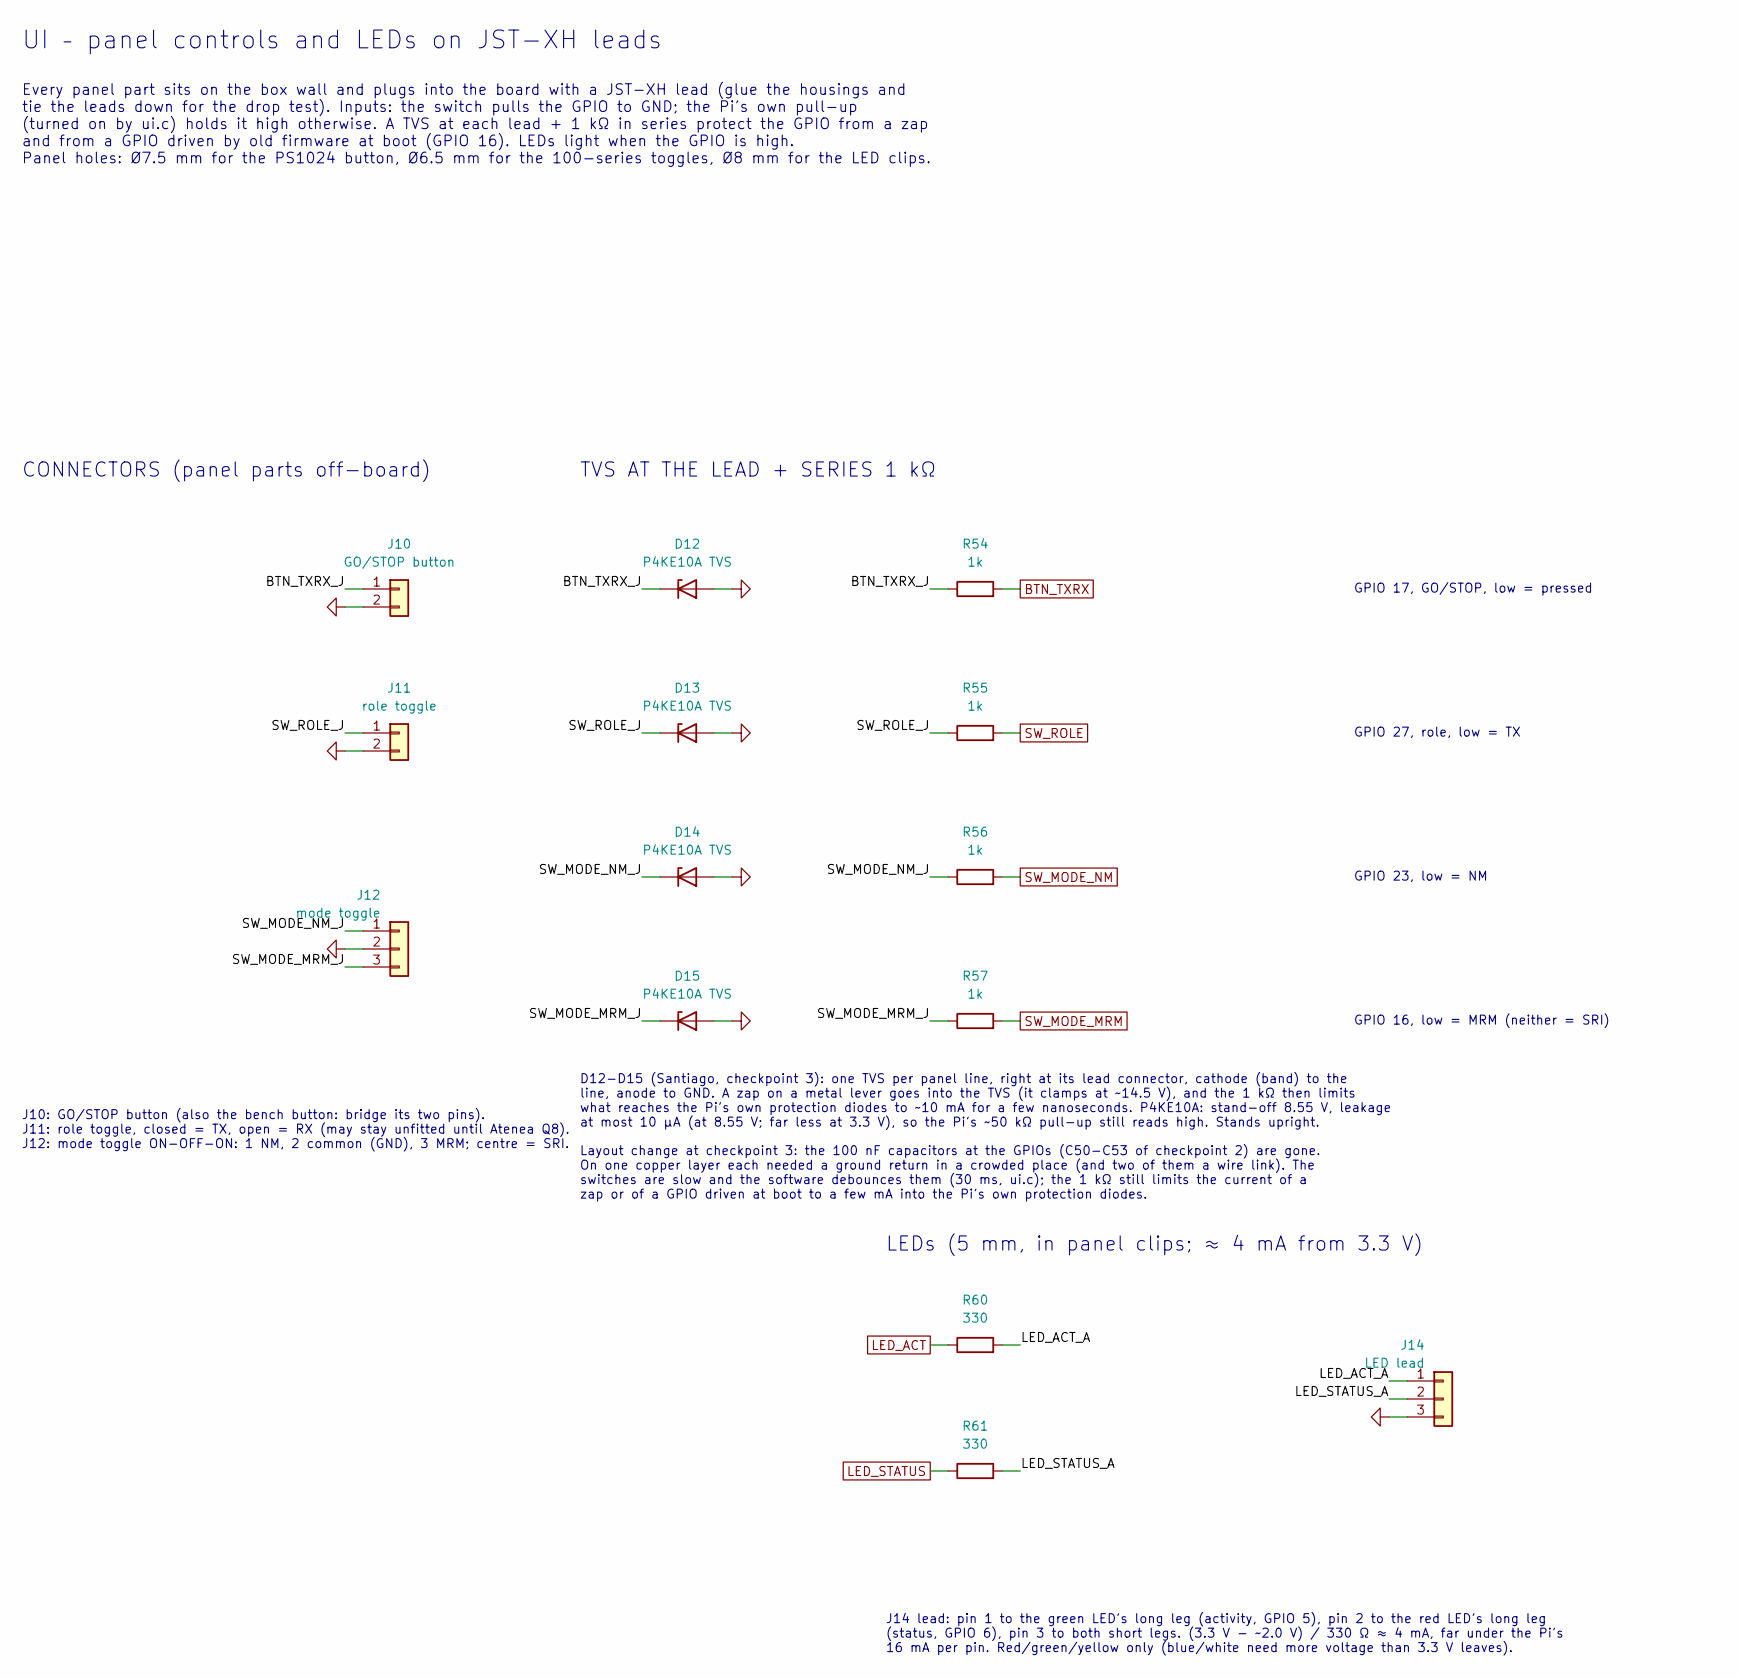
[picture p88: schematic ui.kicad_sch, UI: panel button, toggles, LEDs (rev C, DRAFT)]

Parts:
D12, D13, D14, D15: P4KE10A TVS; D_DO-41_SOD81_P3.81mm_Vertical_CathodeUp; MPN P4KE10A
J10: GO/STOP button; JST_XH_B2B-XH-A_1x02_P2.50mm_Vertical_Pad2.0x2.4mm; MPN B2B-XH-A(LF)(SN)
J11: role toggle; JST_XH_B2B-XH-A_1x02_P2.50mm_Vertical_Pad2.0x2.4mm; MPN B2B-XH-A(LF)(SN)
J12: mode toggle; JST_XH_B3B-XH-A_1x03_P2.50mm_Vertical_Pad2.0x2.4mm; MPN B3B-XH-A(LF)(SN)
J14: LED lead; JST_XH_B3B-XH-A_1x03_P2.50mm_Vertical_Pad2.0x2.4mm; MPN B3B-XH-A(LF)(SN)
R54, R55, R56, R57: 1k; R_Axial_DIN0207_L6.3mm_D2.5mm_P7.62mm_Horizontal_Pad1.8mm; MPN MFR-25FBF52-1K
R60, R61: 330; R_Axial_DIN0207_L6.3mm_D2.5mm_P7.62mm_Horizontal_Pad1.8mm; MPN MFR-25FBF52-330R

Connections:
/ui/BTN_TXRX_J: D12.1 (K), J10.1, R54.1
/ui/LED_ACT_A: J14.1, R60.2
/ui/LED_STATUS_A: J14.2, R61.2
/ui/SW_MODE_MRM_J: D15.1 (K), J12.3, R57.1
/ui/SW_MODE_NM_J: D14.1 (K), J12.1, R56.1
/ui/SW_ROLE_J: D13.1 (K), J11.1, R55.1
BTN_TXRX: R54.2; also elsewhere on the board
GND: D12.2 (A), D13.2 (A), D14.2 (A), D15.2 (A), J10.2, J11.2, J12.2, J14.3; also elsewhere on the board
LED_ACT: R60.1; also elsewhere on the board
LED_STATUS: R61.1; also elsewhere on the board
SW_MODE_MRM: R57.2; also elsewhere on the board
SW_MODE_NM: R56.2; also elsewhere on the board
SW_ROLE: R55.2; also elsewhere on the board

Notes on the sheet:
UI – panel controls and LEDs on JST-XH leads
Every panel part sits on the box wall and plugs into the board with a JST-XH lead (glue the housings and tie the leads down for the drop test). Inputs: the switch pulls the GPIO to GND; the Pi's own pull-up (turned on by ui.c) holds it high otherwise. A TVS at each lead + 1 kΩ in series protect the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
CONNECTORS (panel parts off-board)
J10: GO/STOP button (also the bench button: bridge its two pins). J11: role toggle, closed = TX, open = RX (may stay unfitted until Atenea Q8). J12: mode toggle ON-OFF-ON: 1 NM, 2 common (GND), 3 MRM; centre = SRI.
TVS AT THE LEAD + SERIES 1 kΩ
GPIO 17, GO/STOP, low = pressed
GPIO 27, role, low = TX
GPIO 23, low = NM
GPIO 16, low = MRM (neither = SRI)
D12-D15 (Santiago, checkpoint 3): one TVS per panel line, right at its lead connector, cathode (band) to the line, anode to GND. A zap on a metal lever goes into the TVS (it clamps at ~14.5 V), and the 1 kΩ then limits what reaches the Pi's own protection diodes to ~10 mA for a few nanoseconds. P4K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
Layout change at checkpoint 3: the 100 nF capacitors at the GPIOs (C50-C53 of checkpoint 2) are gone. On one copper layer each needed a ground return in a crowded place (and two of them a wire link). The switches are slow and the software debounces them (30 ms, ui.c); the 1 kΩ still limits the curr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
LEDs (5 mm, in panel clips; ≈ 4 mA from 3.3 V)
J14 lead: pin 1 to the green LED's long leg (activity, GPIO 5), pin 2 to the red LED's long leg (status, GPIO 6), pin 3 to both short legs. (3.3 V - ~2.0 V) / 330 Ω ≈ 4 mA, far under the Pi's 16 mA per pin. Red/green/yellow only (blue/white need more voltage than 3.3 V leaves).

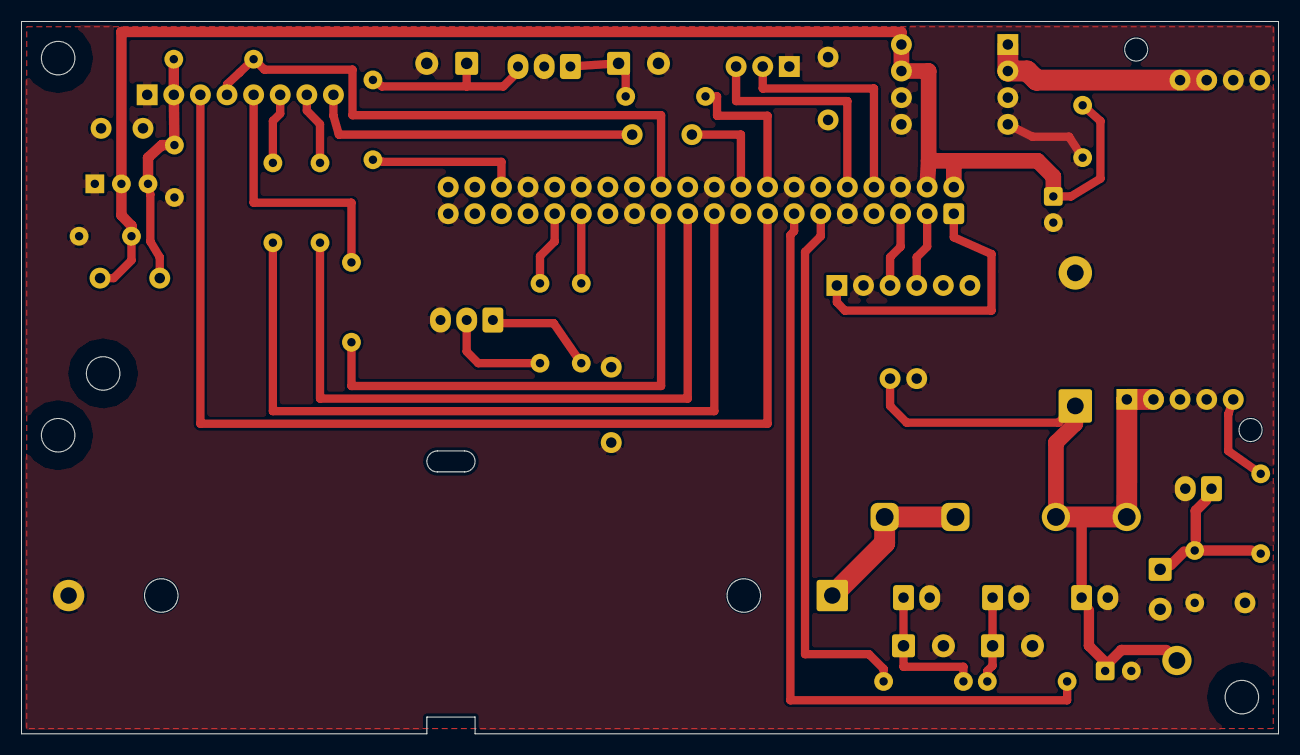
[picture p89: board teamc-carrier-simple.kicad_pcb from above]

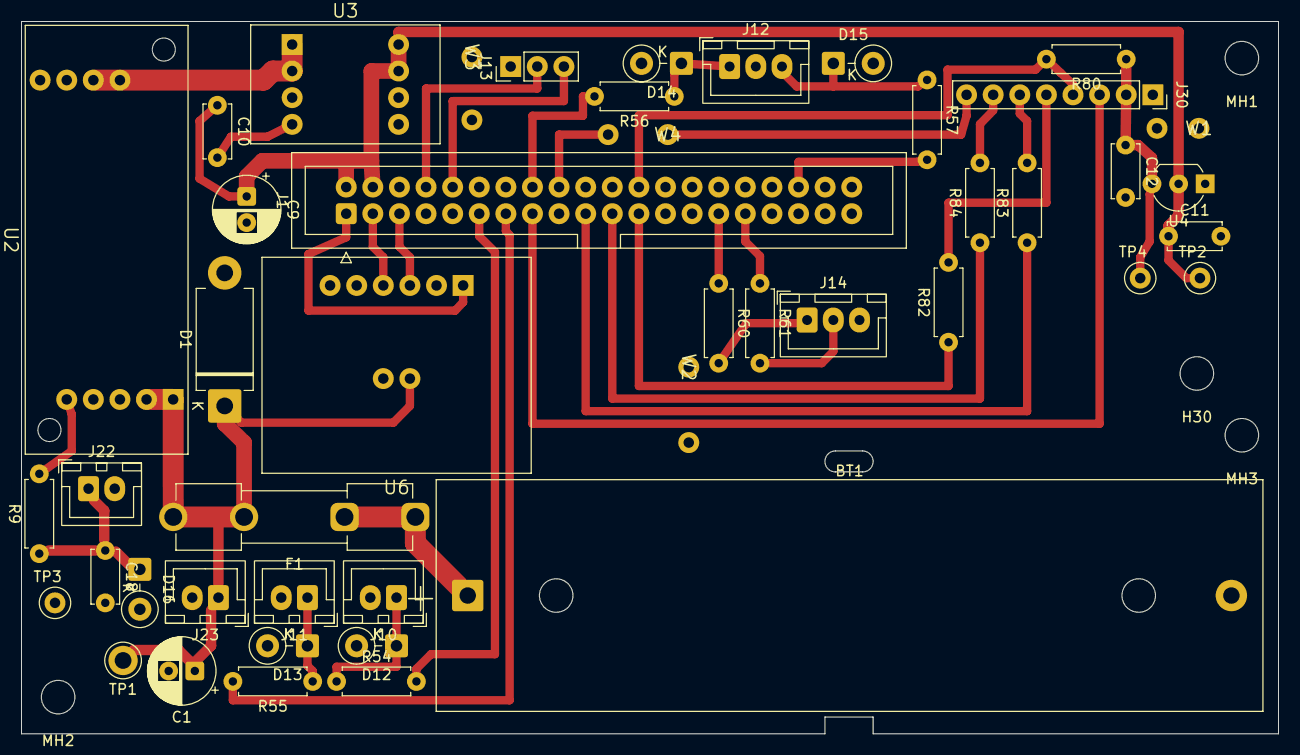
[picture p90: board teamc-carrier-simple.kicad_pcb from below]

Board: 2 copper layers, 120.0 x 68.0 mm, 50 parts (50 on the bottom side), 34 nets.
