MicheleLamberti/mtp-f26-teamc/hw/sp4-breakout/sp4-breakout.kicad_pcb

## KiCad design hw/sp4-breakout/sp4-breakout.kicad_pcb (2026-10-23)

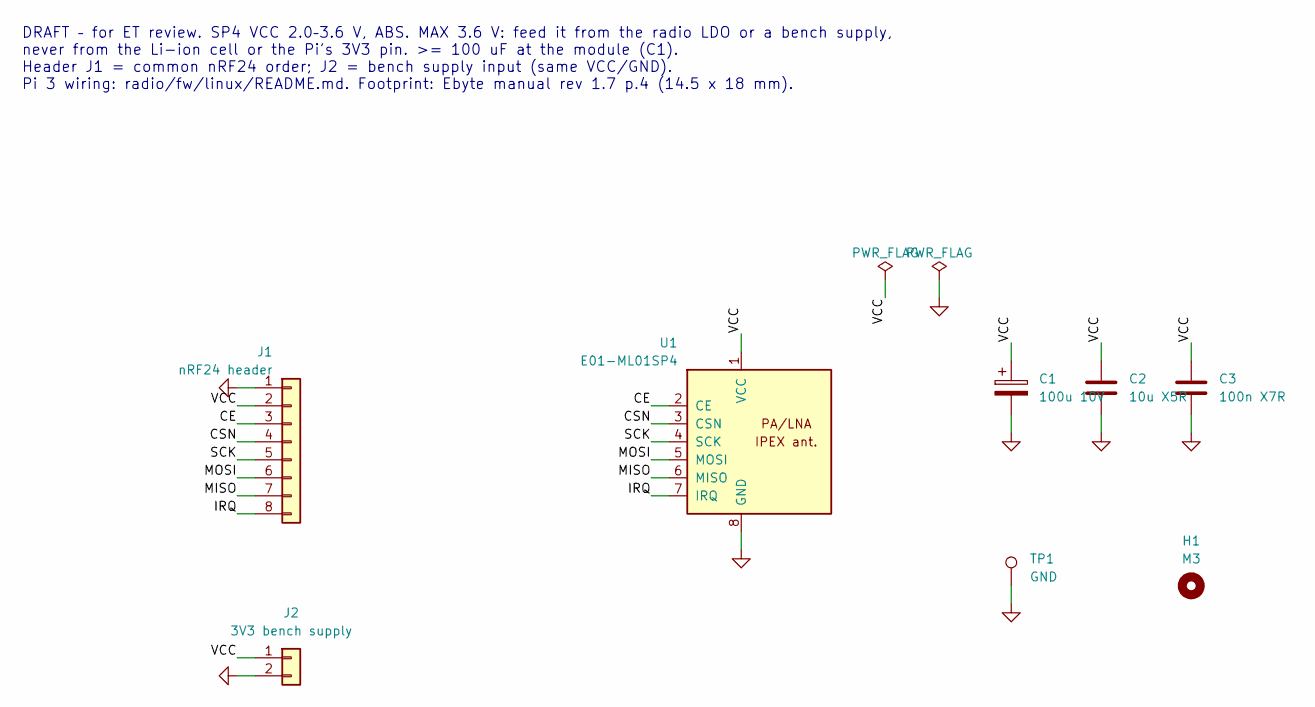
[picture p91: schematic sp4-breakout.kicad_sch, E01-ML01SP4 breakout (DRAFT – for ET review)]

Parts:
C1: 100u 10V; CP_Elec_6.3x5.4; MPN EEE-FK1A101P (or any 100 uF >= 6.3 V, 6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
C2: 10u X5R; C_0805_2012Metric_Pad1.18x1.45mm_HandSolder; MPN CL21A106KAYNNNE
C3: 100n X7R; C_0805_2012Metric_Pad1.18x1.45mm_HandSolder; MPN CL21B104KBCNNNC
H1: M3; MountingHole_3.2mm_M3
J1: nRF24 header; PinHeader_1x08_P2.54mm_Vertical_Pad2.0mm; MPN 1x08 2.54 mm pin header
J2: 3V3 bench supply; PinHeader_1x02_P2.54mm_Vertical_Pad2.0mm; MPN 1x02 2.54 mm pin header
TP1: GND; TestPoint_Loop_D2.50mm_Drill1.0mm; MPN wire loop or Keystone 5001
U1: E01-ML01SP4; MPN E01-ML01SP4

Connections:
/CE: J1.3, U1.2 (CE)
/CSN: J1.4, U1.3 (CSN)
/IRQ: J1.8, U1.7 (IRQ)
/MISO: J1.7, U1.6 (MISO)
/MOSI: J1.6, U1.5 (MOSI)
/SCK: J1.5, U1.4 (SCK)
/VCC: C1.1, C2.1, C3.1, J1.2, J2.1, U1.1 (VCC)
GND: C1.2, C2.2, C3.2, J1.1, J2.2, TP1.1, U1.8 (GND), U1.9 (GND), U1.10 (GND)

Notes on the sheet:
DRAFT – for ET review. SP4 VCC 2.0–3.6 V, ABS. MAX 3.6 V: feed it from the radio LDO or a bench supply, never from the Li-ion cell or the Pi's 3V3 pin. >= 100 uF at the module (C1). Header J1 = common nRF24 order; J2 = bench supply input (same VCC/GND). Pi 3 wiring: radio/fw/linux/README.md. Footpr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

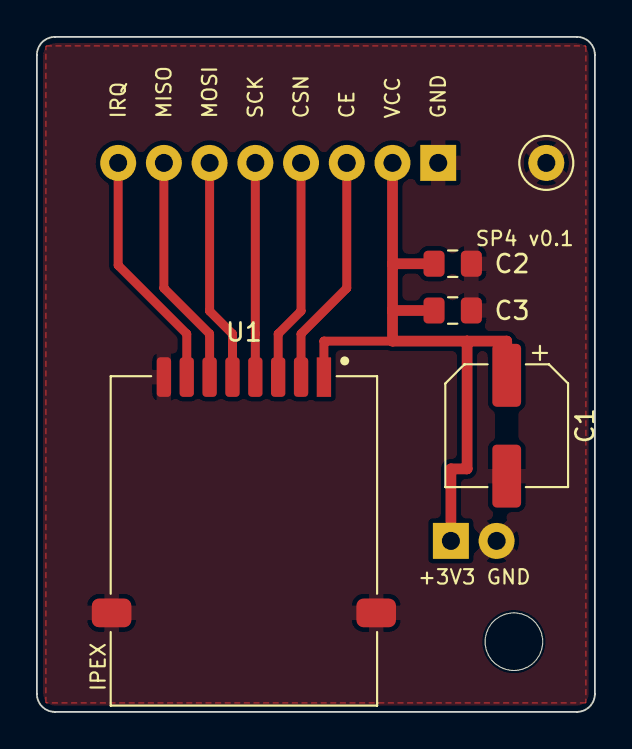
[picture p92: board sp4-breakout.kicad_pcb from above]

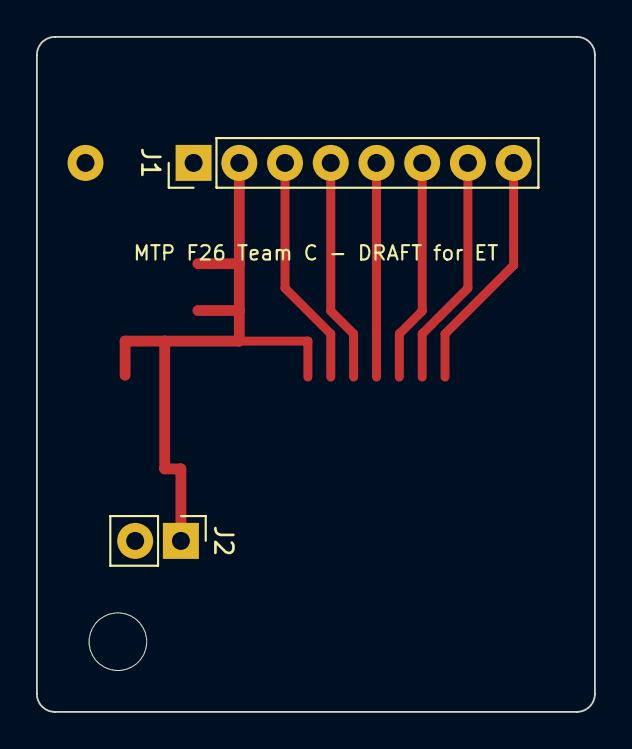
[picture p93: board sp4-breakout.kicad_pcb from below]

Board: 2 copper layers, 31.0 x 37.5 mm, 8 parts (2 on the bottom side), 8 nets.
