MicheleLamberti/mtp-f26-teamc/hw/teamc-carrier/teamc-carrier.kicad_pcb

## KiCad design hw/teamc-carrier/teamc-carrier.kicad_pcb (2026-10-21)

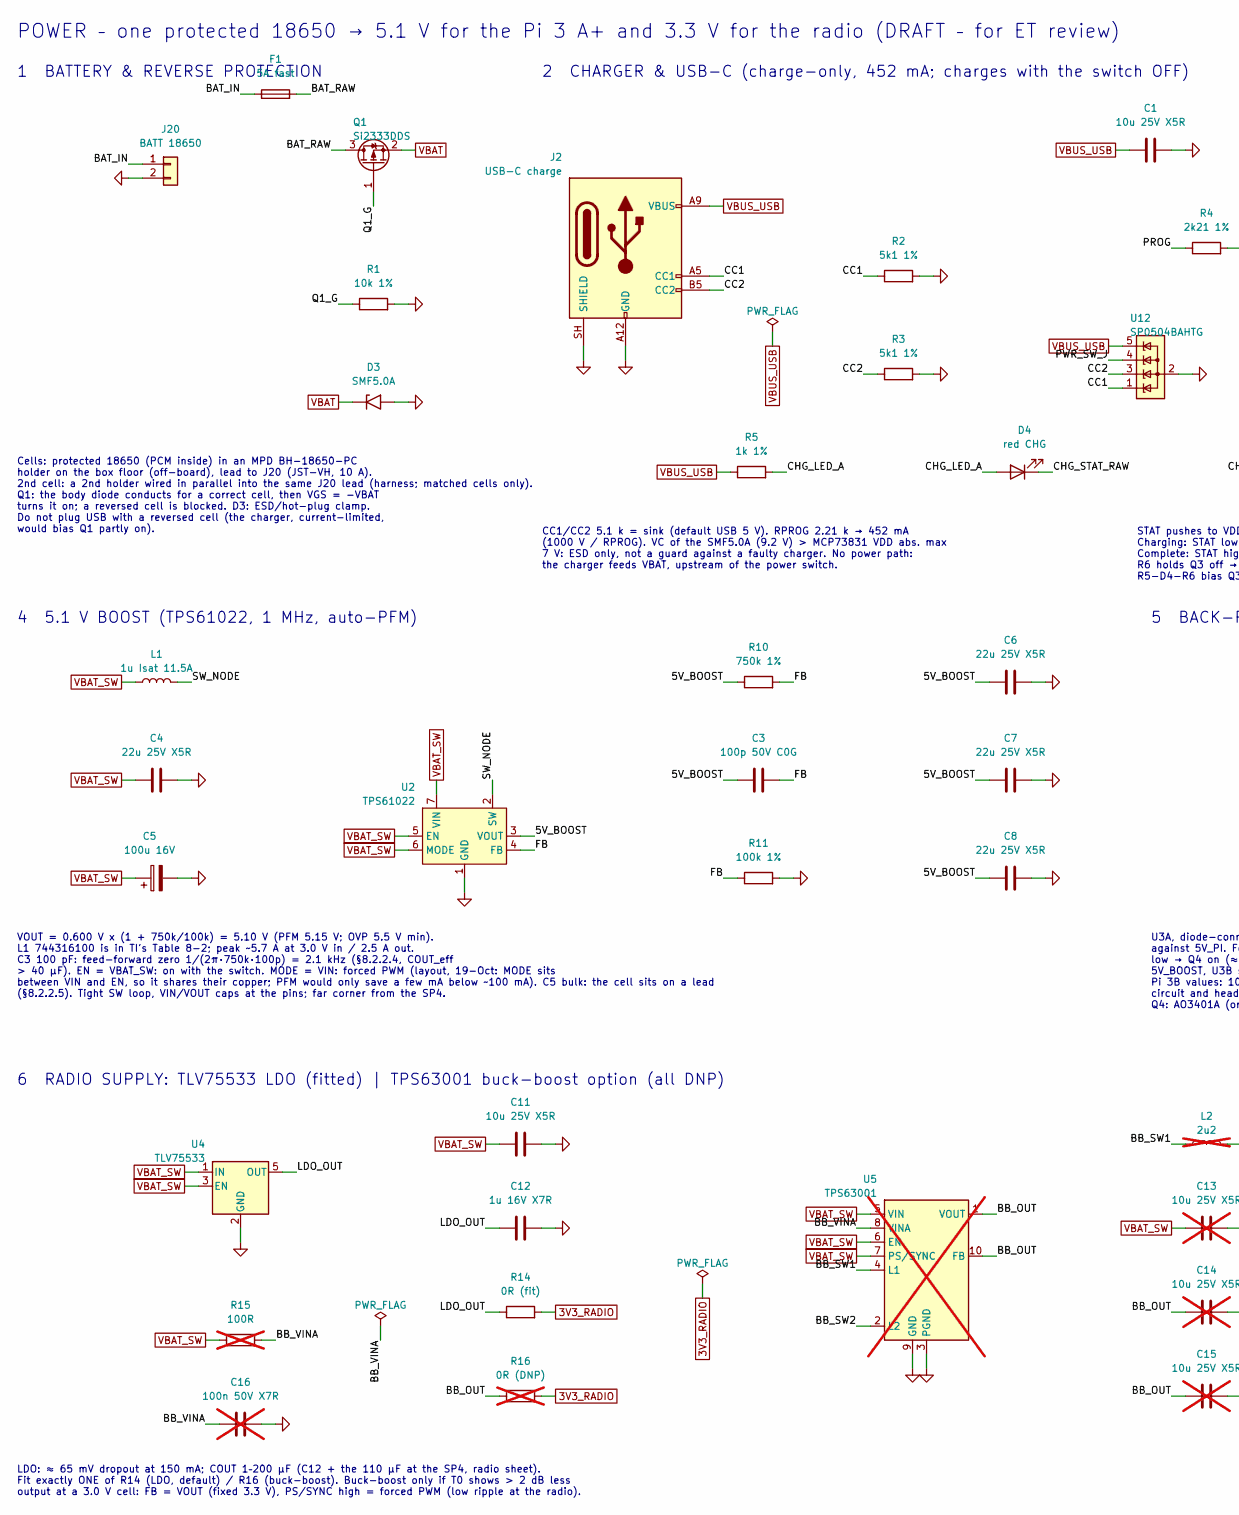
[picture p94: schematic power.kicad_sch, Power: cell, charger, boost, ideal diode, radio LDO, fuel g…, part in row 1, column 1]

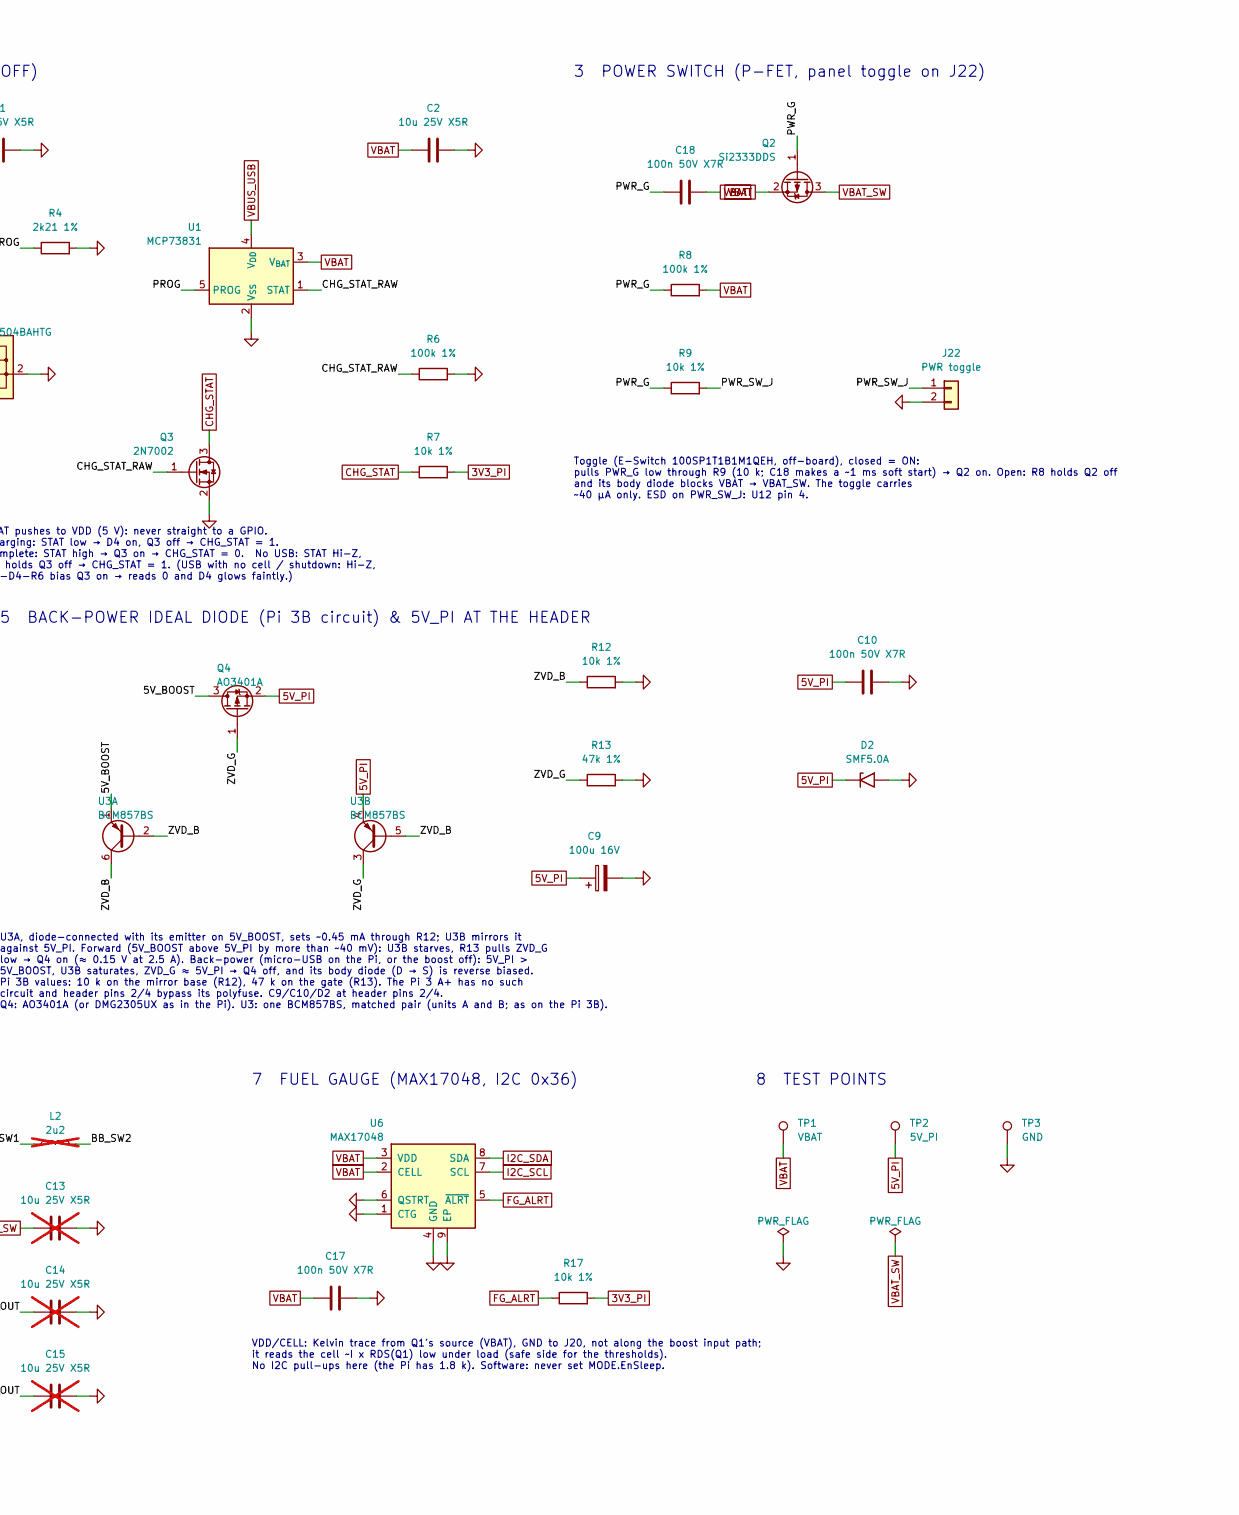
[picture p95: schematic power.kicad_sch, Power: cell, charger, boost, ideal diode, radio LDO, fuel g…, part in row 1, column 2]

Parts:
C1, C2, C11: 10u 25V X5R; C_0805_2012Metric_Pad1.18x1.45mm_HandSolder; MPN GRM21BR61E106KA73L
C3: 100p 50V C0G; C_0805_2012Metric_Pad1.18x1.45mm_HandSolder; MPN GRM2165C1H101JA01D
C4, C6, C7, C8: 22u 25V X5R; C_1206_3216Metric_Pad1.33x1.80mm_HandSolder; MPN GRM31CR61E226KE15L
C5, C9: 100u 16V; CP_Elec_6.3x5.4; MPN EEE-FK1C101P
C10, C17, C18: 100n 50V X7R; C_0805_2012Metric_Pad1.18x1.45mm_HandSolder; MPN GRM21BR71H104KA01L
C12: 1u 16V X7R; C_0805_2012Metric_Pad1.18x1.45mm_HandSolder; MPN GRM21BR71C105KA01L
C13, C14, C15: 10u 25V X5R; C_0805_2012Metric_Pad1.18x1.45mm_HandSolder; MPN GRM21BR61E106KA73L; not fitted
C16: 100n 50V X7R; C_0805_2012Metric_Pad1.18x1.45mm_HandSolder; MPN GRM21BR71H104KA01L; not fitted
D2, D3: SMF5.0A; D_SMF; MPN SMF5V0A-E3-08
D4: red CHG; LED_0805_2012Metric_Pad1.15x1.40mm_HandSolder; MPN 150080RS75000
F1: 5A fast; Fuse_1206_3216Metric_Pad1.42x1.75mm_HandSolder; MPN 0466005.NR (1206 fast, 5 A; verify)
J2: USB-C charge; USB_C_Receptacle_GCT_USB4125-xx-x-0190_6P_TopMnt_Horizontal; MPN USB4125-GF-A-0190
J20: BATT 18650; JST_VH_B2P-VH_1x02_P3.96mm_Vertical; MPN B2P-VH
J22: PWR toggle; JST_XH_B2B-XH-A_1x02_P2.50mm_Vertical; MPN B2B-XH-A
L1: 1u Isat 11.5A; L_Wuerth_HCI-5040; MPN 744316100
L2: 2u2; L_Coilcraft_LPS4018; MPN LPS4018-222MRB; not fitted
Q1, Q2: Si2333DDS; SOT-23; MPN Si2333DDS-T1-GE3
Q3: 2N7002; SOT-23; MPN 2N7002,215
Q4: AO3401A; SOT-23; MPN AO3401A
R1, R7, R9, R12, R17: 10k 1%; R_0805_2012Metric_Pad1.20x1.40mm_HandSolder; MPN RC0805FR-0710KL
R2, R3: 5k1 1%; R_0805_2012Metric_Pad1.20x1.40mm_HandSolder; MPN RC0805FR-075K1L
R4: 2k21 1%; R_0805_2012Metric_Pad1.20x1.40mm_HandSolder; MPN RC0805FR-072K21L
R5: 1k 1%; R_0805_2012Metric_Pad1.20x1.40mm_HandSolder; MPN RC0805FR-071KL
R6, R8, R11: 100k 1%; R_0805_2012Metric_Pad1.20x1.40mm_HandSolder; MPN RC0805FR-07100KL
R10: 750k 1%; R_0805_2012Metric_Pad1.20x1.40mm_HandSolder; MPN RC0805FR-07750KL
R13: 47k 1%; R_0805_2012Metric_Pad1.20x1.40mm_HandSolder; MPN RC0805FR-0747KL
R14: 0R (fit); R_0805_2012Metric_Pad1.20x1.40mm_HandSolder; MPN RC0805JR-070RL
R15: 100R; R_0805_2012Metric_Pad1.20x1.40mm_HandSolder; MPN RC0805FR-07100RL; not fitted
R16: 0R (DNP); R_0805_2012Metric_Pad1.20x1.40mm_HandSolder; MPN RC0805JR-070RL; not fitted
TP1: VBAT; TestPoint_Loop_D2.50mm_Drill1.0mm; MPN wire loop (or Keystone 5000/5001)
TP2: 5V_PI; TestPoint_Loop_D2.50mm_Drill1.0mm; MPN wire loop (or Keystone 5000/5001)
TP3: GND; TestPoint_Loop_D2.50mm_Drill1.0mm; MPN wire loop (or Keystone 5000/5001)
U1: MCP73831; SOT-23-5; MPN MCP73831T-2ACI/OT
U2: TPS61022; Texas_RWU0007A_VQFN-7_2x2mm_P0.5mm; MPN TPS61022RWUR
U3: BCM857BS; SOT-363_SC-70-6; MPN BCM857BS,115
U4: TLV75533; SOT-23-5; MPN TLV75533PDBVR
U5: TPS63001; Texas_DRC0010J; MPN TPS63001DRCR; not fitted
U6: MAX17048; MAX17048_TDFN-8-1EP_2x2mm; MPN MAX17048G+T10
U12: SP0504BAHTG; SOT-23-5; MPN SP0504BAHTG

Connections:
3V3_PI: R7.2, R17.2; also elsewhere on the board
3V3_RADIO: R14.2, R16.2; also elsewhere on the board
5V_PI: C9.1, C10.1, D2.1 (A1), Q4.2 (S), TP2.1, U3.4 (E2); also elsewhere on the board
/power/5V_BOOST: C3.1, C6.1, C7.1, C8.1, Q4.3 (D), R10.1, U2.3 (VOUT), U3.1 (E1)
/power/BAT_IN: F1.1, J20.1
/power/BAT_RAW: F1.2, Q1.3 (D)
/power/BB_OUT: C14.1, C15.1, R16.1, U5.1 (VOUT), U5.10 (FB)
/power/BB_SW1: L2.1, U5.4 (L1)
/power/BB_SW2: L2.2, U5.2 (L2)
/power/BB_VINA: C16.1, R15.2, U5.8 (VINA)
/power/CC1: J2.A5 (CC1), R2.1, U12.1 (K)
/power/CC2: J2.B5 (CC2), R3.1, U12.3 (K)
/power/CHG_LED_A: D4.2 (A), R5.2
/power/CHG_STAT_RAW: D4.1 (K), Q3.1 (G), R6.1, U1.1 (STAT)
/power/FB: C3.2, R10.2, R11.1, U2.4 (FB)
/power/LDO_OUT: C12.1, R14.1, U4.5 (OUT)
/power/PROG: R4.1, U1.5 (PROG)
/power/PWR_G: C18.1, Q2.1 (G), R8.1, R9.1
/power/PWR_SW_J: J22.1, R9.2, U12.4 (K)
/power/Q1_G: Q1.1 (G), R1.1
/power/SW_NODE: L1.2, U2.2 (SW)
/power/ZVD_B: R12.1, U3.2 (B1), U3.5 (B2), U3.6 (C1)
/power/ZVD_G: Q4.1 (G), R13.1, U3.3 (C2)
CHG_STAT: Q3.3 (D), R7.1; also elsewhere on the board
FG_ALRT: R17.1, U6.5 (~ALRT); also elsewhere on the board
GND: C1.2, C2.2, C4.2, C5.2, C6.2, C7.2, C8.2, C9.2, C10.2, C11.2, C12.2, C13.2, C14.2, C15.2, C16.2, C17.2, D2.2 (A2), D3.2 (A2), J2.A12 (GND), J2.B12 (GND), J2.SH (SHIELD), J20.2, J22.2, Q3.2 (S), R1.2, R2.2, R3.2, R4.2, R6.2, R11.2, R12.2, R13.2, TP3.1, U1.2 (V_{SS}), U2.1 (GND), U4.2 (GND), U5.3 (PGND), U5.9 (GND), U5.11 (PGND), U6.1 (CTG), U6.4 (GND), U6.6 (QSTRT), U6.9 (EP), U12.2 (A); also elsewhere on the board
I2C_SCL: U6.7 (SCL); also elsewhere on the board
I2C_SDA: U6.8 (SDA); also elsewhere on the board
VBAT: C2.1, C17.1, C18.2, D3.1 (A1), Q1.2 (S), Q2.2 (S), R8.2, TP1.1, U1.3 (V_{BAT}), U6.2 (CELL), U6.3 (VDD)
VBAT_SW: C4.1, C5.1, C11.1, C13.1, L1.1, Q2.3 (D), R15.1, U2.5 (EN), U2.6 (MODE), U2.7 (VIN), U4.1 (IN), U4.3 (EN), U5.5 (VIN), U5.6 (EN), U5.7 (PS/SYNC)
VBUS_USB: C1.1, J2.A9 (VBUS), J2.B9 (VBUS), R5.1, U1.4 (V_{DD}), U12.5 (K)

Notes on the sheet:
POWER – one protected 18650 → 5.1 V for the Pi 3 A+ and 3.3 V for the radio (DRAFT – for ET review)
1 BATTERY & REVERSE PROTECTION
Cells: protected 18650 (PCM inside) in an MPD BH-18650-PC holder on the box floor (off-board), lead to J20 (JST-VH, 10 A). 2nd cell: a 2nd holder wired in parallel into the same J20 lead (harness; matched cells only). Q1: the body diode conducts for a correct cell, then VGS = -VBAT turns it on; a r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
2 CHARGER & USB-C (charge-only, 452 mA; charges with the switch OFF)
CC1/CC2 5.1 k = sink (default USB 5 V). RPROG 2.21 k → 452 mA (1000 V / RPROG). VC of the SMF5.0A (9.2 V) > MCP73831 VDD abs. max 7 V: ESD only, not a guard against a faulty charger. No power path: the charger feeds VBAT, upstream of the power switch.
STAT pushes to VDD (5 V): never straight to a GPIO. Charging: STAT low → D4 on, Q3 off → CHG_STAT = 1. Complete: STAT high → Q3 on → CHG_STAT = 0. No USB: STAT Hi-Z, R6 holds Q3 off → CHG_STAT = 1. (USB with no cell / shutdown: Hi-Z, R5-D4-R6 bias Q3 on → reads 0 and D4 glows faintly.)
3 POWER SWITCH (P-FET, panel toggle on J22)
Toggle (E-Switch 100SP1T1B1M1QEH, off-board), closed = ON: pulls PWR_G low through R9 (10 k; C18 makes a ~1 ms soft start) → Q2 on. Open: R8 holds Q2 off and its body diode blocks VBAT → VBAT_SW. The toggle carries ~40 µA only. ESD on PWR_SW_J: U12 pin 4.
4 5.1 V BOOST (TPS61022, 1 MHz, auto-PFM)
VOUT = 0.600 V x (1 + 750k/100k) = 5.10 V (PFM 5.15 V; OVP 5.5 V min). L1 744316100 is in TI's Table 8-2; peak ~5.7 A at 3.0 V in / 2.5 A out. C3 100 pF: feed-forward zero 1/(2π·750k·100p) = 2.1 kHz (§8.2.2.4, COUT_eff > 40 µF). EN = VBAT_SW: on with the switch. MODE = VIN: forced PWM (layout, 19-O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
5 BACK-POWER IDEAL DIODE (Pi 3B circuit) & 5V_PI AT THE HEADER
U3A, diode-connected with its emitter on 5V_BOOST, sets ~0.45 mA through R12; U3B mirrors it against 5V_PI. Forward (5V_BOOST above 5V_PI by more than ~40 mV): U3B starves, R13 pulls ZVD_G low → Q4 on (≈ 0.15 V at 2.5 A). Back-power (micro-USB on the Pi, or the boost off): 5V_PI > 5V_BOOST, U3B sat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
6 RADIO SUPPLY: TLV75533 LDO (fitted) | TPS63001 buck-boost option (all DNP)
LDO: ≈ 65 mV dropout at 150 mA; COUT 1–200 µF (C12 + the 110 µF at the SP4, radio sheet). Fit exactly ONE of R14 (LDO, default) / R16 (buck-boost). Buck-boost only if T0 shows > 2 dB less output at a 3.0 V cell: FB = VOUT (fixed 3.3 V), PS/SYNC high = forced PWM (low ripple at the radio).
7 FUEL GAUGE (MAX17048, I2C 0x36)
VDD/CELL: Kelvin trace from Q1's source (VBAT), GND to J20, not along the boost input path; it reads the cell ~I x RDS(Q1) low under load (safe side for the thresholds). No I2C pull-ups here (the Pi has 1.8 k). Software: never set MODE.EnSleep.
8 TEST POINTS

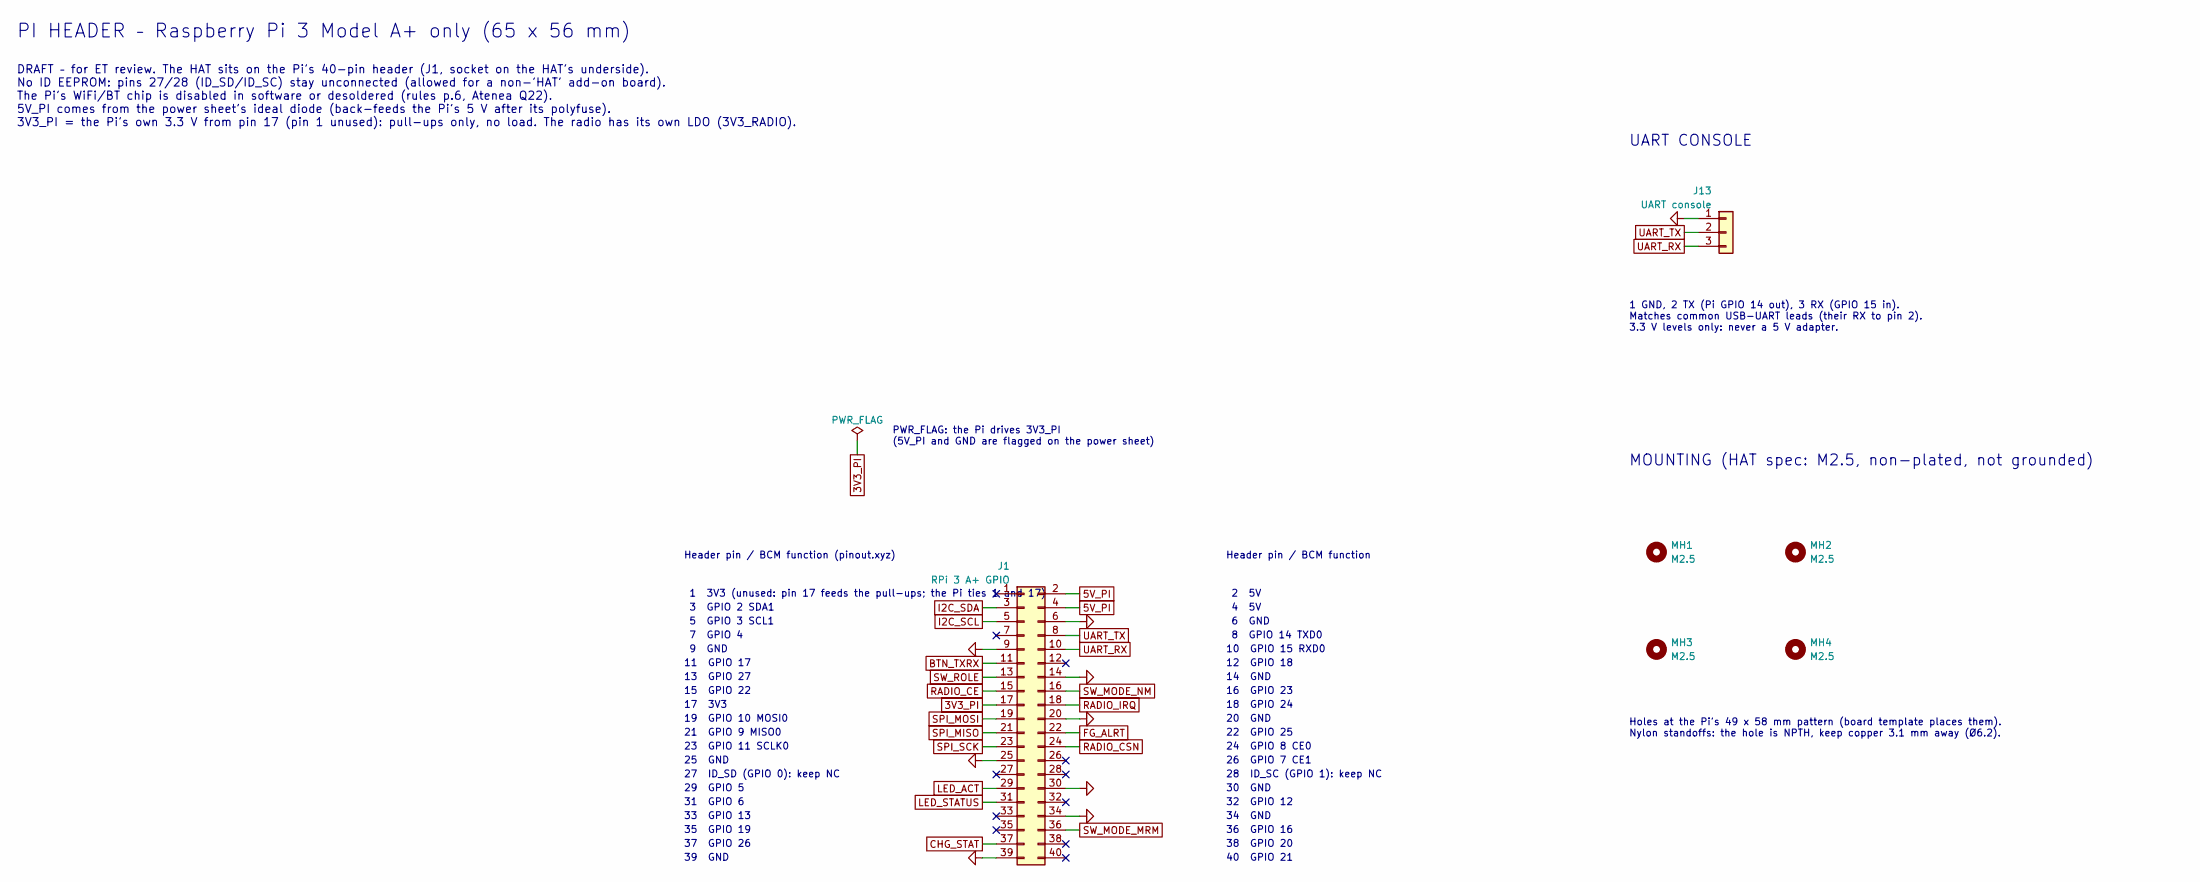
[picture p96: schematic pi_header.kicad_sch, Pi header: RPi 3 A+ 40-pin, UART, holes (DRAFT)]

Parts:
J1: RPi 3 A+ GPIO; PinSocket_2x20_P2.54mm_Vertical_Pad1.5mm; MPN M20-7832046 (2x20 female, 8.5 mm; 11 mm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
J13: UART console; PinHeader_1x03_P2.54mm_Vertical; MPN 61300311121 (1x03 2.54 mm pin header)
MH1, MH2, MH3, MH4: M2.5; MountingHole_2.7mm_M2.5; MPN Würth 970110155 standoff M2.5x11 F/F ny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

Connections:
3V3_PI: J1.17; also elsewhere on the board
5V_PI: J1.2, J1.4; also elsewhere on the board
BTN_TXRX: J1.11; also elsewhere on the board
CHG_STAT: J1.37; also elsewhere on the board
FG_ALRT: J1.22; also elsewhere on the board
GND: J1.6, J1.9, J1.14, J1.20, J1.25, J1.30, J1.34, J1.39, J13.1; also elsewhere on the board
I2C_SCL: J1.5; also elsewhere on the board
I2C_SDA: J1.3; also elsewhere on the board
LED_ACT: J1.29; also elsewhere on the board
LED_STATUS: J1.31; also elsewhere on the board
RADIO_CE: J1.15; also elsewhere on the board
RADIO_CSN: J1.24; also elsewhere on the board
RADIO_IRQ: J1.18; also elsewhere on the board
SPI_MISO: J1.21; also elsewhere on the board
SPI_MOSI: J1.19; also elsewhere on the board
SPI_SCK: J1.23; also elsewhere on the board
SW_MODE_MRM: J1.36; also elsewhere on the board
SW_MODE_NM: J1.16; also elsewhere on the board
SW_ROLE: J1.13; also elsewhere on the board
UART_RX: J1.10, J13.3
UART_TX: J1.8, J13.2

Notes on the sheet:
PI HEADER – Raspberry Pi 3 Model A+ only (65 x 56 mm)
DRAFT – for ET review. The HAT sits on the Pi's 40-pin header (J1, socket on the HAT's underside). No ID EEPROM: pins 27/28 (ID_SD/ID_SC) stay unconnected (allowed for a non-'HAT' add-on board). The Pi's WiFi/BT chip is disabled in software or desoldered (rules p.6, Atenea Q22). 5V_PI comes from th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
1 3V3 (unused: pin 17 feeds the pull-ups; the Pi ties 1 and 17)
2 5V
3 GPIO 2 SDA1
4 5V
5 GPIO 3 SCL1
6 GND
7 GPIO 4
8 GPIO 14 TXD0
9 GND
10 GPIO 15 RXD0
11 GPIO 17
12 GPIO 18
13 GPIO 27
14 GND
15 GPIO 22
16 GPIO 23
17 3V3
18 GPIO 24
19 GPIO 10 MOSI0
20 GND
21 GPIO 9 MISO0
22 GPIO 25
23 GPIO 11 SCLK0
24 GPIO 8 CE0
25 GND
26 GPIO 7 CE1
27 ID_SD (GPIO 0): keep NC
28 ID_SC (GPIO 1): keep NC
29 GPIO 5
30 GND
31 GPIO 6
32 GPIO 12
33 GPIO 13
34 GND
35 GPIO 19
36 GPIO 16
37 GPIO 26
38 GPIO 20
39 GND
40 GPIO 21
Header pin / BCM function (pinout.xyz)
Header pin / BCM function
PWR_FLAG: the Pi drives 3V3_PI (5V_PI and GND are flagged on the power sheet)
UART CONSOLE
1 GND, 2 TX (Pi GPIO 14 out), 3 RX (GPIO 15 in). Matches common USB-UART leads (their RX to pin 2). 3.3 V levels only: never a 5 V adapter.
MOUNTING (HAT spec: M2.5, non-plated, not grounded)
Holes at the Pi's 49 x 58 mm pattern (board template places them). Nylon standoffs: the hole is NPTH, keep copper 3.1 mm away (Ø6.2).

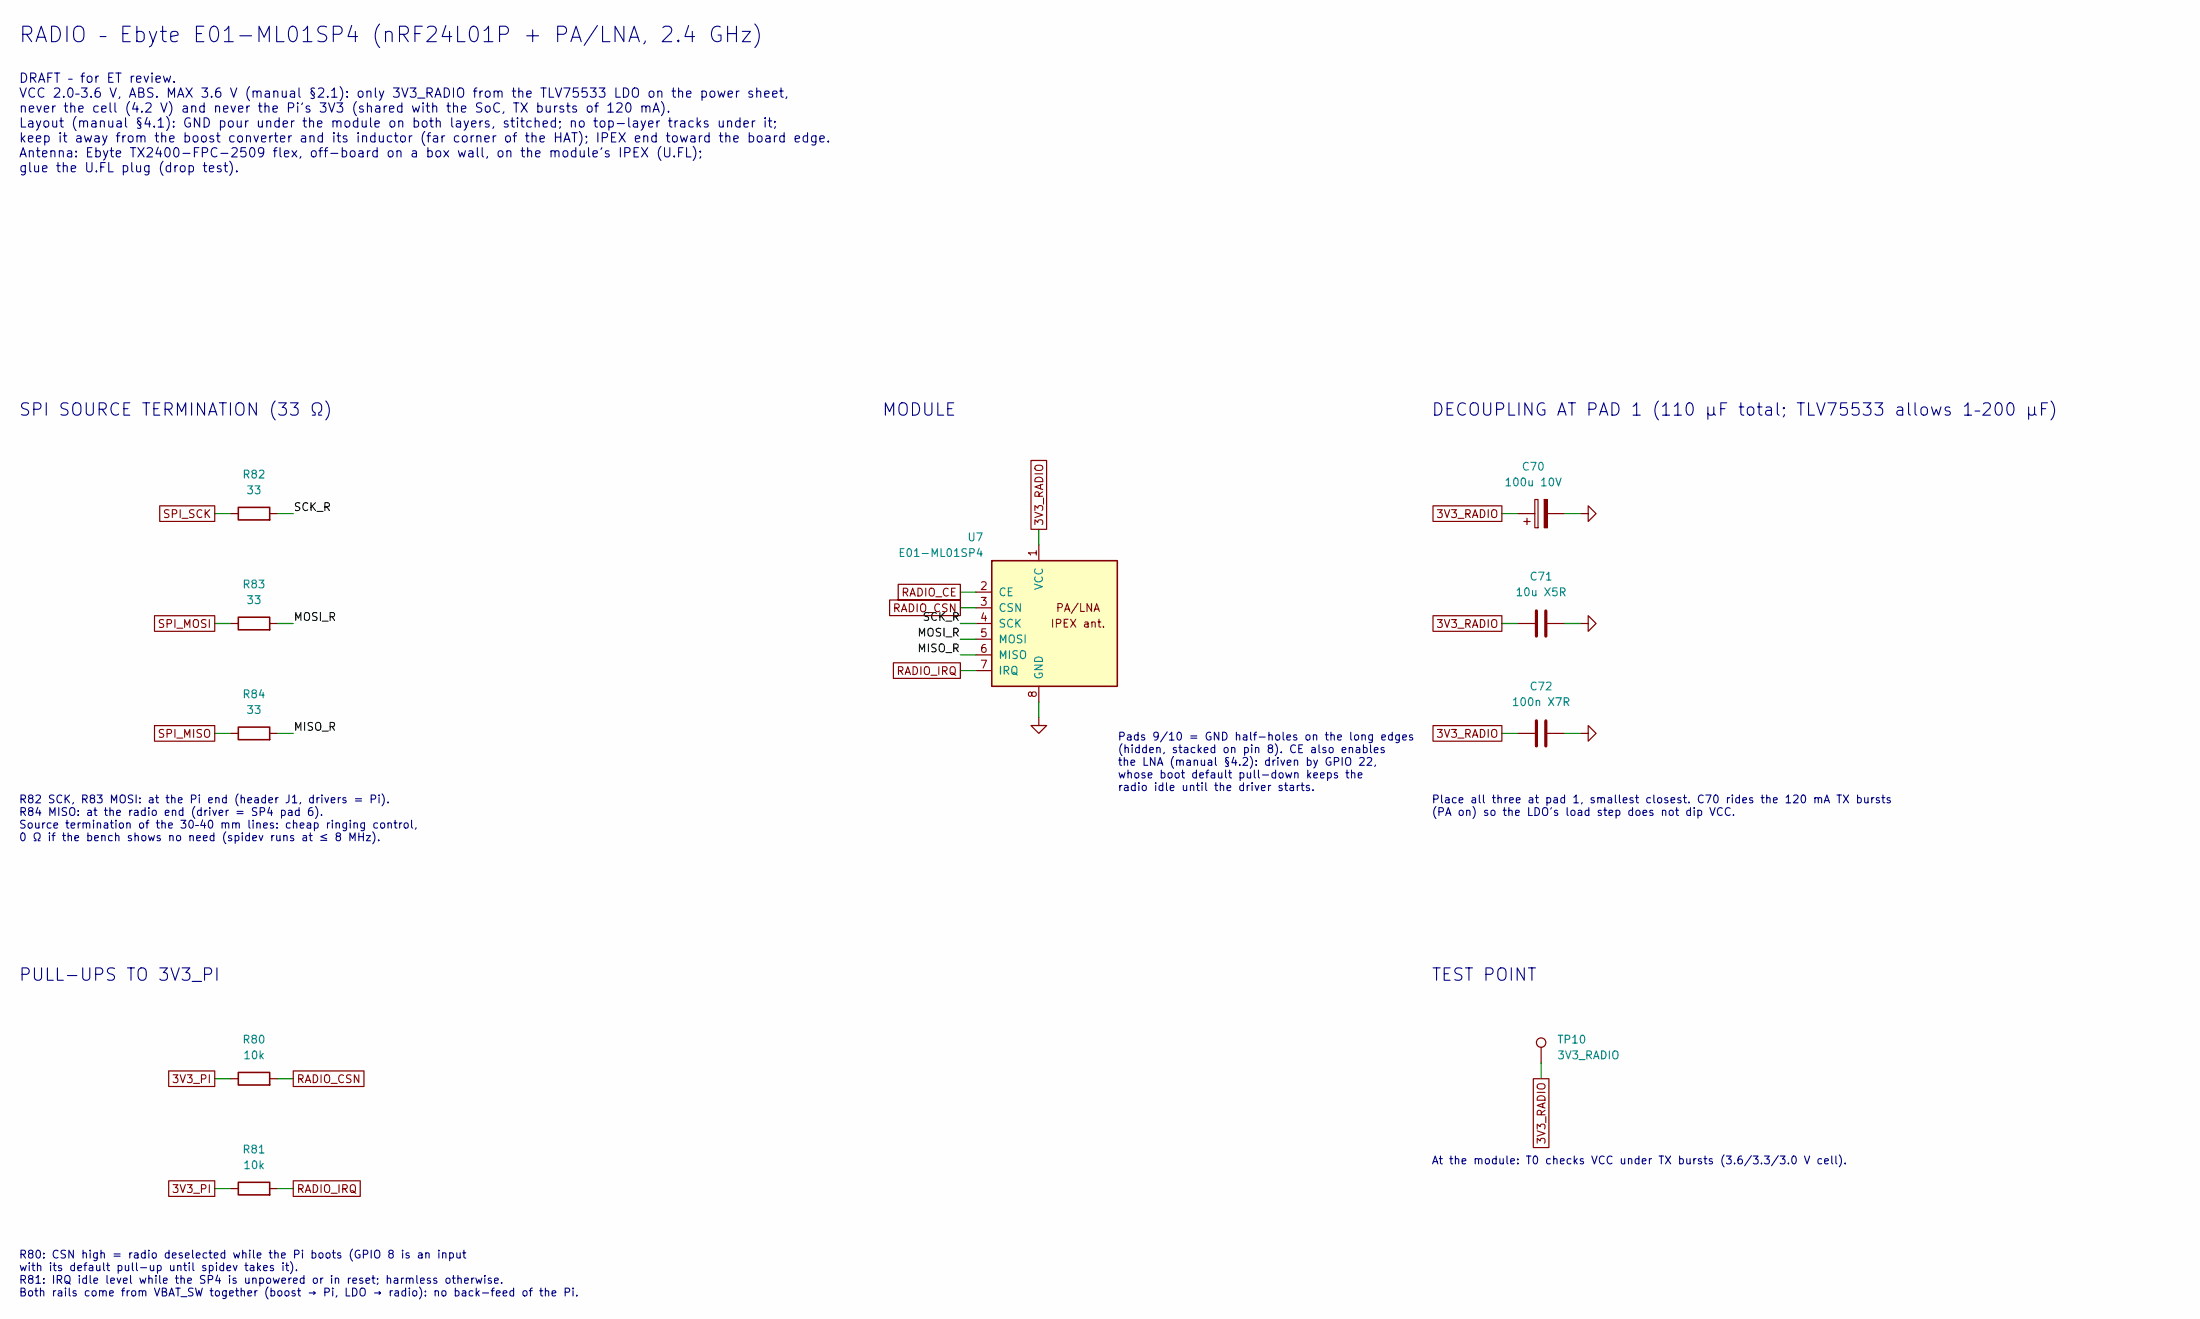
[picture p97: schematic radio.kicad_sch, Radio: E01-ML01SP4 (DRAFT – for ET review)]

Parts:
C70: 100u 10V; CP_Elec_6.3x5.4; MPN EEE-HA1A101WP (100 µF 10 V, 6.3 x 5.4 m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
C71: 10u X5R; C_0805_2012Metric_Pad1.18x1.45mm_HandSolder; MPN CL21A106KAYNNNE (10 µF 25 V X5R 0805)
C72: 100n X7R; C_0805_2012Metric_Pad1.18x1.45mm_HandSolder; MPN CL21B104KBCNNNC (100 nF 50 V X7R 0805)
R80, R81: 10k; R_0805_2012Metric_Pad1.20x1.40mm_HandSolder; MPN RC0805FR-0710KL
R82, R83, R84: 33; R_0805_2012Metric_Pad1.20x1.40mm_HandSolder; MPN RC0805FR-0733RL
TP10: 3V3_RADIO; TestPoint_Loop_D2.50mm_Drill1.0mm; MPN wire loop or Keystone 5000
U7: E01-ML01SP4; MPN E01-ML01SP4

Connections:
3V3_PI: R80.1, R81.1; also elsewhere on the board
3V3_RADIO: C70.1, C71.1, C72.1, TP10.1, U7.1 (VCC); also elsewhere on the board
/radio/MISO_R: R84.2, U7.6 (MISO)
/radio/MOSI_R: R83.2, U7.5 (MOSI)
/radio/SCK_R: R82.2, U7.4 (SCK)
GND: C70.2, C71.2, C72.2, U7.8 (GND), U7.9 (GND), U7.10 (GND); also elsewhere on the board
RADIO_CE: U7.2 (CE); also elsewhere on the board
RADIO_CSN: R80.2, U7.3 (CSN); also elsewhere on the board
RADIO_IRQ: R81.2, U7.7 (IRQ); also elsewhere on the board
SPI_MISO: R84.1; also elsewhere on the board
SPI_MOSI: R83.1; also elsewhere on the board
SPI_SCK: R82.1; also elsewhere on the board

Notes on the sheet:
RADIO – Ebyte E01-ML01SP4 (nRF24L01P + PA/LNA, 2.4 GHz)
DRAFT – for ET review. VCC 2.0–3.6 V, ABS. MAX 3.6 V (manual §2.1): only 3V3_RADIO from the TLV75533 LDO on the power sheet, never the cell (4.2 V) and never the Pi's 3V3 (shared with the SoC, TX bursts of 120 mA). Layout (manual §4.1): GND pour under the module on both layers, stitched; no top-lay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
MODULE
Pads 9/10 = GND half-holes on the long edges (hidden, stacked on pin 8). CE also enables the LNA (manual §4.2): driven by GPIO 22, whose boot default pull-down keeps the radio idle until the driver starts.
DECOUPLING AT PAD 1 (110 µF total; TLV75533 allows 1–200 µF)
Place all three at pad 1, smallest closest. C70 rides the 120 mA TX bursts (PA on) so the LDO's load step does not dip VCC.
SPI SOURCE TERMINATION (33 Ω)
R82 SCK, R83 MOSI: at the Pi end (header J1, drivers = Pi). R84 MISO: at the radio end (driver = SP4 pad 6). Source termination of the 30–40 mm lines: cheap ringing control, 0 Ω if the bench shows no need (spidev runs at ≤ 8 MHz).
PULL-UPS TO 3V3_PI
R80: CSN high = radio deselected while the Pi boots (GPIO 8 is an input with its default pull-up until spidev takes it). R81: IRQ idle level while the SP4 is unpowered or in reset; harmless otherwise. Both rails come from VBAT_SW together (boost → Pi, LDO → radio): no back-feed of the Pi.
TEST POINT
At the module: T0 checks VCC under TX bursts (3.6/3.3/3.0 V cell).

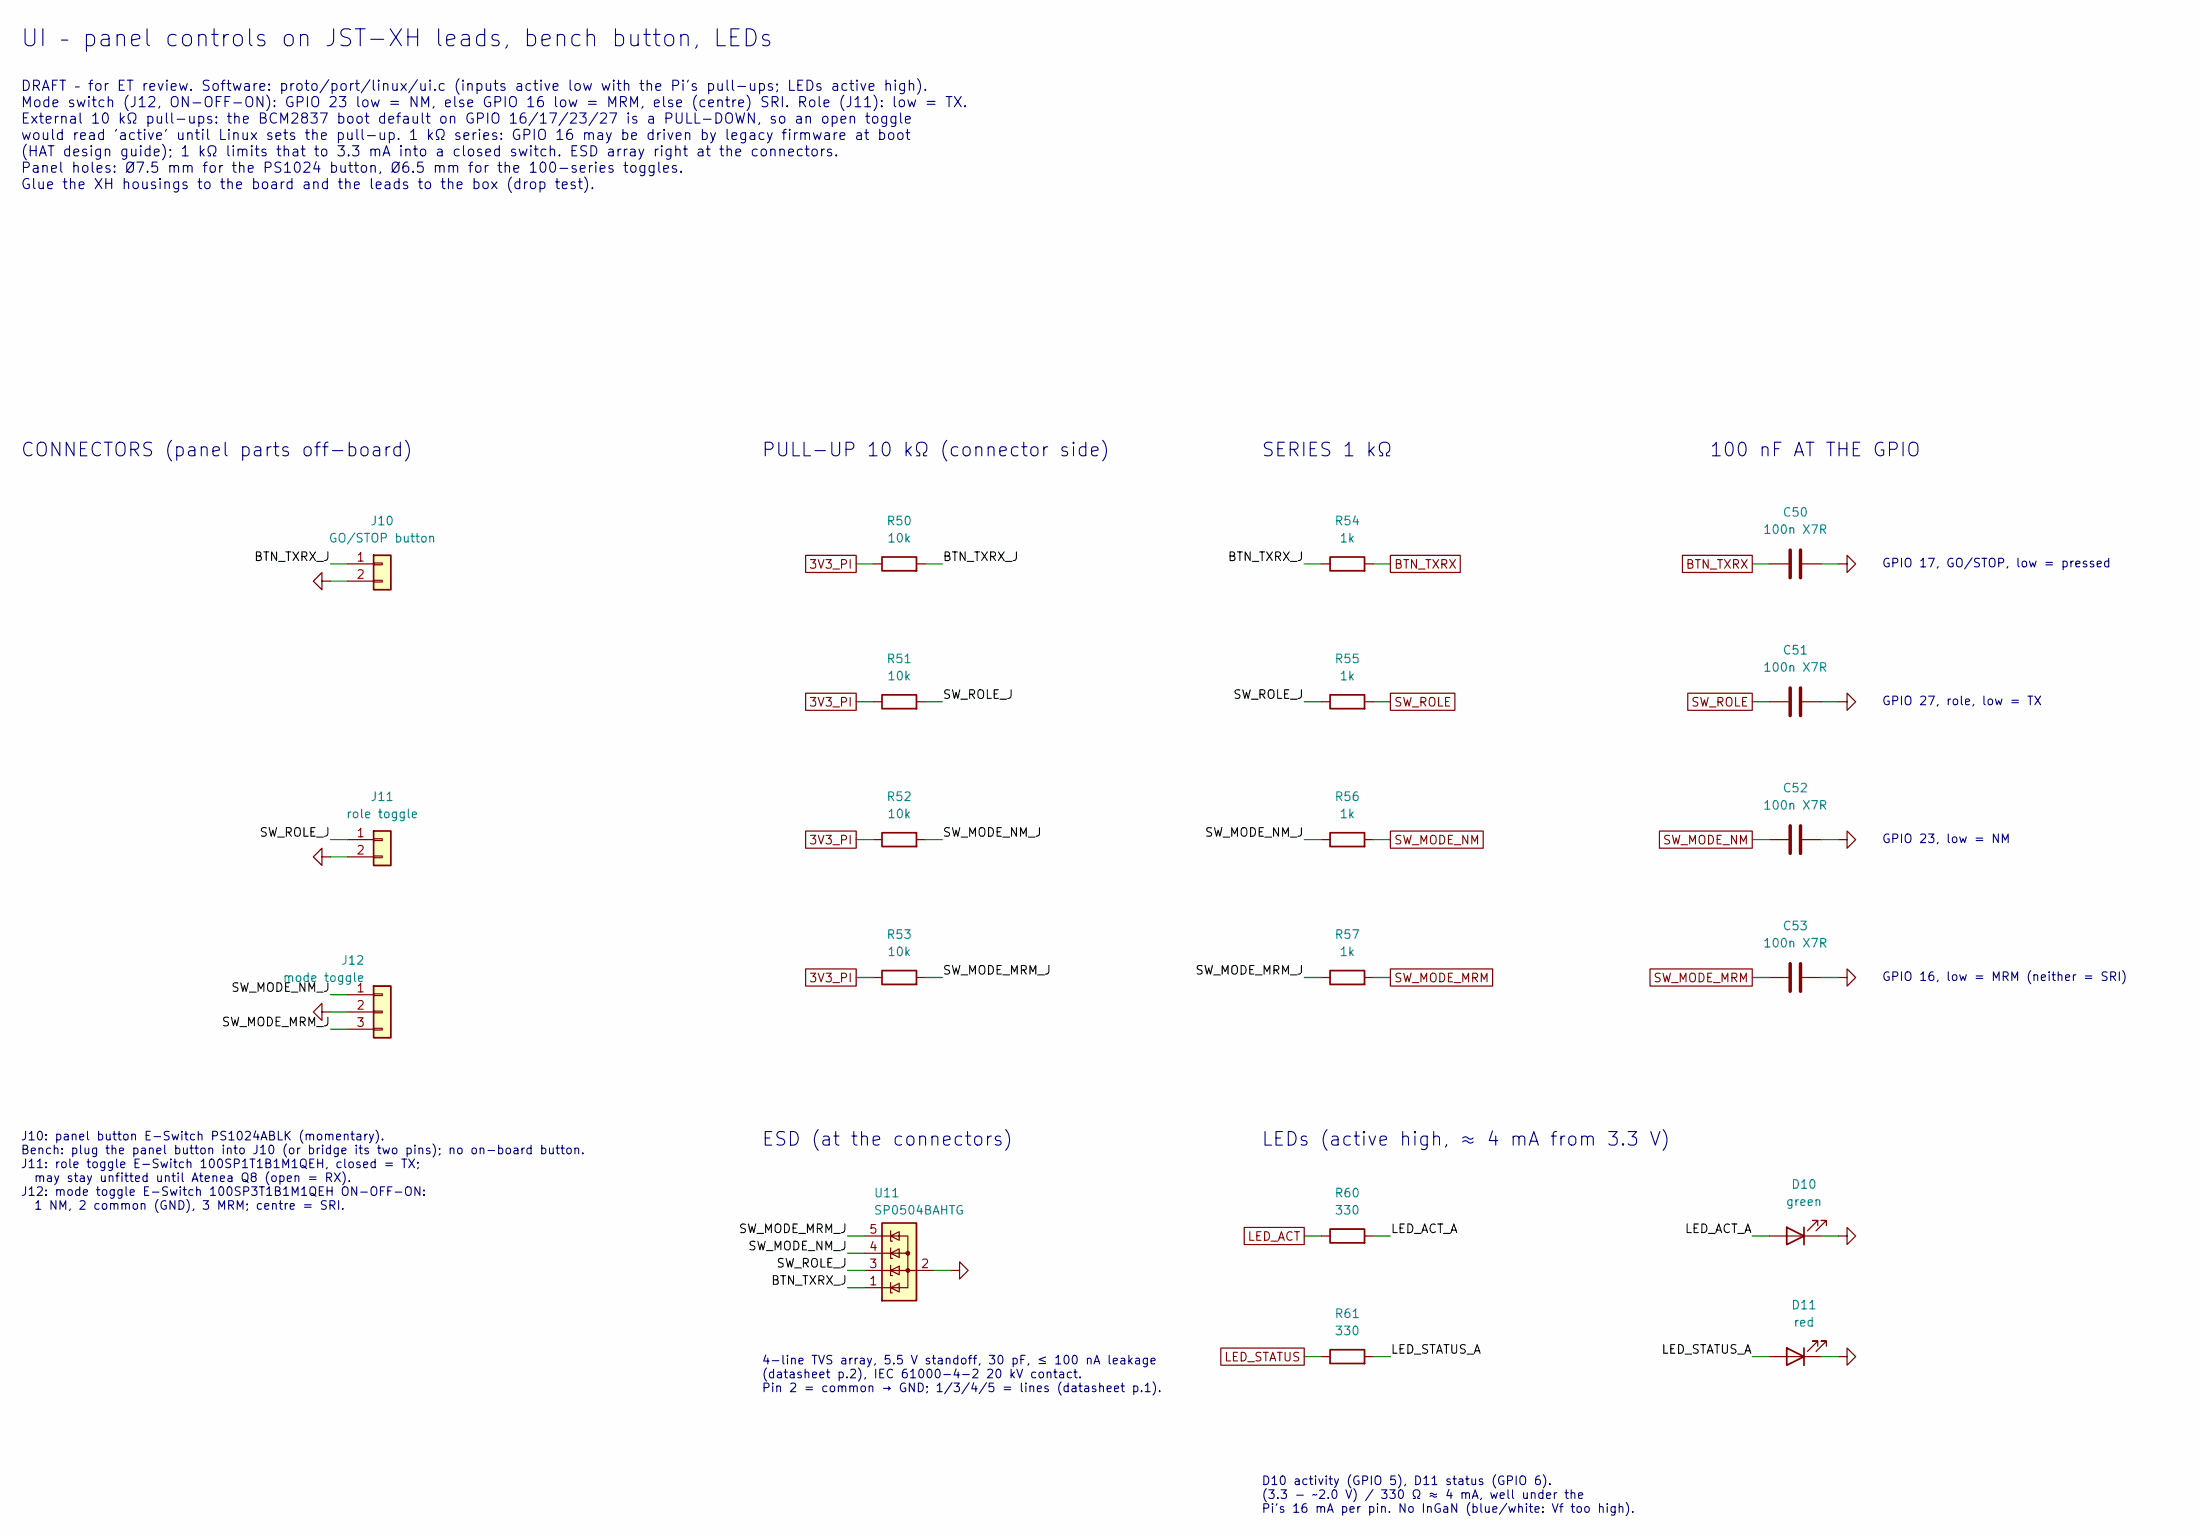
[picture p98: schematic ui.kicad_sch, UI: panel button, toggles, LEDs (DRAFT – for ET review)]

Parts:
C50, C51, C52, C53: 100n X7R; C_0805_2012Metric_Pad1.18x1.45mm_HandSolder; MPN CL21B104KBCNNNC
D10: green; LED_0805_2012Metric_Pad1.15x1.40mm_HandSolder; MPN 150080VS75000
D11: red; LED_0805_2012Metric_Pad1.15x1.40mm_HandSolder; MPN 150080RS75000
J10: GO/STOP button; JST_XH_B2B-XH-A_1x02_P2.50mm_Vertical; MPN B2B-XH-A(LF)(SN)
J11: role toggle; JST_XH_B2B-XH-A_1x02_P2.50mm_Vertical; MPN B2B-XH-A(LF)(SN)
J12: mode toggle; JST_XH_B3B-XH-A_1x03_P2.50mm_Vertical; MPN B3B-XH-A(LF)(SN)
R50, R51, R52, R53: 10k; R_0805_2012Metric_Pad1.20x1.40mm_HandSolder; MPN RC0805FR-0710KL
R54, R55, R56, R57: 1k; R_0805_2012Metric_Pad1.20x1.40mm_HandSolder; MPN RC0805FR-071KL
R60, R61: 330; R_0805_2012Metric_Pad1.20x1.40mm_HandSolder; MPN RC0805FR-07330RL
U11: SP0504BAHTG; SOT-23-5; MPN SP0504BAHTG

Connections:
3V3_PI: R50.1, R51.1, R52.1, R53.1; also elsewhere on the board
/ui/BTN_TXRX_J: J10.1, R50.2, R54.1, U11.1 (K)
/ui/LED_ACT_A: D10.2 (A), R60.2
/ui/LED_STATUS_A: D11.2 (A), R61.2
/ui/SW_MODE_MRM_J: J12.3, R53.2, R57.1, U11.5 (K)
/ui/SW_MODE_NM_J: J12.1, R52.2, R56.1, U11.4 (K)
/ui/SW_ROLE_J: J11.1, R51.2, R55.1, U11.3 (K)
BTN_TXRX: C50.1, R54.2; also elsewhere on the board
GND: C50.2, C51.2, C52.2, C53.2, D10.1 (K), D11.1 (K), J10.2, J11.2, J12.2, U11.2 (A); also elsewhere on the board
LED_ACT: R60.1; also elsewhere on the board
LED_STATUS: R61.1; also elsewhere on the board
SW_MODE_MRM: C53.1, R57.2; also elsewhere on the board
SW_MODE_NM: C52.1, R56.2; also elsewhere on the board
SW_ROLE: C51.1, R55.2; also elsewhere on the board

Notes on the sheet:
UI – panel controls on JST-XH leads, bench button, LEDs
DRAFT – for ET review. Software: proto/port/linux/ui.c (inputs active low with the Pi's pull-ups; LEDs active high). Mode switch (J12, ON-OFF-ON): GPIO 23 low = NM, else GPIO 16 low = MRM, else (centre) SRI. Role (J11): low = TX. External 10 kΩ pull-ups: the BCM2837 boot default on GPIO 16/17/23/27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
CONNECTORS (panel parts off-board)
J10: panel button E-Switch PS1024ABLK (momentary). Bench: plug the panel button into J10 (or bridge its two pins); no on-board button. J11: role toggle E-Switch 100SP1T1B1M1QEH, closed = TX; may stay unfitted until Atenea Q8 (open = RX). J12: mode toggle E-Switch 100SP3T1B1M1QEH ON-OFF-ON: 1 NM, 2 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
PULL-UP 10 kΩ (connector side)
SERIES 1 kΩ
100 nF AT THE GPIO
GPIO 17, GO/STOP, low = pressed
GPIO 27, role, low = TX
GPIO 23, low = NM
GPIO 16, low = MRM (neither = SRI)
ESD (at the connectors)
4-line TVS array, 5.5 V standoff, 30 pF, ≤ 100 nA leakage (datasheet p.2), IEC 61000-4-2 20 kV contact. Pin 2 = common → GND; 1/3/4/5 = lines (datasheet p.1).
LEDs (active high, ≈ 4 mA from 3.3 V)
D10 activity (GPIO 5), D11 status (GPIO 6). (3.3 − ~2.0 V) / 330 Ω ≈ 4 mA, well under the Pi's 16 mA per pin. No InGaN (blue/white: Vf too high).

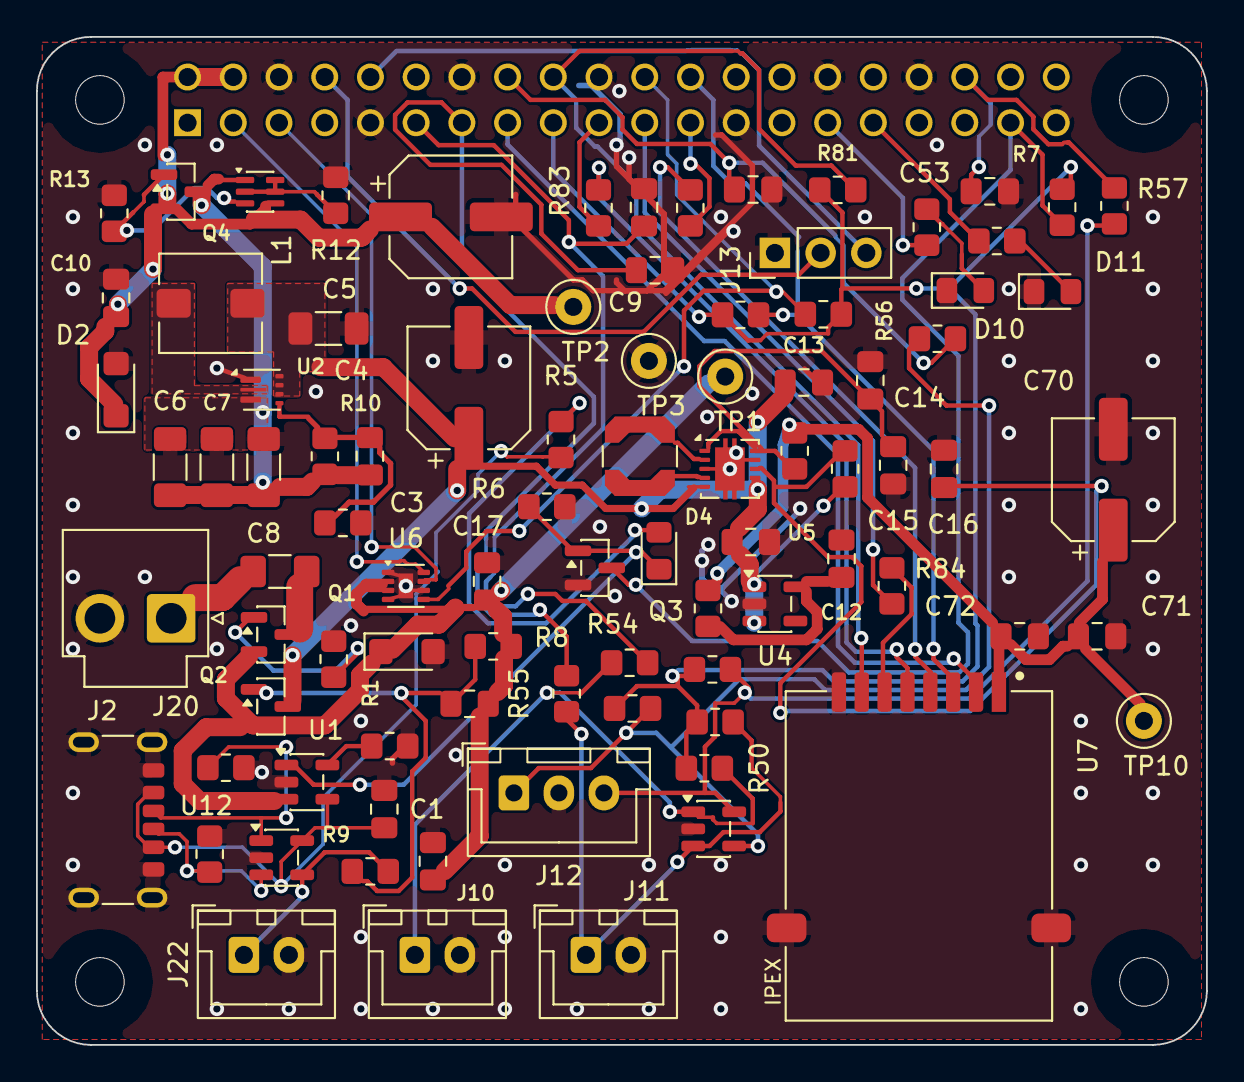
[picture p99: board teamc-carrier.kicad_pcb from above]

Board: 2 copper layers, 65.0 x 56.0 mm, 94 parts (1 on the bottom side), 54 nets.
