MicheleLamberti/mtp-f26-teamc/radio/fw/test/test_main.c

/* Host tests for the Team C radio firmware. Run: make -C radio/fw test */
#include <stdio.h>
#include <string.h>

#include "../crc16.h"
#include "../nrf24.h"
#include "mock_nrf24.h"

static int failures, checks;
#define CHECK(cond)                                                              \
    do {                                                                         \
        checks++;                                                                \
        if (!(cond)) {                                                           \
            failures++;                                                          \
            printf("  FAIL %s:%d: %s\n", __FILE__, __LINE__, #cond);             \
        }                                                                        \
    } while (0)

static const nrf24_profile_t *const PROFILES[] = {&NRF24_PROFILE_TEAM_250K, &NRF24_PROFILE_TEAM_1M,
                                                  &NRF24_PROFILE_NM_COMMON, &NRF24_PROFILE_TEAM_FHSS,
                                                  &NRF24_PROFILE_TEAM_20DBM_FIXED};
#define N_PROFILES (sizeof PROFILES / sizeof PROFILES[0])

typedef struct {
    mock_nrf24_t m;
    nrf24_hal_t hal;
    nrf24_t dev;
} node_t;

static nrf24_status_t node_up(node_t *n, const nrf24_profile_t *p)
{
    mock_init(&n->m);
    mock_hal(&n->m, &n->hal);
    return nrf24_init(&n->dev, &n->hal, p);
}

static void test_crc(void)
{
    const uint8_t s[] = "123456789";
    CHECK(crc16_ccitt(s, 9) == 0x29B1u);
    CHECK(crc16_ccitt(s, 0) == 0xFFFFu);
}

static void test_airtime(void)
{
    /* Must match radio/phy_config.py: (1 + 5 + 32 + 2) * 8 + 9 = 329 bits. */
    CHECK(nrf24_airtime_us(&NRF24_PROFILE_TEAM_250K, 32) == 1316u);
    CHECK(nrf24_airtime_us(&NRF24_PROFILE_TEAM_1M, 32) == 329u);
    CHECK(nrf24_airtime_us(&NRF24_PROFILE_TEAM_250K, 7) == 516u);   /* ACK frame */
}

static void test_profiles(void)
{
    for (unsigned k = 0; k < N_PROFILES; k++) {
        const nrf24_profile_t *p = PROFILES[k];
        CHECK(p->rf_ch <= NRF24_MAX_LEGAL_CH);
        CHECK(p->max_len == NRF24_MAX_PAYLOAD);
        CHECK(p->crc_bytes == 2);
        CHECK(p->regs[p->n_regs - 1].addr == 0x00);                 /* CONFIG last */
        CHECK((p->regs[p->n_regs - 1].value & 0x0Eu) == 0x0Eu);     /* EN_CRC, CRCO, PWR_UP */
    }
    CHECK(memcmp(NRF24_PROFILE_NM_COMMON.address, NRF24_PROFILE_TEAM_250K.address, 5) != 0);
    CHECK(NRF24_PROFILE_NM_COMMON.rf_ch != NRF24_PROFILE_TEAM_250K.rf_ch);
}

static void test_init_writes_profile(void)
{
    for (unsigned k = 0; k < N_PROFILES; k++) {
        const nrf24_profile_t *p = PROFILES[k];
        node_t n;
        CHECK(node_up(&n, p) == NRF24_OK);
        for (unsigned i = 0; i < p->n_regs; i++)
            if (p->regs[i].addr != 0x07)   /* STATUS is write-1-to-clear */
                CHECK(n.m.regs[p->regs[i].addr] == p->regs[i].value);
        CHECK(memcmp(n.m.tx_addr, p->address, 5) == 0);
        CHECK(memcmp(n.m.rx_addr_p0, p->address, 5) == 0);
        CHECK(n.m.regs[0x01] == 0x01 && n.m.regs[0x04] == 0x00);    /* ENAA_P0 for DPL, no retries */
        CHECK(n.m.regs[0x1C] == 0x01 && n.m.regs[0x1D] == 0x05);    /* DPL + DYN_ACK */
        CHECK(n.m.now_us >= 100000u);                               /* power-on reset wait */
    }
    /* 250 kbps at RF_PWR -18 dBm: RF_DR_LOW only */
    node_t n;
    node_up(&n, &NRF24_PROFILE_TEAM_250K);
    CHECK(n.m.regs[0x06] == 0x20);
    node_up(&n, &NRF24_PROFILE_TEAM_1M);
    CHECK(n.m.regs[0x06] == 0x00);
}

static void test_init_errors(void)
{
    node_t n;
    mock_init(&n.m);
    mock_hal(&n.m, &n.hal);
    n.m.dead_spi = 1;
    CHECK(nrf24_init(&n.dev, &n.hal, &NRF24_PROFILE_TEAM_250K) == NRF24_ERR_SPI);

    mock_init(&n.m);
    mock_hal(&n.m, &n.hal);
    n.m.not_plus = 1;
    CHECK(nrf24_init(&n.dev, &n.hal, &NRF24_PROFILE_TEAM_250K) == NRF24_ERR_NOT_PLUS);
}

static void test_send_and_receive(void)
{
    node_t a, b;
    CHECK(node_up(&a, &NRF24_PROFILE_TEAM_250K) == NRF24_OK);
    CHECK(node_up(&b, &NRF24_PROFILE_TEAM_250K) == NRF24_OK);
    mock_link(&a.m, &b.m);
    CHECK(nrf24_start_rx(&b.dev) == NRF24_OK);

    uint8_t rx[32], len = 0;
    CHECK(nrf24_poll_rx(&b.dev, rx, &len) == NRF24_ERR_NODATA);

    uint8_t tx[32];
    for (unsigned i = 0; i < 32; i++)
        tx[i] = (uint8_t)(i * 7u + 1u);
    CHECK(nrf24_send(&a.dev, tx, 32) == NRF24_OK);
    CHECK(a.m.noack_writes == 1 && a.m.ack_writes == 0);   /* never ESB-ACKed frames */
    CHECK(a.m.short_ce_pulses == 0);
    CHECK((a.m.regs[0x07] & 0x20u) == 0);                   /* TX_DS cleared */
    CHECK(nrf24_poll_rx(&b.dev, rx, &len) == NRF24_OK);
    CHECK(len == 32 && memcmp(rx, tx, 32) == 0);

    /* Short frames keep their length (dynamic payload). */
    CHECK(nrf24_send(&a.dev, tx, 7) == NRF24_OK);
    CHECK(nrf24_poll_rx(&b.dev, rx, &len) == NRF24_OK && len == 7 && memcmp(rx, tx, 7) == 0);
    CHECK(nrf24_poll_rx(&b.dev, rx, &len) == NRF24_ERR_NODATA);
    CHECK((b.m.regs[0x07] & 0x40u) == 0);                   /* RX_DR cleared once empty */

    /* Turn-around: B answers, A listens. */
    CHECK(nrf24_start_rx(&a.dev) == NRF24_OK);
    CHECK(nrf24_send(&b.dev, tx, 5) == NRF24_OK);
    CHECK(b.dev.rx_on == 0);
    CHECK(nrf24_poll_rx(&a.dev, rx, &len) == NRF24_OK && len == 5);
}

static void test_isolation(void)
{
    node_t a, b;
    uint8_t tx[4] = {1, 2, 3, 4}, rx[32], len;

    /* Different channel: nothing arrives. */
    node_up(&a, &NRF24_PROFILE_TEAM_250K);
    node_up(&b, &NRF24_PROFILE_TEAM_250K);
    mock_link(&a.m, &b.m);
    CHECK(nrf24_set_channel(&b.dev, 24) == NRF24_OK);
    nrf24_start_rx(&b.dev);
    nrf24_send(&a.dev, tx, 4);
    CHECK(nrf24_poll_rx(&b.dev, rx, &len) == NRF24_ERR_NODATA);
    CHECK(nrf24_set_channel(&b.dev, NRF24_PROFILE_TEAM_250K.rf_ch) == NRF24_OK);
    nrf24_send(&a.dev, tx, 4);
    CHECK(nrf24_poll_rx(&b.dev, rx, &len) == NRF24_OK);

    /* Different address (NM vs team) on the same channel: nothing arrives. */
    node_up(&a, &NRF24_PROFILE_TEAM_250K);
    node_up(&b, &NRF24_PROFILE_NM_COMMON);
    mock_link(&a.m, &b.m);
    nrf24_set_channel(&b.dev, NRF24_PROFILE_TEAM_250K.rf_ch);
    nrf24_start_rx(&b.dev);
    nrf24_send(&a.dev, tx, 4);
    CHECK(nrf24_poll_rx(&b.dev, rx, &len) == NRF24_ERR_NODATA);

    /* Different rate: nothing arrives. */
    node_up(&a, &NRF24_PROFILE_TEAM_1M);
    node_up(&b, &NRF24_PROFILE_TEAM_250K);
    mock_link(&a.m, &b.m);
    nrf24_start_rx(&b.dev);
    nrf24_send(&a.dev, tx, 4);
    CHECK(nrf24_poll_rx(&b.dev, rx, &len) == NRF24_ERR_NODATA);

    /* RX off (standby): nothing arrives. */
    node_up(&a, &NRF24_PROFILE_TEAM_250K);
    node_up(&b, &NRF24_PROFILE_TEAM_250K);
    mock_link(&a.m, &b.m);
    nrf24_send(&a.dev, tx, 4);
    CHECK(b.m.rx_n == 0);
}

static void test_limits(void)
{
    node_t a;
    uint8_t buf[40] = {0}, len;
    node_up(&a, &NRF24_PROFILE_TEAM_250K);
    CHECK(nrf24_send(&a.dev, buf, 0) == NRF24_ERR_LEN);
    CHECK(nrf24_send(&a.dev, buf, 33) == NRF24_ERR_LEN);
    CHECK(a.m.frames_tx == 0);
    CHECK(nrf24_set_channel(&a.dev, 84) == NRF24_ERR_CH);   /* 2484 MHz: outside UN-85 */
    CHECK(nrf24_set_channel(&a.dev, 83) == NRF24_OK);
    CHECK(a.m.regs[0x05] == 83);

    /* RX FIFO is 3 deep: the 4th frame is dropped, the first 3 come out in order. */
    node_t b;
    node_up(&a, &NRF24_PROFILE_TEAM_250K);
    node_up(&b, &NRF24_PROFILE_TEAM_250K);
    mock_link(&a.m, &b.m);
    nrf24_start_rx(&b.dev);
    for (uint8_t i = 1; i <= 4; i++) {
        buf[0] = i;
        nrf24_send(&a.dev, buf, 1);
    }
    CHECK(b.m.rx_dropped == 1);
    for (uint8_t i = 1; i <= 3; i++)
        CHECK(nrf24_poll_rx(&b.dev, buf, &len) == NRF24_OK && buf[0] == i);
    CHECK(nrf24_poll_rx(&b.dev, buf, &len) == NRF24_ERR_NODATA);

    /* Corrupt width (> 32): flushed and reported. */
    nrf24_send(&a.dev, buf, 3);
    b.m.bad_width = 1;
    CHECK(nrf24_poll_rx(&b.dev, buf, &len) == NRF24_ERR_LEN && len == 0);
    CHECK(b.m.rx_n == 0);
}

static void test_tx_timeout(void)
{
    node_t a;
    uint8_t buf[8] = {0};
    node_up(&a, &NRF24_PROFILE_TEAM_250K);
    a.m.tx_stuck = 1;
    uint32_t t0 = a.m.now_us;
    CHECK(nrf24_send(&a.dev, buf, 8) == NRF24_ERR_TIMEOUT);
    CHECK(a.m.now_us - t0 < 10000u);   /* gives up within a few ms */
    CHECK(a.m.tx_n == 0);              /* TX FIFO flushed */
}

static void test_power_limit(void)
{
    /* Every generated profile stays at or below its cap: RF_PWR -18 dBm unless it is the LBT profile. */
    for (unsigned k = 0; k < N_PROFILES; k++)
        for (unsigned i = 0; i < PROFILES[k]->n_regs; i++)
            if (PROFILES[k]->regs[i].addr == 0x06)
                CHECK(((PROFILES[k]->regs[i].value >> 1) & 3u) <=
                      (PROFILES[k]->lbt ? NRF24_RF_PWR_MAX_BITS_FHSS : NRF24_RF_PWR_MAX_BITS));

    /* A profile asking for 0 dBm at the chip is refused before anything is written. */
    nrf24_reg_t regs[sizeof NRF24_REGS_TEAM_250K / sizeof NRF24_REGS_TEAM_250K[0]];
    memcpy(regs, NRF24_REGS_TEAM_250K, sizeof regs);
    for (unsigned i = 0; i < sizeof regs / sizeof regs[0]; i++)
        if (regs[i].addr == 0x06)
            regs[i].value = (uint8_t)(regs[i].value | 0x06u);
    nrf24_profile_t hot = NRF24_PROFILE_TEAM_250K;
    hot.regs = regs;
    node_t n;
    CHECK(node_up(&n, &hot) == NRF24_ERR_POWER);
    CHECK((n.m.regs[0x00] & 0x02u) == 0);   /* never powered up */

    /* A direct register write is clamped. */
    CHECK(node_up(&n, &NRF24_PROFILE_TEAM_250K) == NRF24_OK);
    nrf24_write_reg(&n.dev, 0x06, 0x26);
    CHECK(n.m.regs[0x06] == (uint8_t)(0x20u | (NRF24_RF_PWR_MAX_BITS << 1)));
}

/* D-R6 (SRI/MRM baseline): adaptive FHSS + LBT profile (EN 300 328 cl. 4.3.1.7.2). */
static void test_fhss_profile(void)
{
    const nrf24_profile_t *p = &NRF24_PROFILE_TEAM_FHSS;
    CHECK(p->lbt == 1 && p->pwr_max_bits == NRF24_RF_PWR_MAX_BITS_FHSS);
    CHECK(NRF24_RF_PWR_MAX_BITS_FHSS > NRF24_RF_PWR_MAX_BITS);
    CHECK(NRF24_FHSS_N >= 15u);                                  /* cl. 4.3.1.4.3.2 */
    CHECK(NRF24_FHSS_COT_US < 60000u && NRF24_FHSS_SLOT_US <= NRF24_FHSS_COT_US);
    CHECK(NRF24_FHSS_IDLE_US * 20u >= NRF24_FHSS_COT_US);        /* idle >= 5 % of COT */
    uint8_t lo = 255, hi = 0;
    int legal = 1, unique = 1;
    for (unsigned i = 0; i < NRF24_FHSS_N; i++) {
        uint8_t c = NRF24_FHSS_HOPSEQ[i];
        legal &= c <= NRF24_MAX_LEGAL_CH;
        for (unsigned j = 0; j < i; j++)
            unique &= NRF24_FHSS_HOPSEQ[j] != c;
        lo = c < lo ? c : lo;
        hi = c > hi ? c : hi;
    }
    CHECK(legal);
    CHECK(unique);                                               /* each channel once per cycle */
    CHECK(hi - lo >= 58);                                        /* >= 70 % of 83.5 MHz */
    CHECK(p->rf_ch == NRF24_FHSS_HOPSEQ[0]);
    CHECK(nrf24_fhss_channel(0) == NRF24_FHSS_HOPSEQ[0]);
    CHECK(nrf24_fhss_channel(NRF24_FHSS_N + 3u) == NRF24_FHSS_HOPSEQ[3]);

    /* The LBT profile gets its higher cap, and a register write still cannot exceed it. */
    node_t n;
    CHECK(node_up(&n, p) == NRF24_OK);
    CHECK(((n.m.regs[0x06] >> 1) & 3u) == NRF24_RF_PWR_MAX_BITS_FHSS);
    nrf24_write_reg(&n.dev, 0x06, 0x26);
    CHECK(n.m.regs[0x06] == (uint8_t)(0x20u | (NRF24_RF_PWR_MAX_BITS_FHSS << 1)));

    /* A fixed-channel profile cannot borrow the FHSS power: refused at init. */
    nrf24_profile_t fixed = *p;
    fixed.lbt = 0;
    CHECK(node_up(&n, &fixed) == NRF24_ERR_POWER);
    CHECK((n.m.regs[0x00] & 0x02u) == 0);

    /* Only hop-set channels; an odd channel (not in the even-channel hop set) is refused. */
    CHECK(node_up(&n, p) == NRF24_OK);
    CHECK(nrf24_set_channel(&n.dev, 25) == NRF24_ERR_CH);
    CHECK(nrf24_set_channel(&n.dev, nrf24_fhss_channel(1)) == NRF24_OK);
    nrf24_profile_t off = *p;
    off.rf_ch = 25;
    CHECK(node_up(&n, &off) == NRF24_ERR_CH);
}

static void test_fhss_lbt(void)
{
    const nrf24_profile_t *p = &NRF24_PROFILE_TEAM_FHSS;
    node_t a, b;
    uint8_t tx[32], rx[32], len;
    for (uint8_t i = 0; i < 32; i++)
        tx[i] = (uint8_t)(0xA0u + i);
    CHECK(node_up(&a, p) == NRF24_OK);
    CHECK(node_up(&b, p) == NRF24_OK);
    mock_link(&a.m, &b.m);
    nrf24_start_rx(&b.dev);

    /* No CCA, no frame. */
    CHECK(nrf24_send(&a.dev, tx, 32) == NRF24_ERR_LBT);
    CHECK(a.m.frames_tx == 0);

    /* Busy channel: CCA says so and the frame stays home. */
    a.m.rpd = 1;
    uint32_t t0 = a.m.now_us;
    CHECK(nrf24_cca(&a.dev) == 0);
    CHECK(a.m.now_us - t0 >= NRF24_TX_SETTLE_US + NRF24_FHSS_CCA_US);   /* listened long enough */
    CHECK(nrf24_send(&a.dev, tx, 32) == NRF24_ERR_LBT);
    CHECK(a.m.frames_tx == 0);

    /* Clear channel: the frame goes out and arrives. */
    a.m.rpd = 0;
    CHECK(nrf24_cca(&a.dev) == 1);
    CHECK(nrf24_send(&a.dev, tx, 32) == NRF24_OK);
    CHECK(nrf24_poll_rx(&b.dev, rx, &len) == NRF24_OK && len == 32 && memcmp(rx, tx, 32) == 0);

    /* Occupancy time: once the next frame would end past NRF24_FHSS_COT_US, a new CCA is needed. */
    a.m.now_us = a.dev.cot_start_us + NRF24_FHSS_COT_US - 1000u;
    CHECK(nrf24_send(&a.dev, tx, 32) == NRF24_ERR_LBT);
    uint32_t t1 = a.m.now_us;
    a.dev.last_tx_end_us = t1;                     /* as if the last frame just ended */
    CHECK(nrf24_cca(&a.dev) == 1);                 /* same channel: waits the idle gap first */
    CHECK(a.m.now_us - t1 >= NRF24_FHSS_IDLE_US + NRF24_FHSS_CCA_US);
    CHECK(nrf24_send(&a.dev, tx, 8) == NRF24_OK);
    CHECK(nrf24_poll_rx(&b.dev, rx, &len) == NRF24_OK && len == 8);

    /* Hopping clears the CCA: the next hop needs its own (and no idle gap on a new channel). */
    CHECK(nrf24_set_channel(&a.dev, nrf24_fhss_channel(1)) == NRF24_OK);
    CHECK(nrf24_send(&a.dev, tx, 8) == NRF24_ERR_LBT);
    uint32_t t2 = a.m.now_us;
    CHECK(nrf24_cca(&a.dev) == 1);
    CHECK(a.m.now_us - t2 < NRF24_FHSS_IDLE_US);
    CHECK(nrf24_send(&a.dev, tx, 8) == NRF24_OK);
    CHECK(nrf24_poll_rx(&b.dev, rx, &len) == NRF24_ERR_NODATA);  /* b is still on hop 0 */
    CHECK(nrf24_set_channel(&b.dev, nrf24_fhss_channel(1)) == NRF24_OK);
    nrf24_start_rx(&b.dev);
    CHECK(nrf24_cca(&a.dev) == 1);
    CHECK(nrf24_send(&a.dev, tx, 8) == NRF24_OK);
    CHECK(nrf24_poll_rx(&b.dev, rx, &len) == NRF24_OK && len == 8);  /* both on hop 1 */

    /* Fixed-channel profiles never need a CCA. */
    node_t c;
    CHECK(node_up(&c, &NRF24_PROFILE_TEAM_250K) == NRF24_OK);
    CHECK(nrf24_send(&c.dev, tx, 8) == NRF24_OK);
}

/* Option B (D-R6b): one fixed channel at 20 dBm with frame-based LBT (COT <= 10 ms). */
static void test_fixed20(void)
{
    const nrf24_profile_t *p = &NRF24_PROFILE_TEAM_20DBM_FIXED;
    CHECK(p->lbt == 1 && p->hop == 0 && p->pwr_max_bits == NRF24_RF_PWR_MAX_BITS_FHSS);
    CHECK(p->cot_us >= 1000u && p->cot_us <= 10000u && p->idle_us * 20u >= p->cot_us);
    node_t a, b;
    uint8_t tx[32] = {1, 2, 3}, rx[32], len;
    CHECK(node_up(&a, p) == NRF24_OK);
    CHECK(node_up(&b, p) == NRF24_OK);
    CHECK(((a.m.regs[0x06] >> 1) & 3u) == NRF24_RF_PWR_MAX_BITS_FHSS);
    mock_link(&a.m, &b.m);
    nrf24_start_rx(&b.dev);

    CHECK(nrf24_send(&a.dev, tx, 32) == NRF24_ERR_LBT);   /* LBT still required */
    CHECK(nrf24_cca(&a.dev) == 1);
    for (int i = 0; i < 3; i++) {                          /* 3 frames fit one 10 ms occupancy */
        CHECK(nrf24_send(&a.dev, tx, 32) == NRF24_OK);
        CHECK(nrf24_poll_rx(&b.dev, rx, &len) == NRF24_OK && len == 32);
    }
    a.m.now_us = a.dev.cot_start_us + p->cot_us - 1000u;
    CHECK(nrf24_send(&a.dev, tx, 32) == NRF24_ERR_LBT);   /* would end past the 10 ms COT */
    uint32_t t = a.m.now_us;
    a.dev.last_tx_end_us = t;
    CHECK(nrf24_cca(&a.dev) == 1);                         /* idle gap (5 % of COT) first */
    CHECK(a.m.now_us - t >= p->idle_us + NRF24_FHSS_CCA_US);
    CHECK(nrf24_send(&a.dev, tx, 32) == NRF24_OK);

    /* Not limited to the hop set: any legal fixed channel (MRM plan, odd ones too). */
    CHECK(nrf24_set_channel(&a.dev, 25) == NRF24_OK);
    CHECK(nrf24_set_channel(&a.dev, 84) == NRF24_ERR_CH);
}

/* 16-Oct review fixes */
static void test_review_fixes(void)
{
    node_t a;
    CHECK(node_up(&a, &NRF24_PROFILE_TEAM_FHSS) == NRF24_OK);
    CHECK(a.m.aw_at_addr == 0x03);                             /* 5-byte width set before the address */

    nrf24_write_reg(&a.dev, 0x06, 0x20 | 0x90 | 0x02);         /* CONT_WAVE + PLL_LOCK requested */
    CHECK((a.m.regs[0x06] & 0x90u) == 0);                      /* masked: no carrier test outside the lab */

    nrf24_start_rx(&a.dev);                                    /* hop while receiving: via standby, back in RX */
    uint32_t t0 = a.m.now_us;
    CHECK(nrf24_set_channel(&a.dev, nrf24_fhss_channel(2)) == NRF24_OK);
    CHECK(a.dev.rx_on == 1 && a.m.ce == 1 && a.m.now_us - t0 >= NRF24_TX_SETTLE_US);

    uint8_t tx[8] = {0};
    CHECK(nrf24_cca(&a.dev) == 1);
    nrf24_start_rx(&a.dev);                                    /* listening ends the occupancy */
    CHECK(nrf24_send(&a.dev, tx, 8) == NRF24_ERR_LBT);
    CHECK(nrf24_cca(&a.dev) == 1);
    a.dev.cot_start_us = a.m.now_us - 0xFFFFFF00u;             /* 71 min ago: used + need would wrap */
    CHECK(nrf24_send(&a.dev, tx, 8) == NRF24_ERR_LBT);
}

static void test_carrier(void)
{
    node_t a;
    node_up(&a, &NRF24_PROFILE_TEAM_250K);
    nrf24_start_rx(&a.dev);
    CHECK(nrf24_carrier(&a.dev) == 0);
    a.m.rpd = 1;
    CHECK(nrf24_carrier(&a.dev) == 1);
}

/* Whole-transaction HAL over the mock, the way the Linux spidev HAL works (select/transfer NULL). */
typedef struct {
    nrf24_hal_t inner;   /* the mock's byte-wise HAL */
    mock_nrf24_t *m;
    unsigned transactions, max_len;
    int preempt_after_tx;   /* 1: the first STATUS read after a TX payload misses TX_DS, then 20 ms pass */
    int armed;
} xfer_wrap_t;

typedef struct {
    mock_nrf24_t m;
    xfer_wrap_t w;
    nrf24_hal_t hal;
    nrf24_t dev;
} xfer_node_t;

static void w_xfer(void *ctx, const uint8_t *out, uint8_t *in, uint8_t n)
{
    xfer_wrap_t *w = ctx;
    w->inner.select(w->inner.ctx, 1);
    for (uint8_t i = 0; i < n; i++)
        in[i] = w->inner.transfer(w->inner.ctx, out[i]);
    w->inner.select(w->inner.ctx, 0);
    w->transactions++;
    if (n > w->max_len)
        w->max_len = n;
    if (out[0] == 0xB0u && w->preempt_after_tx) {
        w->armed = 1;
    } else if (w->armed && n == 1 && out[0] == 0xFFu) {
        in[0] = (uint8_t)(in[0] & ~0x20u);   /* read just before TX_DS rose... */
        w->m->now_us += 20000u;              /* ...then the process was preempted for 20 ms */
        w->armed = 0;
        w->preempt_after_tx = 0;
    }
}
static void w_ce(void *ctx, int high) { xfer_wrap_t *w = ctx; w->inner.ce(w->inner.ctx, high); }
static void w_delay(void *ctx, uint32_t us) { xfer_wrap_t *w = ctx; w->inner.delay_us(w->inner.ctx, us); }
static uint32_t w_micros(void *ctx) { xfer_wrap_t *w = ctx; return w->inner.micros(w->inner.ctx); }

static nrf24_status_t xfer_node_up(xfer_node_t *n, const nrf24_profile_t *p)
{
    memset(n, 0, sizeof *n);
    mock_init(&n->m);
    mock_hal(&n->m, &n->w.inner);
    n->w.m = &n->m;
    n->hal.ctx = &n->w;
    n->hal.select = NULL;
    n->hal.transfer = NULL;
    n->hal.ce = w_ce;
    n->hal.delay_us = w_delay;
    n->hal.micros = w_micros;
    n->hal.xfer = w_xfer;
    return nrf24_init(&n->dev, &n->hal, p);
}

static void test_xfer_hal(void)
{
    /* 18-Oct (Pi 3): the same driver over a whole-transaction HAL. Every profile initialises the same way. */
    for (unsigned k = 0; k < N_PROFILES; k++) {
        const nrf24_profile_t *p = PROFILES[k];
        xfer_node_t n;
        CHECK(xfer_node_up(&n, p) == NRF24_OK);
        for (unsigned i = 0; i < p->n_regs; i++)
            if (p->regs[i].addr != 0x07u)
                CHECK(n.m.regs[p->regs[i].addr] == p->regs[i].value);
        CHECK(memcmp(n.m.tx_addr, p->address, 5) == 0);
    }

    /* Frames between an xfer node and a byte-wise node, both ways. */
    xfer_node_t a;
    node_t b;
    CHECK(xfer_node_up(&a, &NRF24_PROFILE_TEAM_250K) == NRF24_OK);
    CHECK(node_up(&b, &NRF24_PROFILE_TEAM_250K) == NRF24_OK);
    mock_link(&a.m, &b.m);
    uint8_t tx[32], rx[32], len = 0;
    for (unsigned i = 0; i < 32; i++)
        tx[i] = (uint8_t)(i * 11u + 3u);
    CHECK(nrf24_start_rx(&b.dev) == NRF24_OK);
    CHECK(nrf24_send(&a.dev, tx, 32) == NRF24_OK);
    CHECK(nrf24_poll_rx(&b.dev, rx, &len) == NRF24_OK && len == 32 && memcmp(rx, tx, 32) == 0);
    CHECK(nrf24_start_rx(&a.dev) == NRF24_OK);
    CHECK(nrf24_send(&b.dev, tx, 5) == NRF24_OK);
    CHECK(nrf24_poll_rx(&a.dev, rx, &len) == NRF24_OK && len == 5 && memcmp(rx, tx, 5) == 0);
    CHECK(a.w.max_len == 33u);   /* command + 32 B payload, never more */
    CHECK(a.w.transactions > 0);

    /* Preempted between the STATUS read and the deadline check: the frame went out, so no timeout. */
    unsigned sent = a.m.frames_tx;
    a.w.preempt_after_tx = 1;
    CHECK(nrf24_send(&a.dev, tx, 32) == NRF24_OK);
    CHECK(a.w.preempt_after_tx == 0);   /* the race did happen */
    CHECK(a.m.frames_tx == sent + 1u);
    CHECK((a.m.regs[0x07] & 0x20u) == 0);   /* TX_DS cleared */
}

int main(void)
{
    test_crc();
    test_airtime();
    test_profiles();
    test_init_writes_profile();
    test_init_errors();
    test_send_and_receive();
    test_isolation();
    test_limits();
    test_tx_timeout();
    test_power_limit();
    test_carrier();
    test_fhss_profile();
    test_fhss_lbt();
    test_fixed20();
    test_review_fixes();
    test_xfer_hal();
    printf("%d checks, %d failures\n", checks, failures);
    return failures ? 1 : 0;
}
