MicheleLamberti/mtp-f26-teamc/(commit log)

2026-10-13 Decide one omni + E01-ML01SP4 (Santiago with Marcos, 13-Oct): model, power clamp, docs
    - linkbudget.py: SP4_OMNI profile (+7 dBm est., Molex flex omni 2 dBi in box, 0.5 dB cable,
    -96 dBm datasheet), baseline S21-S23: SRI +26.0, MRM +3.4 (+8.3 at 1.0 m), NM +9.9 dB;
    patch scenarios kept as "not chosen". Workbook rebuilt, 0 difference vs Python.
    - phy_config.py: SP4 + omni path checked at 3 dBi peak (<= 9.5 dBm e.i.r.p.), RF_PWR <= -18 dBm
    check, BENCH_WHIP dropped; header exports NRF24_RF_PWR_MAX_BITS.
    - fw: nrf24_init refuses profiles above the power limit (NRF24_ERR_POWER), nrf24_write_reg
    clamps RF_SETUP; tests added (124 checks).
    - DECISIONS: D-R2c (E01-ML01SP4), D-R5c (Molex 1461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
    [MTP-F26_TeamC_Radio_LinkBudget.xlsx]
2026-10-13 Pages for the SP4 + one-omni decision: brief v0.5, hardware v0.4, protocol v0.3.1; PDFs; CLAUDE.md
    - brief v0.5: decision banner, SP4 profiles (<= 9.5 dBm e.i.r.p.), antenna section with the
    decided row, chart/table data regenerated from linkbudget.py, SP4 handoff, shopping list,
    test-plan levels for the omni, actions updated
    - hardware v0.4: one SP4 + flex omni, smaller radio LDO, bench breakout, BoM ~EUR 30-55
    - protocol v0.3.1: module name, two-radio item removed
    - briefs/: v0.5 / v0.4 / v0.3.1 PDFs replace v0.4 / v0.3 / v0.3
    - CLAUDE.md status + session log, README
    Claude-Session: https://claude.ai/code/session_01U9KKjceZdEFpkW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
2026-10-16 D-R6 draft: 20 dBm e.i.r.p. via adaptive FHSS + LBT for SRI/MRM (CNAF UN-85 a, EN 300 328)
    - linkbudget: S24-S26 (SP4 + omni at 20 dBm while hopping; worst RF_PWR step), FHSS goodput
    - workbook rebuilt: 26 scenarios, FHSS block in Throughput, UN-85 a) row; 0 dB diff vs Python
    - phy_config: TEAM_FHSS profile, 29-channel hop set clear of the other teams, EN 300 328 checks
    - fw: power cap per profile, nrf24_cca (RPD), hop-set-only channels, 50 ms COT + idle gap; 194 checks
    - sim: --fhss radio layer (25 ms hops, CCA, busy hops skipped, re-sync); T12/T13, 13/13 pass
    - docs: DECISIONS D-R6, TEST_PLAN v0.4 (T0 all steps, T17, T18), Atenea Q3 rewritten, handoff v0.4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
    [MTP-F26_TeamC_Radio_LinkBudget.xlsx]
2026-10-16 Make 20 dBm hopping (D-R6) the SRI/MRM baseline: a professor approved 20 dBm e.i.r.p.
    - hop guard widened to +-5 MHz (27 channels, nearest hop 6 MHz, C/I -50 dB): at 5 MHz our 20 dBm
    would drown a 10 mW neighbour; near-far printout: >= 15 m from 10 mW teams' boxes at MRM
    - linkbudget/workbook: S24-S26 = SRI/MRM baseline, S23 = NM at 10 mW, S21-S22 = 10 mW fallback (0 dB diff)
    - phy_config: TEAM_FHSS = SRI/MRM, TEAM_250K = Quick Mode/bench/fallback; fw 194 checks; sim 13/13
    - docs: DECISIONS D-R6 baseline, TEST_PLAN v0.5, Atenea Q3 = written confirmation, handoff, READMEs, CLAUDE.md
    - pages: brief v0.7, hardware v0.4.2, protocol v0.3.3 republished; PDFs re-exported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
    [MTP-F26_TeamC_Radio_LinkBudget.xlsx]
2026-10-16 Low-battery countermeasures for the radio LDO; pages brief v0.7.1, hardware v0.4.3, protocol v0.3.4
    The 3.3 V LDO straight from the 3.0-4.2 V cell stays (regulates to ~3.4 V, then passes the cell
    through, >= 2.95 V at cutoff). Added: LDO dropout <= 0.1 V at 150 mA, ideal diode into VSYS so ADC3
    reads the cell, firmware thresholds (3.5 / 3.4 / 3.2 V, never block a round, flush to flash below
    3.2 V), T0 output at 3.6/3.3/3.0 V, buck-boost fallback. CLAUDE.md: keep one branch (main).
    Claude-Session: https://claude.ai/code/session_01MU9yLRr2JqK4PHEE7hWEta
2026-10-16 Atenea Q3 = yes; every team at 20 dBm, so every team hops: brief v0.8, protocol v0.3.5
    - Q3 answered yes: D-R6 confirmed, 'written confirmation' items closed
    - all teams use 20 dBm -> all hop: hop set opened to the 40 even channels 2-80, fixed MRM plan is
    the 10 mW fallback only; near-far back to equal power: >= 10 m between teams' boxes
    - linkbudget: random hop-collision estimate (12 % of pairs at 5-10 m, ~29 % lost ACKs pessimistic)
    - sim T14 (all teams hopping, 30 % loss both ways): all lines in 81 s; 14/14 pass; fw 194 checks
    - docs: DECISIONS (D-R6, D-R4 superseded), TEST_PLAN T15/T18, Q3, NM note, READMEs, CLAUDE.md (NM proof)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
    [MTP-F26_TeamC_Radio_LinkBudget.xlsx]
2026-10-16 NM relay log, usb_msc over FatFs, 20 dBm option B (fixed channel), NM link diagrams
    - nm_gossip relay trace + nm_log.c (NM_LOG.TXT): file id, CRC-32, timings, broadcasts; sim writes and
    checks one per node
    - usb_msc: FatFs R0.15a (vendored, LFN + exFAT), input .txt choice, 4 KB chunked load to a flash sink,
    save via .part + read-back CRC + rename; 96 host checks (FAT16/32/exFAT, full, fault, unplugged) +
    pyfatfs cross-check (make usb-xcheck); Pico TinyUSB/PIO-USB glue as an uncompiled skeleton
    - 20 dBm rechecked: EN 300 328 non-FHSS = 20 dBm AND 10 dBm/MHz PSD + frame-based LBT. Option A (hopping)
    stays default; option B TEAM_20DBM_FIXED built (driver per-profile hop/COT/idle, fw 235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
    [MTP-F26_TeamC_Radio_LinkBudget.xlsx]
2026-10-16 usb_msc: sticks from macOS and Windows (GPT, UTF-8 names), write-protect status
    - FatFs: FF_LBA64 = 1 so GPT sticks (macOS Disk Utility: EFI partition, then the FAT/exFAT one) mount;
    FF_LFN_UNICODE = 2 so any file name a Mac or PC wrote opens (was code page 850 only)
    - disk layer rejects LBAs above 32 bits; USBM_READ_ONLY for write-protected sticks
    - tests: hand-made MBR stick + Greek/Chinese/euro names (109 checks); fat_xcheck.py now also builds MBR
    (sfdisk) and macOS-style GPT (sgdisk) images with .DS_Store/.Spotlight decoys: all identical via pyfatfs
    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
2026-10-16 Review fixes: hop sync in the sim, link/driver/codec/NM bugs, radio model realism
    - sim: per-node crystals (+-30 ppm), master/slave hop timing, parking + re-acquisition, asymmetric loss
    - link: no duplicated tail after a late HELLO; done without END; ACKs ignored while a burst is queued;
    POLL on ACK timeout after a clean window; hopping-aware timers; oversized files send/store the prefix;
    names keep .txt; prepare/commit store callbacks for flash; 30 ms hop slot (burst + ACK fit)
    - driver: SETUP_AW before addresses, CW/PLL test bits masked, channel change via standby, overflow-safe
    COT, CCA ends on RX, RPD read 3x (244 checks)
    - codec: streaming deflate/inflate (RAM fits the RP2350); NM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
    [MTP-F26_TeamC_Radio_LinkBudget.xlsx]
2026-10-17 NM interop spec v1.0 for all teams; protocol specs section; pages after the review
    - radio/NM_SPEC.md + nm_spec.html (new artifact): NM radio registers in hex (RF_CH 77),
    frame, Trickle gossip rules, CRC-16/CCITT-FALSE, 3-frame test vector, interop test
    - nm_gossip: complete only when the whole-file CRC equals file_id; sim T18 decodes the
    spec's test vector
    - pt v0.3.7: "Protocol specs" table (where each interface is defined), POLL, streaming
    codec, 107 kbps goodput, current sim results
    - brief v0.10: conservative planning case, 37 hops / 30 ms, NM ch 77, near-far with the
    two-ray peak, Q12-Q21; hw v0.4.4: TX/RX role switch, U.FL secured
    - NM_PHY_PROPOSAL.md now points to NM_SPEC.md;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
2026-10-17 CLAUDE.md and README: 17-Oct status, deduplicated next steps, spec index
    - CLAUDE.md: calendar milestones (23-Oct, 6-Nov, 20-Nov), key results and planning case
    in one place, D-R4 shown as superseded, open decisions and "Next up" deduplicated
    - README: status for 17-Oct with the planning-case caveat, a "Specs" table pointing at
    each interface's source file, quick-start simulator commands that run from proto/
    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
2026-10-18 Pi 3 switch page v0.1, sim --reboot-down + T19, Atenea Q22
    The team wants a Raspberry Pi 3 instead of the Pico 2. New page radio/pi3_impact.html
    (assumes the WiFi/BT chip is disabled or desoldered): power tree, variant pick, Pi pin
    map, Linux port, timing, goodput, reboot cost, mechanics, BoM delta. Simulator gets a
    per-reboot downtime option and T19 (MRM with a 30 s Linux reboot: 90.8 s).
    Claude-Session: https://claude.ai/code/session_01NEQxpfkNmK7c5ewHmfrotr
    [main.c]
2026-10-18 Pages and docs for the Raspberry Pi 3: brief v0.11, hw v0.5, pt v0.4
    The team wants a Raspberry Pi 3 instead of the Pico 2 (WiFi/BT chip disabled
    or desoldered, Atenea Q22). Hardware page: Pi 3 + SP4 HAT, 5.1 V boost,
    MAX17048 fuel gauge, BoM 70-90 EUR. Protocol page: Linux architecture
    (spidev/libgpiod HAL, threads, SD-card store, FatFs on the raw stick).
    Brief: Pi pins, T0 Pi-noise check, T2 frame gap. KiCad brief rewritten for a
    HAT; HANDOFF_ET v0.5; DECISIONS D-H1; TEST_PLAN; READMEs; PDFs re-exported.
    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
2026-10-18 Linux HAL for the Pi 3 (spidev + GPIO uAPI v2) and nrf24_probe bench tool
    nrf24_hal_t gets an optional whole-transaction xfer callback, so a spidev HAL
    does one ioctl per radio command with the kernel driving CSN; the mock stays
    byte-wise and a wrapper test runs the driver through xfer. nrf24_send re-reads
    TX_DS after its deadline so a preempted Linux process does not report a sent
    frame as a timeout (regression test fails without the fix). radio/fw/linux:
    the HAL (CE/IRQ on the GPIO chardev with edge timestamps, busy-wait delays,
    SCHED_FIFO helper) and nrf24_probe (init, survey, tx, rx, timing) for T0, T2
    and T14. Not yet run on a Pi. 318 fw checks.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
    [mock_nrf24.c, nrf24.c, nrf24_hal_linux.c, nrf24_hal_linux.h, nrf24_probe.c, test_main.c]
2026-10-18 Pi 3 port finished: teamc-node, real hop acquisition, SD store, stick, UI, e2e tests
    proto/port/linux: the complete Raspberry Pi 3 program (setup from the stick,
    GO, SRI/MRM/NM, STOP, save, resume after a reboot), a radio layer with real
    FHSS acquisition (timing estimate + 1-byte hop-0 beacon, frames attributed by
    start time), nRF24 and UDP-emulated radio backends, an SD-card store with a
    two-slot CRC progress record and a non-blocking sync thread, the stick as a raw
    block device (O_DIRECT, write-protect), GPIO UI with a 3-position mode switch,
    MAX17048, systemd unit + installer. mkstick + e2e.sh run whole nodes against
    each other: 6 scenarios pass (SRI, MRM, receiver/sender reboots, NM 3 no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
    [mkstick.c, node.c, phy.h, phy_nrf24.c, phy_udp.c, radio.c, radio.h]
2026-10-19 Antenna A/B test T5b (Molex vs Ebyte TX2400-FPC-2509), SP4 sourcing
    D-R5c: the Molex flex omni stays the baseline; Ebyte's own flex antenna (sold as
    an SP4 bundle) is ordered with the modules and compared by attenuation to failure
    before Quick Mode (TEST_PLAN v0.6 T5b). D-R2c: order list with the Ebyte bundles,
    Molex from an EU distributor, SMA pads; where to buy the SP4 (no EU distributor).
    HANDOFF_ET and the KiCad brief mention the candidate; CLAUDE.md status and log.
    Claude-Session: https://claude.ai/code/session_01JfXNg5QBtu9WExGTMU9UMv
2026-10-19 Ordered: 2 Pi 3 A+, 4 SP4 (2 Ebyte flex, 2 rod kits); Ebyte flex is the working antenna
    D-R5c: the Ebyte TX2400-FPC-2509 that came with the modules is the box antenna;
    the Molex is the fallback, bought only if the Ebyte flex fails T5b. T5b is now an
    acceptance test (VNA S11 and substitution gain if available, 70 m attenuation to
    failure against the model and the JKS rod; Molex A/B only on a fail). D-H1: two
    A+ ordered. HANDOFF_ET, KiCad brief, phy_config comment, CLAUDE.md.
    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
2026-10-19 Fix: the two rod-kit SP4s are spares; only the flex antenna has no spare
    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
2026-10-19 KiCad session prompt v2 (lead + subagents, tools verified); microSD choice; session close
    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
2026-10-19 hw: schematic generator + netlist-to-board script, carrier project from the HAT template, design notes skeleton
    Claude-Session: https://claude.ai/code/session_01Dy4TuRNF8V28KreA3jwCtM
    [teamc-carrier.kicad_pcb, teamc-carrier.kicad_sch]
2026-10-19 hw: checkpoint 1 package (research merged: SP4 14.5 mm + pad layout, power chain, UI, budget, placement)
    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
2026-10-19 hw: teamc library (E01-ML01SP4 from the manual drawing, MAX17048) + SP4 breakout (single-sided, ERC/DRC 0, gerbers, 1:1 copper PDFs)
    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
    [sp4-breakout-B_Silkscreen.gbr, sp4-breakout-Edge_Cuts.gbr, sp4-breakout-F_Cu.gbr, sp4-breakout-F_Mask.gbr, sp4-breakout-F_Silkscreen.gbr, sp4-breakout-NPTH.drl, sp4-breakout-PTH.drl, sp4-breakout-job.gbrjob]
2026-10-19 SP4 is 14.5 x 18 mm with 8 castellations + 2 GND half-holes (manual drawing); carrier placement script
    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
2026-10-19 carrier: radio, pi_header, ui sheets (ERC 0 each); schgen field placement, GND orientation, STANDALONE flag
    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
2026-10-19 carrier: power sheet, full schematic (ERC 0), placement, grid router, header/SP4/boost escapes, 1.5 mm-pad socket
    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
    [pi_header.kicad_sch, power.kicad_sch, radio.kicad_sch, teamc-carrier.kicad_sch, ui.kicad_sch]
2026-10-19 carrier: review fixes (Si2333DDS, BCM857BS, fuse, soft start, D_SMF, pull-ups to 3V3_PI, MODE->VIN), power+SPI routed (DRC 0 errors), GND vias, BoM, design notes; CLAUDE.md session log
    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
    [BOM.csv, pi_header.kicad_sch, power.kicad_sch, radio.kicad_sch, teamc-carrier.kicad_pcb]
2026-10-19 Fix GCC file deleter compilation in encoding CLI
    [main.cpp]
2026-10-19 carrier: re-placed in clusters, boost GND pocket fixed, SP4 keep-out on both layers, power+SPI routed (DRC 0 errors); small nets handed to ET; JLCPCB-class 0.2 mm rules
    - removed SW1 (bench button), J21 (2nd cell -> harness), D1 (VBUS ESD on U12's spare channel)
    - router: rip-up/reroute + negotiated congestion options (neither finished the small nets at 0.3 mm)
    - design notes: hand-off list for ET, fab rules, layout-driven changes; BoM ~EUR 102/device
    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
    [BOM.csv, power.kicad_sch, teamc-carrier.kicad_pcb, ui.kicad_sch]
2026-10-19 hw page v0.6: the KiCad carrier (status, renders, BoM-based parts, fab rules, asks to ET); date labels fixed
    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
    [power.py, route_carrier.py]
2026-10-21 carrier: routing finished (0 unconnected); Freerouting + finishing pass; 3D models and render script
    - net classes: only real power nets wide (/power/* caught gate/LED nets at 1 mm); PowerFine/FinePitch split,
    Ground class (ignored by the autorouter)
    - autoroute_carrier.py: Freerouting via Specctra DSN/SES, merge of the autorouted nets only, padded
    clearances, GND stitching + KiCad-connectivity island links
    - finish_carrier.py: the few boxed-in pins by hand (EP ties, FG_ALRT escape, L2 turned, C15 turned,
    3V3_RADIO via moved, R15 feed rerouted), grid router from existing copper, ground passes, dangling clean-up
    - 3D: fetch_3d.py, teamc.3dshapes (SP4, MAX17048, JST-VH, simplified Pi 3 A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
    [teamc-carrier.kicad_pcb]
2026-10-21 carrier rev A: DRC 0/0/0, silkscreen, 3D models applied, fab outputs; hw page v0.7; docs
    - silk_carrier.py: 59 references on the silkscreen at 1.0/0.8 mm, 26 on F.Fab; bottom text rev A 21-Oct-26
    - render_board.py --apply-models on both boards (SP4, MAX17048, JST-VH bodies; substitutes for models missing
    upstream); renders top/bottom/iso + HAT on the Pi 3 A+
    - fab_carrier.py: gerbers, Excellon drill + maps, KiCad pos + JLCPCB CPL (DNP out), assembly + copper PDFs, BoM,
    teamc-carrier_gerbers.zip
    - SP4 breakout: U1 refreshed from the library (it gained its 3D model): DRC 0 again
    - DESIGN_NOTES: routing pipeline, net classes, state on 21-Oct with 5 review points for ET; CLAUDE.md, README
    -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
    [sp4-breakout.kicad_pcb, teamc-carrier-BOM.csv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]
2026-10-22 Pi setup template: secrets stay in Raspberry Pi Imager; Pi Connect off before QM; data partition note
    Claude-Session: https://claude.ai/code/session_018zaeicTSHb3hAodd6pzAi6
2026-10-22 CLAUDE.md: Pi C2 configured (SPI/I2C/BT off/core_freq/isolcpus); under-voltage on the current supply
    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
2026-10-22 Docs: connecting to the team's Pis (SSH, keys, WiFi, shutdown, power); .env.example per box
    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
2026-10-22 Pi C1 configured like C2; README connecting table and power note
    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
2026-10-22 PI_ACCESS.md: team hotspot teamc-pi on both Pis (tested), serial console ready, sudo cache, power notes
    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
2026-10-23 SP4 breakout: 2.0 mm header pads and no pour between C1's pads (UPC lab rules)
    - J1/J2 use teamc:PinHeader_1x08/1x02_P2.54mm_Vertical_Pad2.0mm, written by
    build_breakout.py from the stock headers (1.7 -> 2.0 mm pads, 1.0 mm drill
    kept, pin 1 square): hole + 1.0 mm, 0.54 mm between pads at 2.54 mm pitch.
    A library copy rather than a board override, so DRC's library-parity check
    stays clean.
    - FR10: a no-fill rule area in C1's 2.1 mm pad gap (the only SMD gap the pour
    reached); SP4 castellations and the 0805 gaps had no pour.
    - build_breakout.py restores the lab floor (0.3 mm clearance/track, 2 thermal
    spokes) after set_project_rules, which lowered it for the carrier.
    - Regenerated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
    [sp4-breakout-B_Silkscreen.gbr, sp4-breakout-Edge_Cuts.gbr, sp4-breakout-F_Cu.gbr, sp4-breakout-F_Mask.gbr, sp4-breakout-F_Silkscreen.gbr, sp4-breakout-NPTH.drl, sp4-breakout-PTH.drl, sp4-breakout-job.gbrjob]
2026-10-23 Carrier rev B for the UPC lab mill: set-up (modules, sheets, ERC 0, unplaced board)
    Hand-soldered modules (Pololu U3V70F5 boost, Pololu #5388 ideal diode, Adafruit
    MAX17048 #5580) with pads from the makers' CAD, AP2112K radio LDO enabled by the
    Pi's 3V3, 2x20 IDC ribbon to the Pi, SP4 breakout plugged into a 1x8 socket,
    TP4056 charger off-board. Lab footprint copies with pad = hole + 1.0 mm, lab
    rules and net classes in the project. build_carrier_lab.py builds it all; the
    place/route/DRC/fab loop is hw/REVB_LOOP_PROMPT.md. Plan: hw/REVB_LAB_PLAN.md.
    CLAUDE.md: 23-Oct status, open items, session log.
    Claude-Session: https://claude.ai/co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
    [pi_link.kicad_sch, power.kicad_sch, radio.kicad_sch, teamc-carrier-lab.kicad_pcb, teamc-carrier-lab.kicad_sch, ui.kicad_sch]
2026-10-23 KiCad 10 project defaults in the breakout and rev A .kicad_pro (added when opened/checked, no design change)
    Claude-Session: https://claude.ai/code/session_01PKzvcoWGaf5niy6TrXYsya
2026-10-23 Carrier rev B (UPC lab): placed and routed on one copper layer, DRC 0/0/0
    - place_carrier_lab.py: fixed floorplan (power right, J1 centre, SP4 socket top-left
    edge, UI leads left edge, fuel gauge bottom-left); provisional 100 x 80 mm outline
    until the box is measured.
    - linkroute.py: single-layer grid router whose second "layer" is straight wire links
    (bare wire on the component side between two unplated holes).
    - route_carrier_lab.py: hand-coded power path, SCK swap under R84/R83, left half; the
    rest routed in a topology order, --search over the band-net orders.
    - finish_carrier_lab.py: GND pour (0.4 mm), FR10 no-fill areas, M3 keep-outs, ground
    island joins, links -> W parts (one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
    [BOM_revB.csv, pi_link.kicad_sch, power.kicad_sch, radio.kicad_sch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]
2026-10-23 Carrier rev B review fixes: charger on VBAT, insulated links, SPI at 4 MHz
    - J23 (TP4056 lead) back on VBAT behind F1/Q1: placed between the VBAT line and
    C5, GND to C5's ground pad, R1 now returns to J20's GND pin. A reversed cell no
    longer reaches the charger and the lead is fused.
    - Wire links: insulated 22 AWG solid hook-up wire, not bare (schematic note, W
    MPN, WireLink footprint text, BoM, shopping list).
    - Ribbon grounds: tying J1 20/25 to the pour was tried; the inner pocket of J1's
    escape ring (LEDs, pins 20/25) has no legal wire link, the outer pockets would
    cost 3 more. Kept as before and SPI defaults to 4 MHz instead (teamc-node
    --spi-hz, NRF24_LINUX_CFG_DEFAULT; was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
    [BOM_revB.csv, pi_link.kicad_sch, power.kicad_sch, teamc-carrier-lab.kicad_pcb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]
2026-10-23 Carrier rev C (simple): checkpoint 1 concept - block diagram, parts per block, draft BoM, floorplan sketch
    Modules + through-hole only: Pololu U3V70F5 boost with the panel toggle on EN, Pololu #5388 ideal
    diode, MCP1700 TO-92 LDO for the radio fed from 5V_PI, Adafruit #5580 gauge, 4 A axial fuse +
    1N5822 crowbar, 18650 holder on the board, TP4056 USB-C at the wall, SP4 breakout in a 1x8 socket.
    One copper layer; no GPIO changes. Proposal for Santiago's checkpoint 1.
2026-10-23 Carrier rev C (simple): checkpoint 2 - schematic (ERC 0/0), BoM with supplier links, review fixes
    hw/teamc-carrier-simple: 4 sheets generated by hw/scripts/build_carrier_simple.py (power, pi_link, radio,
    ui), 46 parts, all through-hole or modules (no SMD pad), every THT pad >= hole + 1.0 mm. Cell holder on
    the board, 5x20 fuse in clips, 1N5822 crowbar, U3V70F5 with the panel toggle on ENABLE, #5388 ideal
    diode, MCP1700 TO-92 from 5V_PI, Adafruit #5580, all 8 header GND pins tied, pin map unchanged.
    Lab copies of 4 stock THT footprints (gen_lab_revc.py). hw/BOM_revC.csv (build_bom_revc.py): about
    EUR 145 per box excl. VAT. schgen: title-block date settable (default unchanged for rev A/B).
    Rev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
    [BOM_revC.csv, pi_link.kicad_sch, power.kicad_sch, radio.kicad_sch, teamc-carrier-simple.kicad_pcb, teamc-carrier-simple.kicad_sch, ui.kicad_sch]
2026-10-23 Carrier rev C (simple): checkpoint 3 - placed and routed on one copper layer, DRC 0/0/0, 4 wire links
    120 x 66 mm (box not measured yet: hw/scripts/layout_carrier_simple.py rebuilds everything after the
    outline in place_carrier_simple.py changes). Backbone hand-routed (route_carrier_simple.py), router for
    the short branches, GND pour; DRC with schematic parity 0 violations / 0 unconnected / 0 parity, all
    severities; ERC 0/0. Tracks 0.8-2.0 mm. Wire links: IRQ over CSN and three ground pockets. Crossings by
    tracks between resistor legs (SCK under R84/R83, LED_ACT_A under R61, CSN/IRQ under R57).
    Layout-driven schematic changes: input 100 nF caps dropped, C18 at the toggle lead, 7.62 mm resist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
    [BOM_revC.csv, pi_link.kicad_sch, power.kicad_sch, radio.kicad_sch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]
2026-10-24 Carrier rev C (simple): checkpoint-3 fixes (P4KE10A TVS per panel lead, wire-loop test points), board 120 x 68 mm, build guide and shopping list
    - D12-D16 P4KE10A (DO-41 standing) at the panel-lead connectors; TP2/TP3/TP4 low wire loops (TP2/TP4 under the breakout)
    - J13 UART order kept as rev A/B (1 GND, 2 TX, 3 RX); ui.py docstring fixed
    - layout: TVS rows, R56/CSN lowered, board 66 -> 68 mm so the GND pour keeps a >= 1.9 mm channel between its halves
    - own 3D stand-in for the 3.81 mm vertical DO-41 (none upstream); ERC 0/0, DRC 0/0/0, 4 wire links, renders resolved
    - hw/REVC_GUIDE.md, hw/REVC_SHOPPING.md, DESIGN_NOTES rev C section, BoM EUR 145.51/box; reviewer fixes in the guide
    Co-Auth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
    [BOM_revC.csv, power.kicad_sch, teamc-carrier-simple.kicad_pcb, ui.kicad_sch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]
2026-10-24 Rev C: TP2 away from the breakout's downward J2 pins; 'no J2 on box breakouts' in guide + drawing
    The SP4 breakout's own 1x2 bench header J2 points down and its pins end ~2.5 mm
    above the carrier, right over TP2 (5 V loop): one touch put 5 V on the radio's
    3.3 V. TP2 moved below C11 (>= 3.7 mm from the J2 pins, no copper within 2 mm),
    the 5 V stub shortened; guide (sections 2, 4E, common mistakes) and the placement
    drawing say not to fit J2 on box breakouts. DRC 0/0/0, 4 links, BoM unchanged.
    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
    [teamc-carrier-simple.kicad_pcb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]
2026-10-24 Rev C placement drawing: the 40-wire ribbon to the Pi (red wire = pin 1, J1 pin 1 marked)
    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
2026-10-24 Rev C: order-ready DigiKey cart + order check; C1/C9 -> KEMET ESS107M016AE2EA, red LED -> WP7113SURDK
    - hw/teamc-carrier-simple/order/: digikey_cart.csv (BOM Manager upload, 3 boards incl.
    spares), order_check.md (per-line PN/stock/price, 24-Oct), other_shops.md (Kiwi, nkon,
    TP4056 options).
    - EEU-FR1C101 is 5 mm / 2.0 mm leads and did not fit the 6.3 mm / 2.5 mm footprint; the
    exact Panasonic is out of stock until Dec -> KEMET ESS107M016AE2EA (C1/C9 sit outside
    the breakout area, 8.5 mm tall is fine). WP7113ID out of stock -> WP7113SURDK.
    - Standoffs, nylon screws and LED clips sourced at DigiKey; cell (nkon) and ribbon (Kiwi)
    linked. BoM EUR 148.00/box. REVC_SHOPPING.md: how to o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
    [BOM_revC.csv, digikey_cart.csv, power.kicad_sch, teamc-carrier-simple.kicad_pcb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]
2026-10-24 Rev C order: Adafruit #4410 charger in the DigiKey cart, Pi M2.5 kit from Kiwi, switches from TME
    No TP4056 USB-C board with protection was orderable on 24-Oct (TinyTronics 2-4 weeks,
    Grobotronics/Electrokit out, Amazon.es 3-pack apparently out). Santiago chose the Adafruit
    Micro-Lipo USB-C #4410 (DigiKey 1528-4410-ND, 966 in stock; 500 mA jumper, ~7-8 h; the
    protected 18650 has its own protection). That put the box at EUR 150.45, so the panel
    switches move to TME (his budget lever) -> EUR 148.29/box. Pi standoffs: Kiwi KW-2754 nylon
    M2.5 set (DigiKey M2.5 screws removed from the cart).
    Cart, other_shops.md, order_check.md (update section), REVC_SHOPPING.md (four orders,
    ~EUR 253 excl. for 3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
    [BOM_revC.csv, digikey_cart.csv, power.kicad_sch, teamc-carrier-simple.kicad_pcb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]
2026-10-24 Rev C: don't rely on a keyed ribbon - line up the pin-1 wire at both ends and beep-check
    Kiwi 1160 (checked 24-Oct) plugs onto the Pi's 40-pin header (female sockets) but keying
    is not stated anywhere, and an unkeyed plug can go into J1 turned round (5 V onto the Pi's
    pins 39/37). Guide: overview row, step F (marked wire on pin 1 at both ends, where pin 1 is
    on the Pi and on J1, J1 pin 2 <-> Pi pin 2 beep check before power), common-mistakes row.
    Shopping list / other_shops: female-female noted, keying not needed. Drawing: caption, 20 cm.
    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
