MicheleLamberti/mtp-f26-teamc/(notices)

Notices in the files:
parts and their libraries:
Maxim/ADI MAX17048 fuel gauge, TDFN-8-EP 2x2x0.75 mm (T822+3, outline 21-0168), land per 90-0065: pads 0.30x0.70 P0.5, rows 1.98 c-c, EP 0.8x1.38 (pad 9 = GND); pinout datasheet 19-6171 rev 7 p.6. Based on partreel.com max17048, CC-BY-4.0; EP paste split into 4 windows (~60 %)
